nikarus/levitating_chess/levitating_chess_scientific_article_titles.md

# Scientific article title list for the levitating-chess / planar-motor research

## Core articles we directly used or discussed

1. **Modeling and comparison of the Halbach array with different segments per pole**  
   Yunfei Zhou, Guangdou Liu, Rougang Zhou, Ligang Huo, Wuyi Ming.  
   *International Journal of Applied Electromagnetics and Mechanics*, 2015.

2. **Modeling of magnetically levitated planar motors with moving magnets**  
   J.W. Jansen, C.M.M. van Lierop, E.A. Lomonova, A.J.A. Vandenput.  
   *IEEE Transactions on Magnetics*, 2007.

3. **Magnetically levitated planar motor with moving magnets**  
   J.W. Jansen, C.M.M. van Lierop, E.A. Lomonova, A.J.A. Vandenput.  
   *IEEE Transactions on Industry Applications*, 2008.

4. **On Improved Commutation for Moving-Magnet Planar Actuators**  
   Yorick Broens, Hans Butler, Roland Tóth.  
   2023.

## Closely related articles from the Halbach/planar-motor reference chain

5. **Analytical force calculations for high-precision planar motor with Halbach array**  
   H. Jiang, X. Huang, G. Zhou, Y. Wang, Z. Wang.  
   *IEEE Transactions on Magnetics*, 2009.

6. **Electro-dynamic planar motor**  
   J.C. Compter.  
   *Precision Engineering*, 2004.

7. **Analytical model of a magnetically levitated linear motor**  
   J.W. Jansen, E.A. Lomonova, A.J.A. Vandenput, C.M.M. van Lierop.  
   Industry Applications Conference, 2005.

8. **Design of a Halbach array based on optimization techniques**  
   J.S. Choi, J. Yoo.  
   *IEEE Transactions on Magnetics*, 2008.

9. **Analysis and optimization of a new 2-D magnet array for planar motor**  
   W. Min, M. Zhang, Y. Zhu, B. Chen, G. Duan, J. Hu, W. Yin.  
   *IEEE Transactions on Magnetics*, 2010.

10. **Modeling, analyzing, and parameter design of the magnetic field of a segmented Halbach cylinder**  
    T. Shi, Z. Qiao, C. Xia, H. Li, Z. Song.  
    *IEEE Transactions on Magnetics*, 2012.

## Older foundational Halbach / magnetic-array papers

11. **Design of permanent multipole magnets with oriented rare earth cobalt material**  
    K. Halbach.  
    *Nuclear Instruments and Methods*, 1980.

12. **Magnet arrays for synchronous machines**  
    D.L. Trumper, M.E. Williams, T.H. Nguyen.  
    IEEE Industry Applications Society Annual Meeting, 1993.

13. **Modeling maglev passenger compartment static magnetic fields from linear Halbach permanent magnet arrays**  
    J.F. Hoburg.  
    *IEEE Transactions on Magnetics*, 2004.

14. **Characteristic analysis of eddy-current brake system using the linear Halbach array**  
    S.M. Jang, S.H. Lee, S.S. Jeong.  
    *IEEE Transactions on Magnetics*, 2002.

15. **Comparison of coaxial magnetic gears with different topologies**  
    L. Jian, K.T. Chau, Y. Gong, et al.  
    *IEEE Transactions on Magnetics*, 2009.

16. **A novel linear and rotary Halbach permanent magnet motor with two degrees-of-freedom**  
    P. Jin, S. Fang, H. Lin, X. Wang, S. Zhou.  
    *Journal of Applied Physics*, 2012.

## Notes

- The most important articles for the actual chessboard actuator are probably titles 1–4.
- Titles 5–10 are useful for deeper Halbach/planar-motor modeling.
- Titles 11–16 are background/foundational references that may be useful when building the literature map.
- Separately from scientific articles, the important industrial systems to study are **Beckhoff XPlanar**, **B&R ACOPOS 6D**, and **Planar Motor / PlanarMotor** documentation.
