nikarus/levitating_chess/methodology/docs/MODELING_APPROACH.md

# Modeling scope and current evidence

The [simulator reference](SIMULATOR.md) owns architecture and verification rules; the [single-piece checklist](SINGLE_PIECE_TESTS.md) owns behavioral coverage; [NEXT_STEPS.md](../NEXT_STEPS.md) owns execution order. This document records current engineering evidence, its limits and the tool choices still in effect. Quantitative settings remain in the model parameter classes. Complete the virtual design before manufacturing or physical tests.

## Physical-model verification gate

**The bounded implementation-verification gate is complete; whole-product and hardware validation are not.** The [original verification record](../results/physics_verification/implementation_verification/summary.json) and [joint-integrator qualification](../results/physics_verification/joint_passive_filter/qualification.json) support single-piece airborne investigation with CAD geometry, averaged drivers and causal Hall/current sensing. Atlas acceleration has separate evidence below.

The supported local model uses the square-coil patch and CAD-derived king. Runtime guards enforce the configured gap/current/domain bounds, tilted-bottom clearance, finite states and supported current extinction. Contact, reconduction and changing the controlled coil window remain outside this airborne path. Numerical verification does not establish unknown materials, component specifications, controller robustness or every possible trajectory.

| Verified mechanism | Authoritative evidence |
|---|---|
| CAD mechanics, coordinate frames, clocks, causality and replay | Component checks and recorded selections in the [simulator reference](SIMULATOR.md#general-properties-and-existing-checks) and frozen verification records |
| Curved-conductor force/torque and spatial refinement | [Curved force and independent flux derivative](../results/physics_verification/implementation_verification/curved_force/summary.json) |
| Force/back-EMF reciprocity, winding work and coupled dynamics | [Independent coupling references](../results/physics_verification/implementation_verification/independent_coupling/summary.json) |
| Joint temporal integration, switching, passive Hall filter and restart | [Joint qualification](../results/physics_verification/joint_passive_filter/qualification.json) and [combined sensor budget](../results/physics_verification/joint_passive_filter/verified_sensor_budget/summary.json) |
| Atlas field/force accuracy and closed sensor feedback | [Field screen](../results/hover/joint_control/atlas_backend/fields/summary.json), [coupled comparison](../results/hover/joint_control/atlas_backend/coupled/summary.json) and [combined sensing check](../results/hover/joint_control/atlas_backend/sensing/summary.json) |

These are sampled and bounded comparisons, not a rigorous global error certificate. The joint sensing benchmark's largest combined discrepancies are 0.206/0.214 µT against its unchanged 0.566 µT allowance. The atlas startup sensing check reaches 0.18105 µT under that same allowance. Conductor, trajectory, temporal/filter and independent-reference contributions are included without relying on cancellation. Energy consistency supplements state and field checks; it cannot alone establish trajectory accuracy.

Source, dependency and parameter identities in each record belong to that execution. Source archives preserve reproducibility across later edits, including output-path cleanup. Never replace recorded fingerprints or resume an old checkpoint with changed sources. A newly configured run needs its own provenance and compatible cache.

## Current motion interface

The [MuJoCo scene](../results/motion_scene.xml), [preview](../results/motion_scene.png) and [contact demonstration](../results/motion_scene.mp4) reuse the square assembly's mass, centre of mass and full inertia tensor. The [motion interface record](../results/motion.json) checks analytical force/rotation, free fall, contact impulse and a short prescribed-current magnetic case. The video is an unpowered drop/slide diagnostic, not controlled flight.

Contact uses a bottom-film cylinder and an interior-board plane with provisional friction/compliance. Piece-to-piece contact, board edges, deformation and detailed material damping remain unqualified. The [moving Hall screen](../results/sensing.json) retains a failed finer-resolution landing comparison; airborne success does not close this contact limitation. Geometry and construction uncertainties are maintained in [COILS.md](COILS.md).

## Current Hall interface

Sequential Hall sampling, analogue filtering, ADC rounding, calibration errors, noise and delayed delivery are represented. The estimator uses measured currents for coil-field subtraction and nominal geometry for pose estimation. It receives no true pose or hidden plant properties. The architecture and timing contract live in [SIMULATOR.md](SIMULATOR.md#scope-and-information-flow).

The retained [single-count response](../results/hover/count_response_extended/summary.json) shows why digital trace identity is not equivalent to physical tracking: one changed Hall ADC count produced persistent current differences while both trajectories stayed within operating limits over the recorded interval. This is bounded disturbance evidence, not general recovery qualification. Preserve physical noise and hardware quantization during numerical comparisons; do not use numerical error as a substitute for real interference.

## Joint integration review

The [reduced solver comparison](../results/physics_verification/solver_review/summary.json) supports RK45 as the joint integration starting point against independent DOP853/Radau references. It uses manufactured coupling equations and cannot predict full CAD-field performance. The [interior-release diagnosis](../results/hover/interior_release/diagnosis.json) records the duration-dependent cost of the earlier partitioned work-budget method. Those legacy paths remain for their reference checks; they are not the current flight runner.

## Joint integration candidate

The verified [joint method](SIMULATOR.md#joint-integration-candidate) integrates mechanics, winding currents, command filtering and work together, then resolves the passive Hall filter along the dense trajectory. The [qualification record](../results/physics_verification/joint_passive_filter/qualification.json) includes independent temporal/energy references, current extinction, sensor timing and exact restart with pending samples. It replaces the affected partitioned-method checks without relaxing acceptance limits. The controlled hover and local movement below use this method.

## Current airborne interface

| Retained trial | Measured outcome | Scope |
|---|---|---|
| [Direct-field hover](../results/hover/joint_control/summary.json) | 50 ms; all operating/energy limits pass; 49 moving scans; 21.92 h runtime | Direct comparison reference |
| [Accelerated hover comparison](../results/hover/joint_control/atlas_backend/hover/comparison.json) | Same 50 ms; all operating and comparison checks pass; 4.69 h runtime, 4.68× complete-run acceleration | Verified acceleration of this nominal hover |
| [Native hover comparison](../results/hover/native_spline/qualified/trial/comparison.json) | Same 50 ms; all operating, energy, trajectory and analogue checks pass; 61.3 min runtime, 4.59× faster than the SciPy atlas run | Verified native runtime for this nominal hover |
| [Local movement](../results/local_motion/trial/summary.json) | 60 ms including a 0.3 mm sideways move and 0.01 rad yaw; all operating/energy limits pass; 59 moving scans; 6.18 h runtime | First short combined commanded movement |

The local movement reaches peak physical tracking errors of 67.72 µm and 3.067 mrad, peak current 2.431 A, voltage 1.352 V and instantaneous copper loss 8.347 W. Its accumulated absolute total-energy discrepancy is 0.600 nJ against 22.29 nJ. The [tracking plot](../results/local_motion/trial/tracking.png) shows overshoot within limits; endpoint error and velocity remain nonzero, so the short hold does not establish settling. The [multiview replay](../results/local_motion/trial/motion.mp4) uses saved poses with labeled slowdown and no motion exaggeration.

The movement's [field cache verification](../results/local_motion/fields/summary.json), stationary-prefix comparison and [saved-evidence verification](../results/local_motion/trial/verification.json) retain field/force/gradient checks, report/checkpoint agreement, source/archive identity and exact dense current/filter reconstruction. Exact executed sources and raw scans remain with the trial. No noise, control gain, hardware rate or acceptance limit was changed for this movement.

The local controller currently holds a fixed coil/sensor window. Stationary Hall acquisition precedes release, winding currents start at zero, and all subsequent support comes from modeled electromagnetic forces. Sustained control, endpoint settling, large rotations/tilts, handoffs, takeoff/landing, neighbours and full-board movement remain unqualified. The [legacy stacked reference](QUALIFICATION.md) describes a different geometry and must not supply current square-coil hardware ratings.

The [longer move-and-hold trial](../results/local_motion/settling/trial/verification.json) **fails angular settling**. It retains the same 0.3 mm translation and 0.01 rad yaw command, completed at 50 ms, followed by a planned 200 ms hold. The final 100 ms observation window uses the existing 160 µm position and 0.005 rad orientation limits, plus provisional residual-speed limits of 1.6 mm/s and 0.05 rad/s derived from one pose-error budget over that window. These are initial settling criteria, not validated product vibration requirements. Accepted integration endpoints and midpoints first exceed the angular-speed limit at approximately 190.606 ms; the checkpoint guard stops the run at 191 ms, before the requested 250 ms. Peak angular speed in the observed settling window is 0.052986 rad/s (3.036°/s) against 0.05 rad/s (2.865°/s). Position error, orientation error and linear speed in that window peak at 50.95 µm, 0.001517 rad and 1.028 mm/s. Overall peak current is 2.440 A and peak voltage is 1.358 V. All 190 independent sensing checks pass, with maximum combined error 0.05824 µT against 0.100 µT; accumulated total-energy defect is 2.86e-9 J against 2.23e-8 J.

The [saved-motion analysis](../results/local_motion/settling/trial/settling_analysis.json) and [settling plot](../results/local_motion/settling/trial/settling.png) show continuing small angular motion with reversals, without monotonically increasing window peaks. The record does not establish eventual recovery. The [multi-view replay](../results/local_motion/settling/trial/video.mp4) includes perpendicular gap views, labels the failed outcome and uses the last recorded command-rate pose at 190.75 ms; the dense trajectory and checkpoint extend to 191 ms. Cache preparation takes 2,503 s, simulation/recording 5,653 s plus 130 s setup, and independent sensing verification 1,057 s. The failed evidence and acceptance limits remain unchanged.

The [feedback replay](../results/local_motion/settling/feedback/summary.json) exactly reproduces the recorded observer state, noise sequence and poses, and reconstructs current commands within floating-point roundoff. At 190.5 ms, actual pitch velocity is −2.45°/s while the estimate is +0.90°/s, so the velocity damping contribution acts in the wrong direction. Current-command quantization contributes substantially less angular-acceleration variation than velocity-estimation error. The [sensor isolation](../results/local_motion/settling/sensors/summary.json) reduces settling-window angular-velocity estimation RMS error from 0.0371 to 0.00586 rad/s when post-release Hall noise and quantization are removed diagnostically; exact coil-field subtraction alone only reduces it to 0.0367 rad/s. The [readout decomposition](../results/local_motion/settling/sensors/readout_components.json) separates channel-mean additive noise (11.31 µT RMS) from ADC quantization (0.442 µT RMS). This identifies modeled Hall noise as the dominant source of the observed velocity-estimation error; removing it is not a proposed physical correction.

The [observer screen](../results/local_motion/settling/observer/summary.json) retains all noisy readings and tests the existing bandwidth candidates. Reducing observer bandwidth from 20 to 10 Hz reduces angular-velocity estimation RMS error by 69% during settling (0.0371 to 0.0116 rad/s) and 33% over the full hold; increasing it to 40 Hz worsens the error. Full-record RMS velocity error is essentially unchanged, and all candidates keep sampled position/orientation estimation errors within the existing pose limits. These are observer bandwidths, not sensor sampling or controller update rates. The lower bandwidth is now applied for the approved coupled validation; it is not yet a validated flight setting: the replay holds physical motion, acquired initial observer state and nominal acceleration inputs fixed. Only the observer frequency ratio changes for this experiment; modeled noise, update rates, controller gains and all acceptance limits remain unchanged. Coupled validation must check both movement response and settling with fresh initialization.

## Retained diagnostics

Keep numerical failures that explain current safeguards or unresolved limitations. The [force-budget diagnosis](../results/physics_verification/force_budget/summary.json) motivated curved CAD quadrature; the [variable-coupling failure](../results/physics_verification/variable_coupling/summary.json) exposed accumulated work error; the [simultaneous-extinction diagnosis](../results/physics_verification/joint_passive_filter/simultaneous_extinction_diagnosis.json) exposed a missed switching event. The [error-growth analysis](../results/physics_verification/error_growth/summary.json) distinguishes physical open-loop instability from numerical error. Their original sources and outcomes remain unchanged.

Older prescribed-input handoff and fixed/adaptive comparisons remain mechanism evidence under their recorded configurations. They are not all prerequisites for reading the current plan, and they must not be relabeled as current flight qualification. Reproducible obsolete review exports and historical prose are removed; Git retains their history.

## Next performance work

The [native hover comparison](../results/hover/native_spline/qualified/trial/comparison.json) passes the complete retained 50 ms horizon in **3,675 s (61.3 min)**, versus 16,877 s (4.69 h) for the SciPy-atlas reference: **4.59× measured runtime improvement**. The candidate uses four persistent native query workers and one BLAS thread. Both runs use 2,701 accepted steps, 24,094 physical RHS evaluations and 35,428 passive-filter evaluations, delivering 49 moving Hall scans. The gain is implementation performance, not fewer samples or looser solver settings. Timings are observed on this machine, not guaranteed across machines or workloads; the candidate trial timer excludes setup/cache preparation.

All operating, energy, trajectory, peak and raw analogue-scan comparisons pass. Maximum physical position/current differences are 3.31e-17 m and 9.10e-15 A; estimated position/orientation differences are 3.13e-11 m and 1.61e-9 rad. The largest raw analogue difference is 1.16e-14 T against the unchanged 1e-7 T limit. Accumulated absolute electrical–mechanical energy defect is 1.74e-9 J against 2.23e-8 J. Recorded data and dense trajectories support replay without rerunning magnetics. This qualifies the implementation change for this nominal hover, not all movement, disturbances or hardware.

The explicit [native runtime](../magnetic_spline.py) evaluates the same tensor-product spline representation, preserving grid, knots, order, conductor samples and summation. It retains the SciPy evaluator as a reference and records native source/binary identity, worker count, BLAS libraries/thread policy and dependency identity in checkpoints. Native evaluation must be explicitly active when creating or restoring its simulation. Leaving the runtime context restores SciPy and closes workers; the configured simulation rejects a later mismatched evaluator. Numerical settings remain in `Fixed`. No fast-math flags or new environment packages are required. Thirty-five focused atlas, native, joint and adaptive tests pass, including parallel equivalence/failure propagation, exact restart and changed runtime identity rejection.

The [preflight](../results/hover/native_spline/qualified/preflight.json) creates a new cache under current sources rather than bypassing stale-cache guards. Its grid matches the retained cache exactly, but coefficient roundoff differs by up to 7.23e-13 because of the historical magnet-placement sequence. The initial exact-rebuild rejection is preserved in [cache evidence](../results/hover/native_spline/cache_roundoff/preflight.json). The fresh coefficients pass the existing numerical-equivalence tolerances; sampled field and actuator-matrix differences are 4.82e-15 T and 3.12e-16. The actual initial physical, sensor and random-generator state matches the saved hover exactly. Old provenance is unchanged; both the rejected preparation and accepted run retain their executed sources. Existing diagnostic snapshots remain non-resumable as production checkpoints.

Supporting [field/force/gradient screening](../results/local_motion/spline_evaluation/summary.json), [short coupled comparison](../results/local_motion/spline_evaluation/coupled/summary.json), [startup profile](../results/local_motion/spline_evaluation/profile/summary.json) and [worker-policy screen](../results/local_motion/spline_evaluation/worker_policy/summary.json) isolate the implementation changes. The field screen covers recorded and domain poses; the coupled screen also checks tighter integration. The startup profile distinguishes already-cached CAD quadrature work from repeated work. Worker screening shows that limiting competing BLAS pools helps native queries, and that removing inexpensive validation guards is not justified. These narrower timings do not replace the complete-run result above.

The retained native profile points to force evaluation/assembly, rigid magnet placement and direct Hall evaluation. It is not a full-run attribution, and nested/threaded profile times must not be added as independent percentages. Full movement timings for the further coil-cache optimization appear below; hover extrapolations no longer define the current performance estimate.

The [direct Hall screen](../results/local_motion/hall_evaluation/screen/summary.json) compares the current object-reset path, a canonical object collection and Magpylib's [functional interface](https://magpylib.readthedocs.io/en/stable/_pages/user_guide/docs/docs_fieldcomp.html#functional-interface). It retains finite cuboids and analytical fields; only geometry preparation and dispatch change. Eighteen recorded/domain poses, six-axis derivatives, per-observation moving poses and exposure-sized estimator batches pass unchanged tolerances. Maximum functional field/derivative differences are 1.50e-15 T and 1.09e-10 in the derivative's SI units. Across 964 queries per repeat, median times are 11.70 s current, 2.78 s canonical objects and 2.27 s functional: **5.16× for this mixed sensing workload**. These timings are query-workload dependent.

The [short coupled comparison](../results/local_motion/hall_evaluation/coupled/summary.json) uses the qualified native force evaluator, a common acquired starting state and unchanged noise, controller, hardware clocks and tolerances. Current sensing takes 177.52 s; functional sensing takes 154.66 s: **1.15× complete-loop speedup, or 12.9% less elapsed time**, over 2 ms. Both take 137 accepted steps, 1,144 physical and 1,618 filter evaluations and deliver one moving scan. Saved dense trajectories, raw analogue samples, recorded motion/current/estimate values and energy totals match exactly. This is a promising short implementation check, not a measured gain over the full 50 ms or a qualification of movement. The candidate remains in the benchmark; production sensing is unchanged. Diagnostic snapshots forbid production resume, and both screens retain their executed sources.

The production coil cache now provides the substantial runtime reduction sought here. Further optimization, including the separate Hall candidate, is optional and should not delay flight experiments. Short benchmarks serve as feasibility gates, not permanent simulation modes; reject marginal candidates before adding runtime complexity. Retain geometry/domain validation, physical sensor noise and numerical limits.

The production approach is a reusable unit-current coil-field cache, evaluated over finite magnet surfaces instead of sampling the magnet field along every wire. The [direct surface screen](../results/local_motion/coil_surface/summary.json) passes six recorded/extreme-tilt poses with all 25 active coils. Surface quadrature uses 51,200 field queries versus 228,000 wire queries, a 4.45-fold reduction. Both wire resolution and selected worst-error/high-authority magnet surfaces are independently refined. The largest force/COM-torque relative discrepancy is 4.29e-10 against the unchanged 1e-4 limit. This uses the curved CAD winding and its return conductor, preserving finite magnet dimensions. The [surface-force/torque formulation](https://arts.units.it/bitstream/11368/2903285/1/03.16101103.pdf) and existing flux/work references provide independent verification routes.

The selected production setting is the cubic **0.25 mm coil cache**. Its [spatial screen](../results/local_motion/coil_surface/cache_dense/summary.json) passes seeded off-grid field/gradient checks and the six retained force/torque poses. Maximum field error is 1.59e-9 T against 1e-7 T; relative gradient error is 1.96e-5 against 1e-3. Maximum force/torque column errors are 4.61e-7 and 4.66e-7 against 1e-4. Grid storage is **116.14 MB**, with **2,413 s** spent evaluating the grid. Median matrix time is **22.66 ms versus 87.56 ms**, a **3.86× matrix-evaluation speedup**. These are component timings, not complete-loop performance. The [derivative/work/independent-flux verification](../results/local_motion/coil_surface/coupling_dense/summary.json) also passes, including refinement against the former 0.5 mm cache. Every requested sample must stay inside the saved exterior domain; extrapolation is forbidden.

**The [complete matched-drive movement](../results/local_motion/coil_surface/dense_matched_drive_movement/summary.json) passes its bounded numerical checks and nominal feedback-controlled movement over 60 ms.** One optimized sensor-feedback loop supplies its recorded setpoints and applied voltages to native-reference and tighter cached physical replays. Each replay independently integrates currents, back-EMF, mechanics and passive Hall sensing. Same-estimate controller allocations are compared separately, without substituting reference results into the running controller. Quantization, calibration, noise, hardware clocks, controller gains and acceptance limits are unchanged.

Across all three physical comparisons, the largest position/orientation/current differences are **1.25 nm**, **3.10e-8 rad** and **0.167 µA**, against 8 µm, 0.00025 rad and 27.5 mA. The largest raw Hall difference is **0.05714 µT against 0.100 µT**. Independent calibrated-field convolution checks all 59 delivered scans in each case; maximum sensing errors are 0.05800 µT normal and 0.02701 µT tighter. All 241 same-estimate allocation checks pass, with maximum requested-current difference **0.880 µA**. The optimized feedback movement peaks at 2.440 A and 1.358 V, position tracking error 67.12 µm, angle tracking error 0.003062 rad and observer position error 53.71 µm, within the existing operating/tracking budgets. Its accumulated absolute energy defect is 3.68e-10 J against 2.23e-8 J.

The complete qualification batch takes **10,489 s (2 h 55 min)**. The optimized movement itself takes **1,972 s (32.9 min)** for simulation, or **2,332 s (38.9 min)** including independent sensing verification and recording; shared setup is excluded. Its timed loop includes the extra same-input controller-allocation check. Native and tighter replays take 4,801 s and 1,997 s for simulation, but omit feedback computation, so their ratio is **not an end-to-end speedup measurement**. Earlier [independent-loop prefix timings](../results/local_motion/coil_surface/winding_response_movement/summary.json) measured 2.55× over 19 ms with the former cache; do not extrapolate that as a measured complete-movement gain for the new cache.

Numerical qualification remains bounded to this nominal CAD king, local coil/sensor window and small combined translation/yaw reference. Deliberate disturbance recovery, endpoint settling, longer horizons, contact, handoffs, construction variation and other pieces remain unqualified. Physical replays deliberately report no controlled-flight pass; the batch distinguishes their numerical result from the one actual feedback movement. Cache/source/runtime/input identities, exact executed sources, raw scans, dense trajectories, drive histories and diagnostic-only snapshots are retained. The normal simulator exposes this evaluator through its magnetic backend for controller allocation, physical forces and reciprocal back-EMF. Cache persistence, bound winding geometry, domain checks, native runtime identity, recording continuation and deadline/failure paths have focused integration tests.

**The [production readiness gate](../results/local_motion/optimized/production_readiness/summary.json) passes.** The [fresh production cache](../results/local_motion/optimized/canonical_fields/summary.json) has maximum off-grid field error 1.59e-9 T against 1e-7 T. Integrated force/torque comparisons at startup, early movement and the planned endpoint remain below 3.79e-7 relative error against 1e-4. The normal runner completes a 12 ms sensor-feedback experiment spanning startup and the first 2 ms of commanded movement. A fresh-process restart at 10.1 ms, during pending Hall acquisition, reproduces the uninterrupted final checkpoint, raw scans and dense trajectory exactly. All 11 independent sensing checks pass; maximum combined error is 0.05042 µT against 0.100 µT. Operating and numerical limits remain unchanged. Source, cache, native-runtime and input identities are retained with the executed sources. This establishes integrated-runner readiness within the stated scope, not the remaining flight envelope.

The normal 12 ms run takes **362.3 s (6.04 min)** including recording, plus **144.1 s (2.40 min)** setup. Integration accounts for 346.1 s of that run; recording takes 1.21 s. These are overlapping components, not additive timings. Independent sensing verification takes another 61.7 s. The entire readiness batch, including both execution branches and matrix/sensing checks, takes **1,328 s (22.1 min)**. Fresh cache preparation takes **2,470 s (41.2 min)** and is reusable while its guarded sources and geometry match. A 50 ms run is therefore estimated at roughly **30 minutes with an existing cache**, consistent with the earlier complete diagnostic movement; it is not yet a measured 50 ms production run.

Restart verification requires identical initial CAD properties, history-independent magnet placement and preserved controller-matrix storage order. Retained attribution records isolate [independently rebuilt CAD](../results/local_motion/optimized/readiness/restart_attribution.json), [incremental placement roundoff](../results/local_motion/optimized/shared_initial_readiness/restart_attribution.json) and [matrix accumulation order](../results/local_motion/optimized/canonical_readiness/restart_attribution.json). These regressions are covered by shared initial checkpoints, canonical pose reconstruction and matrix-layout tests; the failed records remain unchanged. Diagnostic caches and checkpoints cannot be relabeled as production artifacts.

The retained failures explain the acceptance basis and cache resolution. The [original raw-signal failure](../results/local_motion/coil_surface/movement/summary.json) was dominated by genuinely different coil currents in independently evolving controllers. [Recorded attribution](../results/local_motion/coil_surface/movement/sensor_attribution/summary.json) and [controller/packet replay](../results/local_motion/coil_surface/matched_input_movement/controller_replay/summary.json) identify the feedback path through finite sensor counts, coil subtraction, velocity estimation and command rounding. The [18 ms comparison](../results/local_motion/coil_surface/matched_input_movement/summary.json) and [19 ms comparison](../results/local_motion/coil_surface/winding_response_movement/summary.json) remain failed independent-loop evidence, not operating overcurrent or proof of instability. The [identical-drive prefix replay](../results/local_motion/coil_surface/winding_response_movement/shared_drive/summary.json) separates physical integration accuracy from those changed feedback inputs. Numerical accuracy is now compared under matched drive; feedback robustness requires its own disturbance/recovery evidence rather than identical rounded current histories.

The same [saved-signal decomposition](../results/local_motion/coil_surface/matched_input_movement/sensor_attribution/summary.json) found an avoidable coil-subtraction bias: straight-line reconstruction of perfect current samples produced up to 24.53 µT error, while nominal exponential winding reconstruction reduced that component to 0.00166 µT. Measured subtraction now reuses the shared nominal L/R and exponential filter implementation, with no access to true currents or calibration. An independent analytic winding-response test checks it. This improvement concerns one reconstruction component, not total sensor error; varying back-EMF, inductance uncertainty and within-sample switching/extinction remain limitations.

The [0.5 mm matched-drive attempt](../results/local_motion/coil_surface/matched_drive_movement/summary.json) stops at 36 ms despite passing motion/current and independent per-trajectory sensing checks. At its failing Hall sample, [independent attribution](../results/local_motion/coil_surface/matched_drive_movement/sensor_attribution/summary.json) separates **0.074866 µT** from differing physical histories and **0.031393 µT** from filter integration, exceeding the unchanged 0.100 µT combined limit. The denser cache reduces force error by approximately sixteenfold and passes the complete movement above without relaxing this gate. The [coarse-cache failure](../results/local_motion/coil_surface/cache_coarse/summary.json), [former spatial screen](../results/local_motion/coil_surface/cache_refined/summary.json) and [former work check](../results/local_motion/coil_surface/coupling/summary.json) remain refinement evidence; a spatial screen alone does not establish the combined application budget.

## Remaining physical uncertainties

| Area | Modeled now | Still needs evidence |
|---|---|---|
| Sensors | Sequential sampling, filter response, noise, quantization, calibration and measured-current correction | Actual parts, settling/jitter, effective ADC accuracy, reference/supply rejection, transport and computation delay |
| Drivers | Sampled regulator, averaged RL response, current/command quantization and voltage limits | Self/mutual inductance, PWM interference/aliasing, switching and return-path effects, rail dynamics |
| Construction and environment | Nominal CAD king, winding and local patch | Magnet and mass variation, sensor alignment, temperature drift, neighbouring magnets, external fields and vibration |
| Numerical approximation | Independent references, bounded refinement, runtime guards and energy accounting | Application-horizon uncertainty and any new mechanisms or domains |

The coil electrical screen still exceeds the ripple allowance under its low-inductance assumption; averaged-flight results do not remove this failure. Resolve or bound switching/current-readout effects before adopting hardware targets. Use component and circuit evidence to define disturbances; arbitrary white noise is not a model of every interference source. Existing noise assumptions are provisional, including the typical-noise specification in the [DRV5055 datasheet](https://www.ti.com/lit/ds/symlink/drv5055.pdf).

## Full engineering scope

| Area | Questions to resolve | Initial approach and escalation |
|---|---|---|
| Coil construction and packaging | Insulated winding fit, bend radii, transitions, terminals, neighbouring coils and layer placement | build123d continuous conductor and assembly geometry; published wire/process constraints |
| Piece geometry and mass | Magnet positions, mass, centre of mass, inertia and clearances | Current CAD-derived mass, centre of mass and inertia with explicit material/construction uncertainty |
| Magnetic fields, forces and torques | Lift and six-axis authority across positions, orientations and board edges | Existing Magpylib-based calculations; electromagnetic FEM checks at selected difficult configurations |
| Coil electrical behaviour | Resistance, self/mutual inductance, current distribution and frequency-dependent losses | Existing estimates with uncertainty bounds; targeted Elmer electromagnetic analysis where uncertainty affects driver or thermal design |
| Motion and control | Hover recovery, complete lift/fly/land, tilt/yaw, delays, disturbances and coil handoffs | MuJoCo rigid-body dynamics coupled to the existing controller, virtual sensor readings and electrical/magnetic models |
| Neighbours and contact reset | Magnetic interference, shared-coil constraints, friction, tipping and collision-free routing | Existing magnetic calculations and trajectory planning with MuJoCo contact/friction; small groups before full-set reset |
| Temperature distribution | Winding, magnet, electronics and touch-surface hot spots over time | Elmer thermal FEM of a representative assembly; improve the existing workload/thermal model from the results |
| Cooling | Heat rejection under the actual enclosure and quiet operation | Existing heat balance and bounded cooling/contact assumptions; detailed airflow simulation only for a specific unresolved cooling decision |
| Pose sensing | Accuracy, delay, coil-field contamination, neighbour interference and calibration | Existing field/sensing model, real sensor specifications and simulated interference/delay |
| Current drivers | Tracking, ripple, losses, voltage overshoot, component stress and current measurement | KiCad/ngspice circuit simulation of a representative channel |
| Power distribution | Supply size, voltage drop, regenerative absorption, midpoint balance and startup | Existing load/energy accounting plus selected circuit simulations |
| PCB implementation | Current paths, grounding, clearances, sensor interference and mechanical fit | KiCad electrical/layout checks, electrical calculations and signal-integrity checks; STEP assembly exchange |
| Processing and communication | Acquisition, computation and command deadlines | Existing timing budgets, algorithm costs and candidate controller specifications |
| Deformation, vibration and sound | Gap changes from bending/expansion, mechanical resonance and audible operation | CAD and simple calculations; structural/acoustic analysis where necessary |
| Faults and variation | Sensor/channel failure, power interruption, lifted pieces and manufacturing spread | Existing-model scenario/parameter sweeps, with modeled protection and recovery behavior |
| Manufacturing and cost | Purchasable parts, custom parts, quantities, tolerances and assembly costs | KiCad electronics BOM plus mechanical/custom-part records and supplier quotations |

Build123d/FreeCAD, MuJoCo and the existing Python/Magpylib calculations are integrated. KiCad and ngspice are now used for the electronics study; Elmer/Gmsh remain planned for the representative thermal tile. Reuse the existing model before adding another solver; verify material assumptions, boundary conditions and numerical convergence for each new analysis. CAD defines geometry, not magnetic or thermal correctness.

## Thermal scope

The current thermal model uses simplified heat paths and thermal masses. It estimates temperatures and endurance but does not resolve the detailed spatial distribution through the coil assembly. For the baseline cost estimate, update this Python model first, then analyze a representative tile with Elmer/Gmsh and simplified FreeCAD geometry. Escalate to full-board spatial detail and airflow only where the cooling or enclosure decision requires them. Include component and surface temperatures in the estimate before fixing the cooling BOM.

Begin with windings, insulation/potting, playing surface, PCB, thermal interface and baseplate. Include relevant magnet/piece contact or air-gap conditions for the chosen operating cases. Use a winding-pack approximation with effective material properties initially; resolve individual layers only when the question requires it. Bound uncertain contact resistance and cooling conditions instead of treating them as known facts. Check numerical convergence and sensitivity to uncertain material, contact and cooling properties. Physical comparison belongs to the later validation stage.

Reuse recorded electrical workloads as time/location-dependent heat sources when their operating conditions remain applicable. Preserve mean-square current and add ripple, switch, shunt, logic and supply losses; the averaged-flight model alone does not contain all of these. Return hot resistance and component-temperature effects to electrical calculations. Keep local flight, repeated dwell and simultaneous sliding reset distinct. This work must explain or resolve the existing thermal failures. It must not replace them with a passing result through unsupported cooling assumptions, relaxed limits or omitted demanding workloads.

## Real components and BOM

Associate each selected electronic part with its manufacturer and exact part number, supplier reference, datasheet, footprint and, where available, a compatible simulation model. KiCad can export the selected component fields and quantities. Combine that electronics BOM with custom coils, magnets, mechanical parts, wiring, assembly and current supplier quotations. [KiCad BOM export](https://docs.kicad.org/9.0/en/eeschema/eeschema.html#generating-a-bill-of-materials).

A purchasable part, schematic symbol, footprint and validated simulation model are different assets. Check pin mapping, package dimensions, model compatibility and modeled operating conditions. Prices and stock require separate sourcing checks. Preserve the current model BOM as a labeled allowance until actual selections replace it; do not count the allowance and selected parts twice.

### Baseline electronics interface

The [requirements audit](../results/electronics/baseline_requirements/requirements.json) separates current model assumptions from the recorded, verified bounded move-and-hold flight. Its source archive retains the exporter and reference summaries/checkpoint. Regenerate into a fresh results directory with `methodology.electrical --flight-evidence <completed-trial> --output <fresh-directory>`. Quantitative requirements remain in `Inputs`/`Fixed`/`Constants`; the export is derived evidence, not a second editable settings file.

The reference uses 25 driven channels and 16 Hall observation channels. Its configured current acquisition implies 500,000 samples/s and 8 Mbit/s of raw sample payload over that local window. The Hall averaging schedule implies 256,000 conversions/s and 4.096 Mbit/s of raw payload. These are aggregate conversion/data requirements before protocol overhead, not necessarily external-link traffic or the physical tile size. Local processing can retain data at its point of use. The installed whole-board count must be derived from the square coil geometry rather than the older stacked `CoilBed` quantities.

The hardware gap is functional: the current simulator's regulator, Hall coil-field subtraction and observer all consume sampled current readings. The legacy comparator/delta-sigma BOM is a historical reference only, not a required architecture or a source of trusted prices. Build a new realizable local acquisition/regulation circuit before establishing its per-channel cost. The simulated current channels are sampled together and available immediately; conversion delay, multiplexing skew, PWM sample placement and communication delay need an explicit hardware timing budget and corresponding model evidence. Nominal converter bits are not effective resolution or total accuracy: the export keeps quantum, random noise, offset and gain error separate. Pose-loop dynamics, command/feedback rates, current-loop dynamics and PWM carrier are also distinct.

The successful reference's reported peak winding loss is 4.962 W over its short local motion. This is neither whole-board heat nor an electronics/cooling rating. The source explicitly omits PWM ripple, mutual inductance, bus dynamics and thermal feedback. Retain those limitations when using the trace and bound the unqualified product workloads. The old thermal assumptions and historical BOM prices remain allowances, not selected cooling hardware or current quotations.

KiCad will own connectivity, component identity and footprints, with hierarchical channel/tile reuse and exported quantities. Use ngspice for targeted circuit-function checks in addition to ERC and visual inspection. Model-owned quantitative settings should feed circuit calculations and exports rather than becoming independent tuning variables in scripts. Complete the repeated channel and shared functions, then establish realistic tile placement, layer/copper and critical routing before scaling costs. Full-board routing follows once the baseline cost and thermal trade-offs justify it.

### Electronics verification coverage

The editable repeated channel uses the candidate DRV8962DDV bridge, two separate return shunts per coil, one INA181A1 and a physical output RC filter. The [schematic review](../results/cad/electronics/low_side_channel/summary.json) owns connectivity, component quantities, footprints and remaining ERC errors. This is not yet a complete electronics simulation or production selection. Quantitative settings remain in the model classes.

| Function | Current implementation | Remaining verification |
| --- | --- | --- |
| Bridge, coil and returns | Physical switched RL circuit, capacitor returns, body diodes, exact Jacobian; native dual-coil sheet | Driver uncertainty, input loading, motion voltage, mutual coupling and hot-component corners; no adequate manufacturer driver transient model found |
| Current acquisition | Separate PGND shunts, INA181, output RC; unchanged TI model replay; paired SAR timing model | Full noise/error allocation, calibration, temperature, switching recovery and latest-waveform replay |
| ADC and reference | ADS8698/REF5025 sheet composed with channels, controller and protection; modeled filter/conversion schedule | Reference loading/noise, effective capacitance, calibration, sleep/wake and cost |
| Hall acquisition | Existing magnetic/sensor model | Hardware sheet, acquisition timing, PWM interference and current-readout alignment |
| Digital regulation and transport | Compiled eight-channel feedback loop, measured-zero calibration, phased PWM and independent serial validation | MCU DMA/register deployment, phase synchronization, communications and execution-time verification |
| Power and regeneration | Coupled shared-bus current regulation, source limits, returned energy and capacitor ripple sizing; behavioral sleep/wake interlocks | Shared distribution, auxiliary rails, selected source/clamp, parasitics, ripple/lifetime, rail startup and simultaneous workload qualification |
| Protection and lifecycle | Native shared watchdog, asynchronous fault latch and independent enables; fault tests and resolved disabled-bridge diode paths | Independent rail supervision, arbitrary overcurrent limiting, complete shutdown timing, cold startup and sleep/wake |
| PCB, heat and cost | Composed group includes controller and watchdog; earlier placement is superseded as a density claim | Shared-power and Hall area, revised placement, critical routing, heat paths, workload thermal model and production cost |

**Circuit evidence.** The [physical bridge/readout comparison](../results/electronics/low_side_readout/physical_return_paths/settled_bridge_readout/summary.json) resolves actual PGND and bypass-current paths. Radau integration with an exact Jacobian and periodic shooting provides the physical trace; independently tested derivatives and power balance check the equations. The calculated terminal voltages drive the unchanged TI INA181 model in ngspice. Four steady-current cases pass carrier-mean numerical refinement. This separate-solver method does not claim to have repaired full coupled SPICE convergence; [the retained failures](../results/electronics/low_side_readout/physical_return_paths/failed_checks.zip) explain that limitation.

The [loaded-filter replay](../results/electronics/low_side_readout/acquisition/loaded_filter_replay/summary.json) includes the actual output RC and nominal ADC loading. The [sampling comparison](../results/electronics/low_side_readout/acquisition/loaded_filter_sampling/summary.json) checks paired samples, quantization, one shared two-point calibration and resampling refinement. Calibration assumes ideal known-current references; a production calibration circuit/procedure is still needed. Typical ADC internal filtering is an approximation, not a manufacturer transient model.

**Control evidence.** The [integrated current-delivery screen](../results/electronics/system/current_delivery/summary.json) passes fourteen cases with eight independently controlled physical winding/filter states, generated ADC frames, compiled C regulation, scheduled PWM commits and power sequencing. It includes idle zero calibration, distinct and simultaneous commands, supply/inductance/filter/gain corners, noise, malformed frames, missing commits and injected power-health loss. Each case repeats with tighter integration. Worst screened peak including the conservative ripple reserve is **6.202 A against 6.5 A**; worst settled current error is **0.1046 A against 0.1775 A**. Shared-bus voltage spans **23.145–24.560 V**. These are bounded averaged-plant results; they do not qualify switching parasitics, real rail supervision, all workloads or the whole electronics assembly.

The physical plant supplies every measurement; the controller receives no actual winding current or hidden plant parameters. The common ADC encoder uses the [ADS8698 straight-binary transfer](https://www.ti.com/lit/ds/symlink/ads8698.pdf), with midpoint reconstruction and measured idle offset removal. Generated C settings predict each channel's own actuation time. Source/settings/binary guards reject stale compiled code. An independent counter-sequence test checks phase-correct latching. The source archive preserves the exact executed implementation.

Resolved switched-circuit reversals pass at the [earliest latch](../results/electronics/current_loop/phase_validation/channel_4/summary.json) and [latest latch](../results/electronics/current_loop/phase_validation/channel_5/summary.json), with the current compiled reference/PI code and phased physical waveforms. Both remain below **5.683 A**, meet final tracking limits and agree under refinement within **0.290 µA** in physical current, with identical sampled feedback. These checks use the reduced amplifier response; manufacturer replay, temperature and timing uncertainty remain distinct gates. The [74-case averaged screen](../results/electronics/current_loop/noise_headroom_average/summary.json) and [powered lifecycle cases](../results/electronics/current_loop/lifecycle/summary.json) retain broader parameter and disable evidence for their archived earlier implementations; they do not silently qualify subsequent source changes.

The [compiled acquisition program](../results/electronics/current_loop/pio_acquisition/summary.json) checks configuration readback, the manual-channel pipeline, channel tags and assembled PIO instructions. Independent tests execute the instruction words and verify edges, bit order and FIFO packing. ARM compilation and host execution do not establish worst-case MCU execution time. DMA/register service, pad/synchronizer delays, coordinated PWM startup, communication and a trustworthy hardware commit heartbeat remain unfinished.

The [watchdog screen](../results/electronics/current_loop/watchdog/summary.json) uses an LTC6993 retriggerable timer, asynchronous-clear latch and individually gated enables. Missing pulses or reported faults latch the group off; resumed pulses alone cannot re-arm it. The [frozen-command analysis](../results/electronics/current_loop/frozen_command/summary.json) reconstructs saved RL trajectories and derives the time available before a stale valid command reaches the unchanged current limit. A group update heartbeat has timing room in those recorded cases; a per-coil-period heartbeat does not. The current timing screen includes timer/resistor temperature bounds and maximum logic/driver-enable delays. Earlier evidence incorrectly labelled the unchanged driver delay as typical; the current model follows the maximum column of TI table 6.5. Timer trigger/output loading, jitter, PCB parasitics and trustworthy commit timing remain open. This is not protection against arbitrary corrupted PWM or a stuck-on bridge.

The [acquisition-stream fault screen](../results/electronics/current_loop/acquisition_stream/summary.json) pairs FIFO words and conversions, checks sequence, channel tags and service deadlines, and latches inhibition after missing data, transfer errors or a PIO stall. Silent loss is detected by an explicit deadline check. Later valid data cannot clear a fault. This is the software contract: hardware must supply trustworthy counters/error flags and independently disable existing PWM when service stops. The C implementation now checks the same contract, and the native protection sheet provides the independent gate; MCU peripherals, heartbeat generation and timer callbacks still require deployment and timing verification.

The lifecycle runner extends this owner to zero/low holds, enable, opposite reversal and diode decay after disable, stopping before dependent cases on failure. Its first batch is explicitly **not accepted as lifecycle qualification**: a reused loop index returned the positive-current mean for other initial states. The original traces, source snapshots, reports and diagnosis are preserved in [diagnostics.zip](../results/electronics/current_loop/diagnostics.zip). A regression now checks each controller initial reference against its physical recording. The corrected batch now passes; the invalid first batch is retained only to explain the regression. The EN delay is also distinct from the IN/PWM delay in the model, as specified by the [DRV8962 datasheet](https://www.ti.com/lit/ds/symlink/drv8962.pdf); EN-to-output delay uses the specified maximum, while IN/PWM propagation remains typical. These enable cases start with powered, settled rails and do not qualify cold power-on.

The [preceding manufacturer-model comparison](../results/electronics/current_loop/transition_manufacturer/summary.json) passes the unchanged numerical and gain/offset envelopes over the command-transition portion of the revised reversal. It is a replay of recorded voltages through the unchanged amplifier model, not a new closed loop or the entire lifecycle hold. Longer replays exceeded their runtime limits without a completed output comparison; their netlists and logs remain preserved in the current-loop diagnostic archive. The bounded comparison does not establish a complete error allocation. Model input currents near zero common mode differ from the datasheet's typical bias specification; use device-data sensitivity to bound loading. The [current-changing sensitivity study](../results/electronics/low_side_readout/acquisition_stress/summary.json) and [leg-skew comparison](../results/electronics/low_side_readout/ripple_vendor/summary.json) remain relevant: ripple, shunt mismatch and timing can create deterministic bias. That bias is not random sensor noise. [Dead-time effects near zero](https://microchiptech.github.io/mcaf-doc/9.0.2/algorithms/dead-time-comp.html) also require resolved checks rather than a constant voltage-drop assumption.

**Noise, timing and price.** The revised [noise allocation](../results/electronics/low_side_readout/acquisition/noise_headroom/summary.json) retains covariance between paired samples and gives no unverified converter-averaging credit. Increasing the existing filter resistor leaves more independent-noise allowance with minimum converter SNR and typical amplifier noise; this is not a maximum device-noise guarantee. External reference, thermal noise, jitter, interference, amplifier flicker/maximum noise and temperature remain unresolved. Converter quantization/internal-reference noise already included in SNR must not be counted again. The current CAD uses WSLP12065L000FEA with the manufacturer land pattern, retaining the same resistance, power rating, tolerance and component temperature coefficient as the earlier larger shunt. The [current channel review](../results/cad/electronics/low_side_channel/summary.json) includes its smaller courtyard; this does not establish thermal feasibility or Kelvin routing. Use the [Vishay component TCR](https://www.vishay.com/docs/30122/wslp.pdf), including its terminations, rather than the smaller resistance-alloy TCR when allocating temperature error. Calibration at one temperature does not remove that drift.

The [local controller review](../results/cad/electronics/local_controller/summary.json) checks the RP2354B pin map, core regulator, crystal, programming signals and supply bypass. The [composed group](../results/cad/electronics/control_group/summary.json) includes four dual-coil sheets, acquisition, controller and [protection](../results/cad/electronics/protection/summary.json), preserving independent PWM, current-feedback and gated-enable paths. It is a logical group, not a selected production module. Its component courtyards occupy nearly all available surface area in the exploratory two-PCB arrangement, before Hall interfaces, shared power, interconnect, routing and heat paths. That earlier placement cannot establish feasibility of this larger netlist. Shared power/regeneration and interfaces remain unfinished; ERC errors are retained.

The [native-inventory and disabled-return screen](../results/electronics/supply/disabled_return/summary.json) establishes why local bypass alone is insufficient. The integrated delivery model now includes a non-sinking source with regulation headroom, feed resistance/current limiting, bulk capacitance, ESR and simultaneous diode return. Independent exact-RLC and energy-balance checks verify those equations. Its source and capacitor properties remain candidate design envelopes, not a qualified supply circuit. Auxiliary rails, selected source behavior, protection, wiring and component temperature/lifetime still require circuit implementation.

Synchronous carrier switching fails the [bulk ripple-current sizing screen](../results/electronics/supply/carrier_ripple/summary.json), despite passing the average bus-voltage test. The selected firmware candidate spreads the eight PWM phases while retaining independent commands and unchanged update rates; each controller predicts its own latch delay. This reduces coincident supply-current pulses. Actual capacitor impedance over frequency, unequal sharing, interconnect inductance, arbitrary duty combinations and thermal life remain unqualified; a carrier-current calculation cannot replace these checks.

`logic.ControlGroupPower` sequences cold recovery, ADC configuration/readback, measured idle calibration, explicit arming, delayed disable, sleep and reset interlocks in the integrated delivery screen. Standby and deep power-down use distinct recovery waits. The model still injects a healthy hardware-arm signal rather than deriving it from a complete physical supervisor. Rail ramps, ADC sleep-command deployment and GPIO/DMA execution remain open. Motion planning must wake a group before its coils are needed.

The [full-voltage command-fault screen](../results/electronics/current_loop/full_voltage_fault/summary.json) cannot guarantee the operating peak under arbitrary corrupted drive: the driver's maximum disable delay alone can exceed that limit. Keep normal limits unchanged and qualify fault shutdown against actual component current, duration and energy limits. A datasheet current rating alone does not establish transient safety. The missing-pulse watchdog covers stale valid commands, not arbitrary overcurrent or a stuck-on bridge; an independent cutoff circuit remains required.

The controller support follows the [Raspberry Pi hardware guide](https://pip-assets.raspberrypi.com/categories/1214-rp2350/documents/RP-008280-DS-1-hardware-design-with-rp2350.pdf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) and [RP2350B Minimal R4 CAD](https://pip-assets.raspberrypi.com/categories/1214-rp2350/documents/RP-010329-CA-1-RP2350B%20Minimal%20KiCAD.zip). The local Abracon inductor footprint is extracted from that reference under its accompanying MIT license. Its marked pin connects to the core output; the compact reference land pattern differs from Abracon's general-purpose recommendation. Preserve the reference regulator layout before accepting it. Capacitor part numbers and the crystal also follow that reference, but effective capacitance, oscillator startup and board-level timing are not yet qualified. The published [RP2354B volume tier](https://www.raspberrypi.com/news/rp2350-a4-rp2354-and-a-new-hacking-challenge/) is a sourcing reference, not a quote or a complete controller cost.

The [shared acquisition schematic review](../results/cad/electronics/shared_acquisition/summary.json) checks the ADC pin map, decoupling and a separate current-bias reference. It leaves external drivers/rails visible as ERC errors. The [component accuracy allocation](../results/electronics/low_side_readout/acquisition/component_accuracy/summary.json) shows why two-point calibration and a bounded temperature change are necessary; allocated calibration accuracy has not been achieved by a designed calibration procedure. ADC gain drift also moves the biased zero-current code. The selected-range input impedance terminates at an internal bias, not ground. The reduced model and SPICE fixture now implement that datasheet connection. An independent nodal check and filter-state translation regression verify the nominal correction; the calibrated analog dynamics are unchanged, but quantization phase can differ. The [corrected reversal](../results/electronics/current_loop/biased_adc_reversal/summary.json) and [unchanged manufacturer replay](../results/electronics/current_loop/biased_adc_replay/summary.json) both pass the existing tracking, peak-current, gain/offset and numerical envelopes. The manufacturer comparison covers this bounded transition; it does not establish temperature or supply corners.

The [SAR reference](../results/electronics/low_side_readout/acquisition/sar_reference/summary.json) requires staggered regulation; simultaneous updates would add channel-dependent age. The present flight model assumes immediate simultaneous readings and has not been migrated. [ADS8698](https://www.ti.com/lit/ds/symlink/ads8698.pdf) remains an expensive technical comparison. The cheaper [ADS131M08 comparison](../results/electronics/low_side_readout/acquisition/summary.json) has substantially greater filter/readout delay and is not a drop-in replacement. Compare complete acquisition chains, including computation, calibration, power and support components.

The user-selected INA181 evaluation price and alternatives are retained in the [sourcing report](../results/electronics/readout_sourcing/summary.json). The configured production quantity applies to complete boards; component demand must aggregate installed channels across that order. Existing area-equivalent counts exclude final edge/module rounding. Public catalogue tiers are dated reference scenarios, not quotations or supply commitments. No negotiated discount is assumed, and no purchasing/RFQ action has been taken. The earlier inline INA241 circuit is superseded; its [review archive](../results/electronics/integrated_channel/sources.zip) retains exact history. Complete electronics cost and cooling remain acceptance gates.

### Electronics power-stage and packaging gate

The [power-stage screen](../results/electronics/power_stage/summary.json) uses the actual square prototype's winding resistance and the existing lower inductance factor. It reuses the analytical RL implementation and global ripple bound; independent ngspice circuits verify periodic current and repeat with a finer maximum integration step. The full-bridge reference drives both legs with center-aligned waveforms, rather than assuming that any full-bridge PWM produces the same result. Settings and acceptance limits are in `model.py`; the report retains exact sources and circuit traces.

At the configured supply excursion, the global peak-ripple bounds are 1.272 A for the original split-rail bridge, 0.636 A for a full bridge on the original bus, and 0.382 A for the lower-voltage full-bridge candidate. Only the last passes the unchanged ripple and peak-current screens while preserving the configured terminal-voltage command range and voltage reserve. This establishes an **ideal switching candidate**, not a hardware implementation. The current limit is checked separately from the mathematical periodic reference; its large DC means at high commanded voltage are not workload currents or thermal inputs. Unmeasured/mutual inductance, real switching, dead time, parasitics, bus regeneration and current reconstruction remain open. Disabled-winding diode decay also differs from the existing split-rail simulator and must be reconciled. No flight settings have been migrated.

The [editable KiCad channel](../electronics/channel.kicad_sch), [drawing](../results/cad/electronics/low_side_channel/channel.pdf) and [component list](../results/cad/electronics/low_side_channel/bom.csv) describe the current separate-return candidate. The [review](../results/cad/electronics/low_side_channel/summary.json) checks 108 pin connections across 29 components. Driver VREF uses the buffered current reference rather than DVDD, and the fault pullup uses the logic supply. Split filter capacitors and separate shunts retain explicit model-derived values. The source audit rejects missing parameters and stale values.

Shared interfaces remain unfinished and ERC errors are retained without exclusions. Courtyard area is approximately 200 mm² per coil before shared functions and routing; this exceeds one double-sided PCB's area under the present coil pitch. The earlier two-PCB placement is not a placement of this more complete circuit. Smaller adequately rated shunts/support parts, shared-circuit area and accessible cooling must be evaluated before accepting the stack. Footprint area alone is not routing or thermal feasibility.

The [footprint audit](../results/electronics/channel_review/summary.json) sums actual KiCad courtyard polygons: the drafted discrete channel occupies 279.44 mm², versus 121.68 mm² available per coil even when both faces are entirely usable. This is already 2.30 times the available area before routing, thermal spreading or shared circuits. It disproves fit for this candidate, not for every possible circuit. The compact comparison uses [DRV8962](https://www.ti.com/lit/ds/symlink/drv8962.pdf), which supports independent half-bridge control at the required carrier rate. Its built-in current mirror is not equivalent to the simulated precision feedback, so the external precision shunt and amplifier remain in the comparison.

The [integrated placement report](../results/electronics/driver_placement/summary.json), [two-face view](../results/electronics/driver_placement/board_faces.png) and [native KiCad board](../electronics/driver_tile.kicad_pcb) explore two double-sided PCBs beneath one unchanged layer of sixteen coils. Each board occupies 31.2 × 31.2 mm and contains four dual-channel drivers, eight shunts/amplifiers, local support capacitors and a shared fault pullup: 57 parts serving eight independent coils. The included parts require 145.75 mm² per channel; a single double-sided PCB under all sixteen coils would be about 20% short of area even before missing functions. With two boards, courtyard occupancy is 62.7% on top and 57.1% below, with no same-face courtyard overlap or outline excursion. Native save/reload preserves footprints, sides and identities. This is an **unrouted placement screen**, with no electrical nets, electrical DRC pass or thermal qualification. The provisional DDV footprint still needs manufacturer land-pattern verification. No channel sharing or new coil geometry is introduced.

The [FreeCAD assembly](../results/cad/electronics/driver_assembly.FCStd), [STEP assembly](../results/cad/electronics/driver_assembly.step) and [CAD verification](../results/cad/electronics/freecad_validation.json) provide inspectable solids derived from that placement. `methodology.cad.electronics` reuses the coil CAD and imports pinned KiCad package models; the report retains their hashes and sources. Generic package models are not exact-MPN mechanical qualification. Purple driver solids are explicit clearance envelopes based on the provisional footprint's TI package drawing, not detailed vendor models. The exploded separation is for inspection, not a selected stack height.

The patch spans four coil pitches, not one chess square. The current model's chess squares are 60 mm, with a 480 mm playing area and a 720 × 480 mm motor area including capture buffers. Production PCB boundaries and quantities are undecided. Repeated circuit blocks can populate larger modules; compare module sizes using complete shared circuitry, connector and wiring counts, panel utilization, assembly, yield/rework and cooling costs before choosing boundaries. Neither one PCB per chess square nor replication of these small patch outlines is the production baseline.

Double-sided component assembly is the starting packaging candidate. The area allowance already includes both faces; extra copper layers provide routing and heat spreading, not extra component faces. Additional physical PCBs add thickness, interconnect and assembly cost. The demonstrated placement omits coil terminations, Hall sensing, ADC/control, reference generation, hardware current-limit latch, supplies, bulk/regeneration, mounting and cooling. Fast bypass loops and Kelvin sensing routes still need design. The DDV drivers occupy the top face of each PCB and need accessible heatsinks there; cooling between stacked boards is unresolved. Preview separation is illustrative. The placement supports investigating this stack, not adopting it or claiming a complete board fits.

KiCad 9.0.8 and ngspice 45.2 were installed in the user's local tools directory without modifying the simulation environment. `methodology.electronics.power_stage` generates the switching evidence; `methodology.electronics.review` checks the current integrated circuit pin map, model-bound passive values and per-channel footprint area using KiCad exports and `pcbnew`. `methodology.electronics.placement` reuses those footprints and selected parts, adds the integrated driver and its [local VM bypass](https://search.kemet.com/component-documentation/download/specsheet/C0603C103K5RACTU), and exports the editable placement, clearance audit and illustrations. Each requires an explicit fresh output directory and tool/library paths. Native sources belong under `methodology/electronics/`, numerical evidence under `methodology/results/electronics/`, and CAD exports under `methodology/results/cad/electronics/`. `logic.py` owns the digital protocol and instruction schedule; `acquisition.py` owns analog acquisition; `firmware.py` builds and checks the compiled implementation; `protection.py` owns fault timing and gate behavior; `supply.py` owns shared-bus and capacitor calculations; `system.py` owns their integration with physical current/filter plants, compiled acquisition/regulation and power sequencing. The PIO assembler was built from the official Pico SDK revision `079c6f39023649b154152db30f1d781e884879bc` (2.3.1) in the local tools directory, using the existing Android SDK CMake. Generated reports record the assembler binary hash. Symbols and footprints originate from the [KiCad libraries](https://www.kicad.org/libraries/license/). The first finite-edge reference failure is retained separately: the ideal-source edge duration was reduced to remove its numerical discrepancy, while the acceptance tolerance was unchanged.
