nikarus/levitating_chess/methodology/cad/output/airborne.png

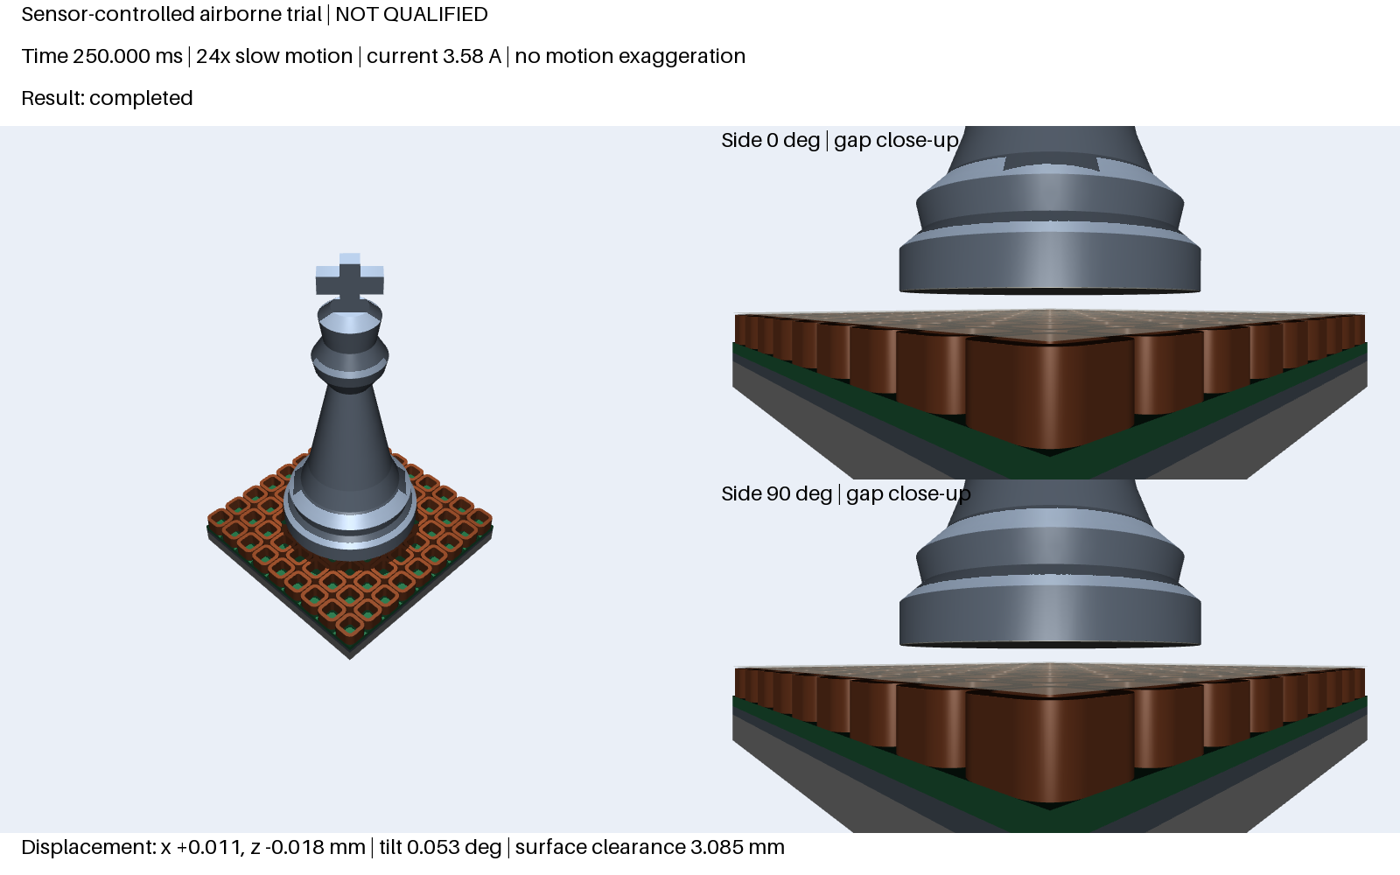
methodology/cad/output/airborne.png
