nikarus/levitating_chess/methodology/cad/output/single_coil.png

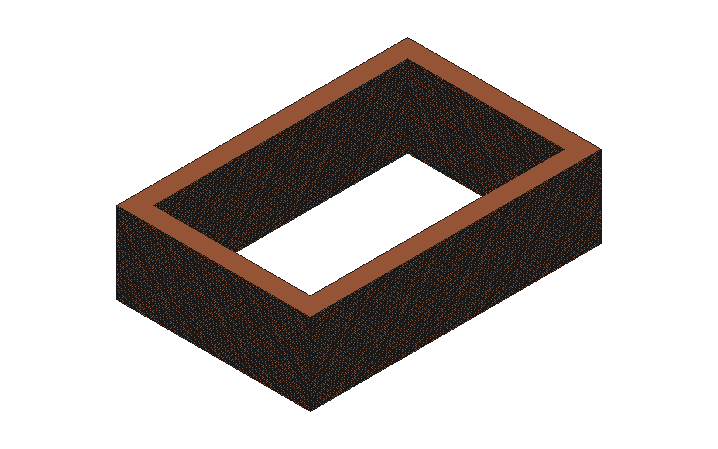
methodology/cad/output/single_coil.png
