nikarus/levitating_chess/methodology/results/electronics/current_loop/compensated_reversal/current_reversal.png

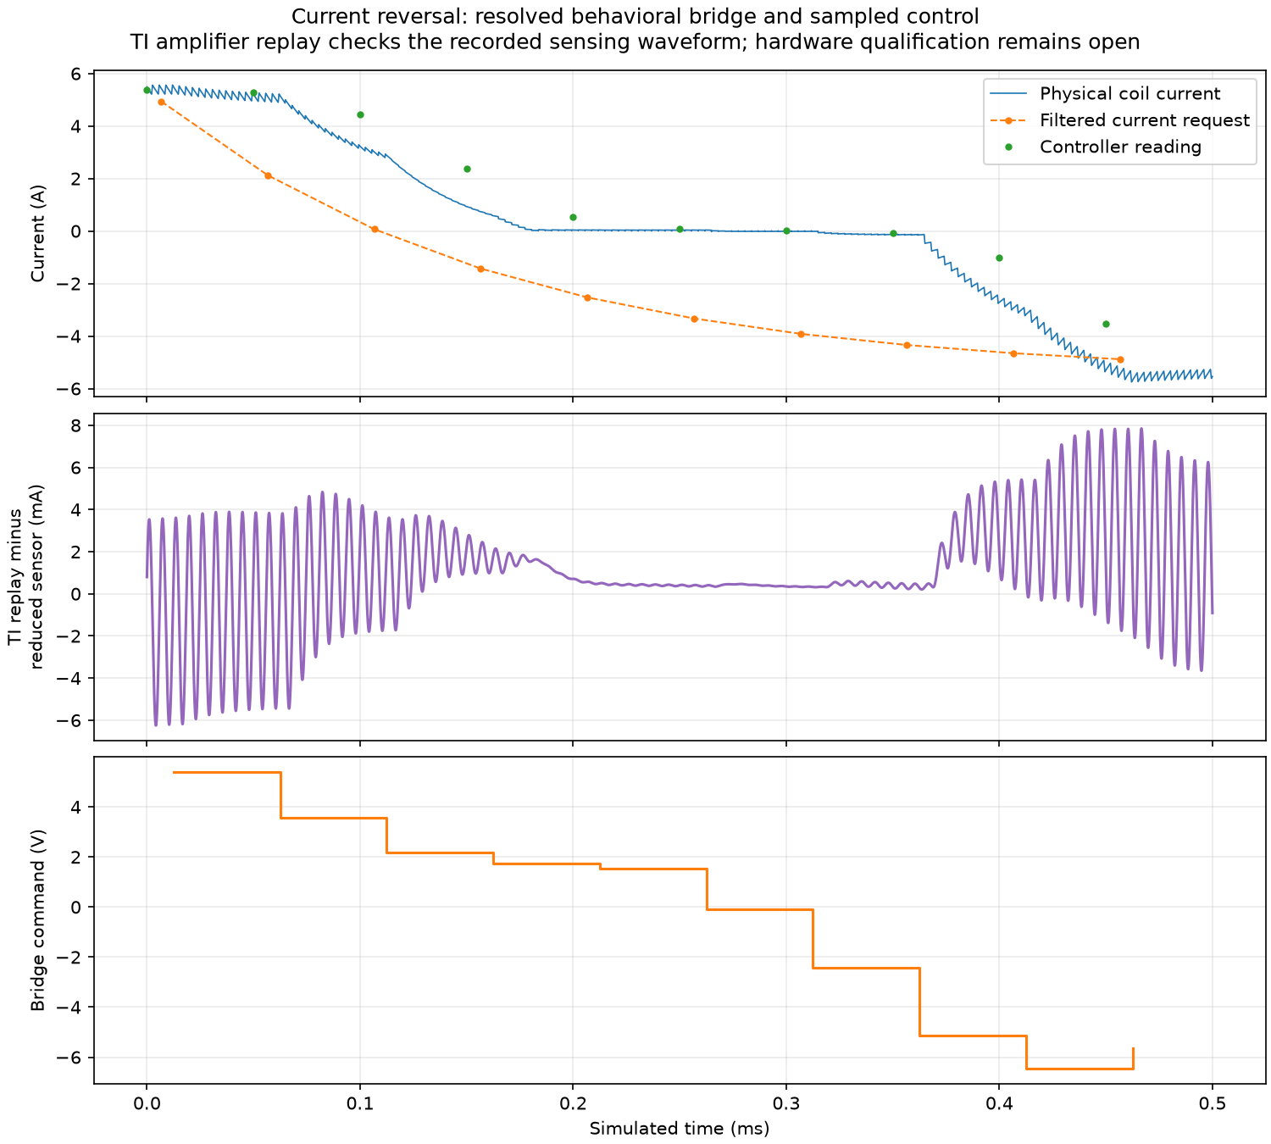
methodology/results/electronics/current_loop/compensated_reversal/current_reversal.png
