nikarus/levitating_chess/methodology/results/electronics/current_loop/predicted_switching/current_control.png

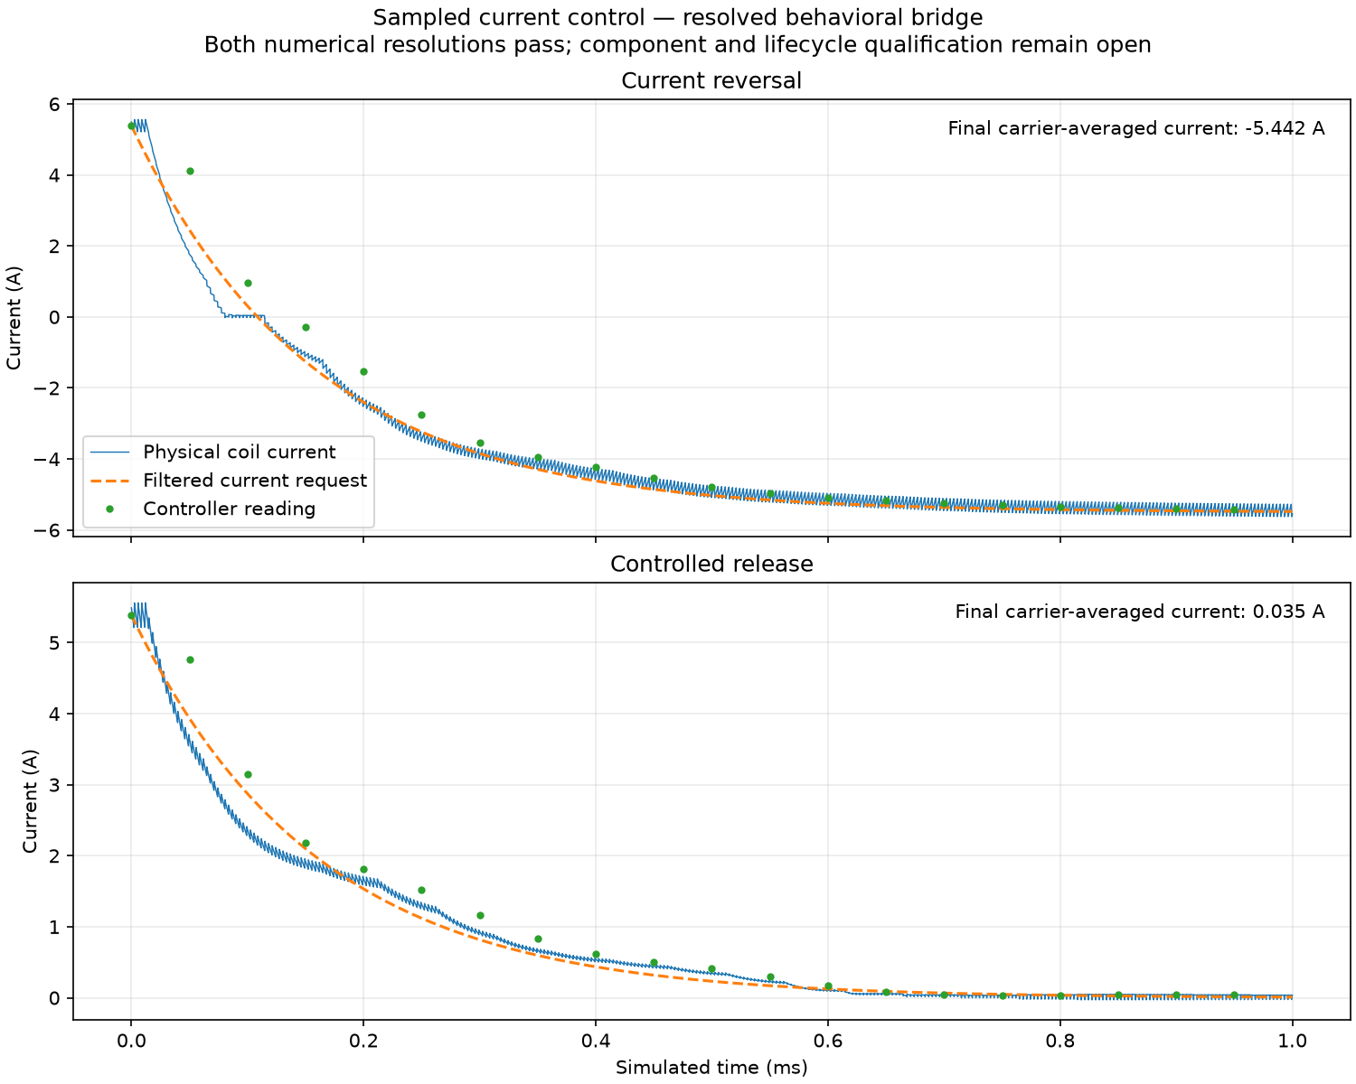
methodology/results/electronics/current_loop/predicted_switching/current_control.png
