nikarus/levitating_chess/methodology/results/electronics/driver_placement/board_faces.png

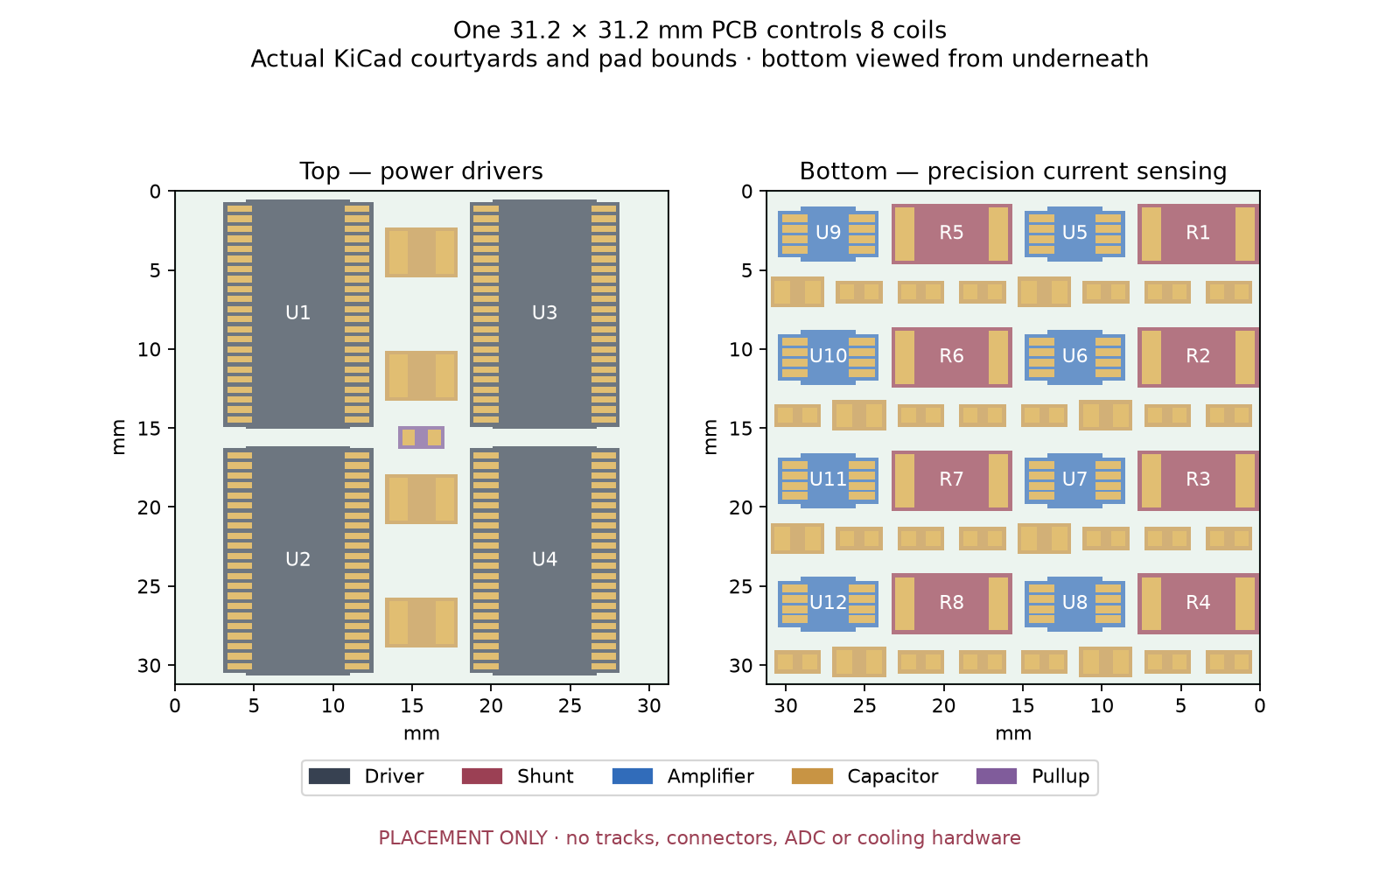
methodology/results/electronics/driver_placement/board_faces.png
