nikarus/levitating_chess/methodology/results/electronics/channel_review/bom.csv

References | Value | MPN | Footprint | Quantity | ModelParameter
C1,C4 | 1e-07 | C0603C104K5RACTU | Capacitor_SMD:C_0603_1608Metric | 2 | electronics_bootstrap_capacitance
C2,C5 | 1e-06 | C0805C105K5RACTU | Capacitor_SMD:C_0805_2012Metric | 2 | electronics_gate_bypass_capacitance
C3,C6 | 4.7e-06 | GRM32ER71H475KA88L | Capacitor_SMD:C_1210_3225Metric | 2 | electronics_channel_bus_capacitance
C7 | 1e-07 | C0603C104K5RACTU | Capacitor_SMD:C_0603_1608Metric | 1 | electronics_analog_bypass_capacitance
D1,D2 | BAS21H | BAS21H,115 | Diode_SMD:D_SOD-123F | 2
Q1-Q4 | CSD18543Q3A | CSD18543Q3A | Package_SON:VSON-8_3.3x3.3mm_P0.65mm_NexFET | 4
R1-R4 | 4.7 | RC0603FR-074R7L | Resistor_SMD:R_0603_1608Metric | 4 | electronics_gate_resistance
R5-R8,R12 | 10000 | RC0603FR-0710KL | Resistor_SMD:R_0603_1608Metric | 5 | electronics_gate_pulldown
R9,R10 | 10000 | RC0603FR-0710KL | Resistor_SMD:R_0603_1608Metric | 2 | electronics_deadtime_resistance
R11 | 0.02 | WSL2512R0200FEA18 | Resistor_SMD:R_2512_6332Metric | 1 | current_sense_resistance
U1,U2 | LM5106SD | LM5106SD/NOPB | Package_SON:WSON-10-1EP_4x4mm_P0.8mm_EP2.6x3mm_ThermalVias | 2
U3 | INA241A1 | INA241A1DGKR | Package_SO:VSSOP-8_3x3mm_P0.65mm | 1
