nikarus/levitating_chess/methodology/results/electronics/integrated_channel/bom.csv

References | Value | MPN | Footprint | Quantity | ModelParameter
C1-C4 | 1e-08 | C0603C103K5RACTU | Capacitor_SMD:C_0603_1608Metric | 4 | electronics_integrated_bus_bypass
C5 | 4.7e-06 | GRM32ER71H475KA88L | Capacitor_SMD:C_1210_3225Metric | 1 | electronics_channel_bus_capacitance
C6 | 1e-06 | C0805C105K5RACTU | Capacitor_SMD:C_0805_2012Metric | 1 | electronics_charge_pump_reservoir
C7 | 1e-07 | C0603C104K5RACTU | Capacitor_SMD:C_0603_1608Metric | 1 | electronics_charge_pump_flying
C8 | 1e-06 | C0805C105K5RACTU | Capacitor_SMD:C_0805_2012Metric | 1 | electronics_driver_ldo_bypass
C9-C11 | 1e-07 | C0603C104K5RACTU | Capacitor_SMD:C_0603_1608Metric | 3 | electronics_analog_bypass_capacitance
R1-R4 | 10000 | RC0603FR-0710KL | Resistor_SMD:R_0603_1608Metric | 4 | electronics_gate_pulldown
R5,R6 | 0.02 | WSL2512R0200FEA18 | Resistor_SMD:R_2512_6332Metric | 2 | current_sense_resistance
U1 | DRV8962DDV | DRV8962DDVR | Package_SO:HTSSOP-44_6.1x14mm_P0.635mm_TopEP4.14x7.01mm | 1
U2,U3 | INA241A1 | INA241A1IDGKR | Package_SO:VSSOP-8_3x3mm_P0.65mm | 2
