nikarus/levitating_chess/methodology/results/cad/electronics/control_group/bom.csv

References | Value | MPN | Footprint | Quantity | ModelParameter
C101-C104,C201-C204,C301-C304,C401-C404 | 1e-08 | C0603C103K5RACTU | Capacitor_SMD:C_0603_1608Metric | 16 | electronics_integrated_bus_bypass
C105,C116,C205,C216,C305,C316,C405,C416 | 4.7e-06 | GRM32ER71H475KA88L | Capacitor_SMD:C_1210_3225Metric | 8 | electronics_channel_bus_capacitance
C106,C206,C306,C406 | 1e-06 | C0805C105K5RACTU | Capacitor_SMD:C_0805_2012Metric | 4 | electronics_charge_pump_reservoir
C107,C207,C307,C407 | 1e-07 | C0603C104K5RACTU | Capacitor_SMD:C_0603_1608Metric | 4 | electronics_charge_pump_flying
C108,C208,C308,C408 | 1e-06 | C0805C105K5RACTU | Capacitor_SMD:C_0805_2012Metric | 4 | electronics_driver_ldo_bypass
C109-C111,C209-C211,C309-C311,C409-C411,C525 | 1e-07 | C0603C104K5RACTU | Capacitor_SMD:C_0603_1608Metric | 13 | electronics_analog_bypass_capacitance
C112-C115,C212-C215,C312-C315,C412-C415 | 1e-07 | C0603C104K5RACTU | Capacitor_SMD:C_0603_1608Metric | 16 | electronics_acquisition_filter_capacitance
C520,C522,C524,C526,C527 | 2.2e-05 | GRM32ER61C226KE20L | Capacitor_SMD:C_1210_3225Metric | 5 | electronics_acquisition_bulk_capacitance
C521,C523,C528-C531 | 1e-06 | GRM21BR71H105KA12L | Capacitor_SMD:C_0805_2012Metric | 6 | electronics_acquisition_local_capacitance
C640-C642 | 4.7e-06 | GRM155R60J475ME47D | Capacitor_SMD:C_0402_1005Metric | 3 | electronics_logic_regulator_capacitance
C643,C644 | 1.5e-11 | GRM1555C1H150JA01D | Capacitor_SMD:C_0402_1005Metric | 2 | electronics_logic_crystal_capacitance
C645-C658,C770-C776 | 1e-07 | GRM155R71E104KE14D | Capacitor_SMD:C_0402_1005Metric | 21 | electronics_logic_bypass_capacitance
L620 | 3.3e-06 | AOTA-B201610S3R3-101-T | FlyingChess:AOTA_B201610S3R3_101_T_RPi | 1 | electronics_logic_inductance
R101-R104,R201-R204,R301-R304,R401-R404 | 10000 | RC0603FR-0710KL | Resistor_SMD:R_0603_1608Metric | 16 | electronics_logic_pull_resistance
R105-R108,R205-R208,R305-R308,R405-R408 | 0.005 | WSLP12065L000FEA | FlyingChess:WSLP1206_2m_5m9 | 16 | electronics_readout_trial_shunt
R109,R110,R209,R210,R309,R310,R409,R410 | 200.0 | RC0603FR-07200RL | Resistor_SMD:R_0603_1608Metric | 8 | electronics_acquisition_filter_resistance
R520 | 1.0 | RC0603FR-071RL | Resistor_SMD:R_0603_1608Metric | 1 | electronics_bias_reference_capacitor_esr
R521,R522 | 10000.0 | RC0603FR-0710KL | Resistor_SMD:R_0603_1608Metric | 2 | electronics_logic_pull_resistance
R630 | 33.0 | RC0402FR-0733RL | Resistor_SMD:R_0402_1005Metric | 1 | electronics_logic_regulator_filter
R631 | 1000.0 | RC0402FR-071KL | Resistor_SMD:R_0402_1005Metric | 1 | electronics_logic_crystal_resistance
R632,R633,R743-R754 | 10000.0 | RC0402FR-0710KL | Resistor_SMD:R_0402_1005Metric | 14 | electronics_logic_pull_resistance
R740 | 51100.0 | RC0402FR-0751K1L | Resistor_SMD:R_0402_1005Metric | 1 | electronics_watchdog_set_resistance
R741 | 976000.0 | RC0402FR-07976KL | Resistor_SMD:R_0402_1005Metric | 1 | electronics_watchdog_divider_top
R742 | 102000.0 | RC0402FR-07102KL | Resistor_SMD:R_0402_1005Metric | 1 | electronics_watchdog_divider_bottom
U101,U201,U301,U401 | DRV8962DDV | DRV8962DDVR | Package_SO:HTSSOP-44_6.1x14mm_P0.635mm_TopEP4.14x7.01mm | 4
U102,U103,U202,U203,U302,U303,U402,U403 | INA181A1 | INA181A1IDBVR | Package_TO_SOT_SMD:SOT-23-6 | 8
U510 | ADS8698 | ADS8698IDBTR | Package_SO:TSSOP-38_4.4x9.7mm_P0.5mm | 1
U511 | REF5025ID | REF5025IDR | Package_SO:SOIC-8_3.9x4.9mm_P1.27mm | 1
U620 | RP2354B | RP2354B | Package_DFN_QFN:QFN-80-1EP_10x10mm_P0.4mm_EP3.4x3.4mm | 1
U730 | LTC6993xS6-2 | LTC6993IS6-2#TRMPBF | Package_TO_SOT_SMD:TSOT-23-6 | 1
U731 | 74LVC1G11 | SN74LVC1G11DBVR | Package_TO_SOT_SMD:SOT-23-6 | 1
U732 | SN74LVC1G74 | SN74LVC1G74DCUR | Package_SO:VSSOP-8_2.3x2mm_P0.5mm | 1
U733-U736 | 74LVC2G08 | SN74LVC2G08DCUR | Package_SO:VSSOP-8_2.3x2mm_P0.5mm | 4
Y620 | 12000000.0 | ABM8-272-T3 | Crystal:Crystal_SMD_3225-4Pin_3.2x2.5mm | 1 | electronics_logic_crystal_frequency
