nikarus/levitating_chess/methodology/results/cad/electronics/driver_assembly.step

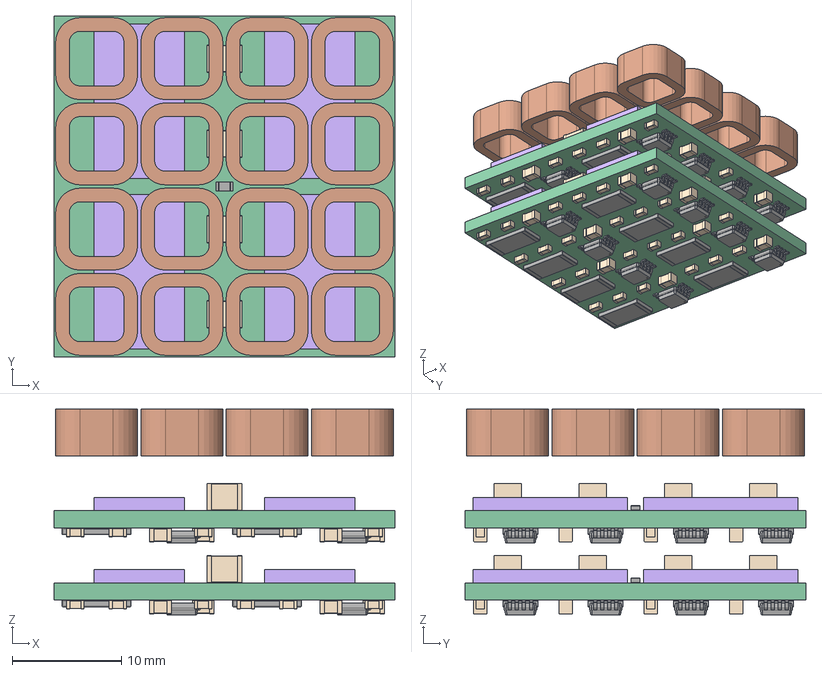
[picture p7: CAD file, 2026-10-22]
methodology/results/cad/electronics/driver_assembly.step
31.2 x 31.2 x 18.8 mm
PCB1_substrate_UNROUTED
PCB1_U1_DDV_CLEARANCE_ENVELOPE
PCB1_U2_DDV_CLEARANCE_ENVELOPE
PCB1_U3_DDV_CLEARANCE_ENVELOPE
PCB1_U4_DDV_CLEARANCE_ENVELOPE
PCB1_C1_GRM32ER71H475KA88L_LIBRARY_PACKAGE
PCB1_R1_WSL2512R0200FEA18_LIBRARY_PACKAGE
PCB1_U5_INA241A1DGKR_LIBRARY_PACKAGE
PCB1_C2_C0603C104K5RACTU_LIBRARY_PACKAGE
PCB1_C3_C0603C103K5RACTU_LIBRARY_PACKAGE
PCB1_C4_C0603C103K5RACTU_LIBRARY_PACKAGE
PCB1_C5_C0805C105K5RACTU_LIBRARY_PACKAGE
PCB1_R2_WSL2512R0200FEA18_LIBRARY_PACKAGE
PCB1_U6_INA241A1DGKR_LIBRARY_PACKAGE
PCB1_C6_C0603C104K5RACTU_LIBRARY_PACKAGE
PCB1_C7_C0603C104K5RACTU_LIBRARY_PACKAGE
PCB1_C8_C0805C105K5RACTU_LIBRARY_PACKAGE
PCB1_C9_C0603C104K5RACTU_LIBRARY_PACKAGE
PCB1_C10_GRM32ER71H475KA88L_LIBRARY_PACKAGE
PCB1_R3_WSL2512R0200FEA18_LIBRARY_PACKAGE
PCB1_U7_INA241A1DGKR_LIBRARY_PACKAGE
PCB1_C11_C0603C104K5RACTU_LIBRARY_PACKAGE
PCB1_C12_C0603C103K5RACTU_LIBRARY_PACKAGE
PCB1_C13_C0603C103K5RACTU_LIBRARY_PACKAGE
PCB1_C14_C0805C105K5RACTU_LIBRARY_PACKAGE
PCB1_R4_WSL2512R0200FEA18_LIBRARY_PACKAGE
PCB1_U8_INA241A1DGKR_LIBRARY_PACKAGE
PCB1_C15_C0603C104K5RACTU_LIBRARY_PACKAGE
PCB1_C16_C0603C104K5RACTU_LIBRARY_PACKAGE
PCB1_C17_C0805C105K5RACTU_LIBRARY_PACKAGE
PCB1_C18_C0603C104K5RACTU_LIBRARY_PACKAGE
PCB1_C19_GRM32ER71H475KA88L_LIBRARY_PACKAGE
PCB1_R5_WSL2512R0200FEA18_LIBRARY_PACKAGE
PCB1_U9_INA241A1DGKR_LIBRARY_PACKAGE
PCB1_C20_C0603C104K5RACTU_LIBRARY_PACKAGE
PCB1_C21_C0603C103K5RACTU_LIBRARY_PACKAGE
PCB1_C22_C0603C103K5RACTU_LIBRARY_PACKAGE
PCB1_C23_C0805C105K5RACTU_LIBRARY_PACKAGE
PCB1_R6_WSL2512R0200FEA18_LIBRARY_PACKAGE
PCB1_U10_INA241A1DGKR_LIBRARY_PACKAGE
PCB1_C24_C0603C104K5RACTU_LIBRARY_PACKAGE
PCB1_C25_C0603C104K5RACTU_LIBRARY_PACKAGE
PCB1_C26_C0805C105K5RACTU_LIBRARY_PACKAGE
PCB1_C27_C0603C104K5RACTU_LIBRARY_PACKAGE
PCB1_C28_GRM32ER71H475KA88L_LIBRARY_PACKAGE
PCB1_R7_WSL2512R0200FEA18_LIBRARY_PACKAGE
PCB1_U11_INA241A1DGKR_LIBRARY_PACKAGE
PCB1_C29_C0603C104K5RACTU_LIBRARY_PACKAGE
PCB1_C30_C0603C103K5RACTU_LIBRARY_PACKAGE
PCB1_C31_C0603C103K5RACTU_LIBRARY_PACKAGE
PCB1_C32_C0805C105K5RACTU_LIBRARY_PACKAGE
PCB1_R8_WSL2512R0200FEA18_LIBRARY_PACKAGE
PCB1_U12_INA241A1DGKR_LIBRARY_PACKAGE
PCB1_C33_C0603C104K5RACTU_LIBRARY_PACKAGE
PCB1_C34_C0603C104K5RACTU_LIBRARY_PACKAGE
PCB1_C35_C0805C105K5RACTU_LIBRARY_PACKAGE
PCB1_C36_C0603C104K5RACTU_LIBRARY_PACKAGE
PCB1_R9_RC0603FR-0710KL_LIBRARY_PACKAGE
PCB2_substrate_UNROUTED
PCB2_U1_DDV_CLEARANCE_ENVELOPE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
