nikarus/levitating_chess/methodology/results/cad/square_assembly.step

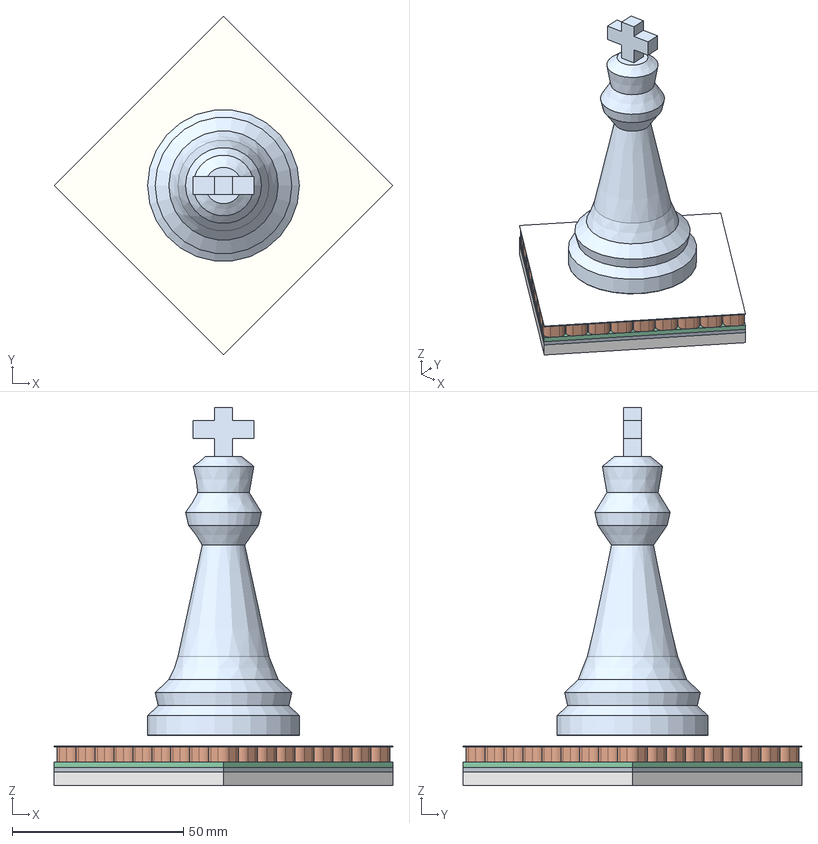
[picture p8: CAD file, 2026-10-18]
methodology/results/cad/square_assembly.step
98.9 x 98.9 x 110.3 mm
Coil_x_-4_-4_winding_envelope
Coil_x_-4_-3_winding_envelope
Coil_x_-4_-2_winding_envelope
Coil_x_-4_-1_winding_envelope
Coil_x_-4_0_winding_envelope
Coil_x_-4_1_winding_envelope
Coil_x_-4_2_winding_envelope
Coil_x_-4_3_winding_envelope
Coil_x_-4_4_winding_envelope
Coil_x_-3_-4_winding_envelope
Coil_x_-3_-2_winding_envelope
Coil_x_-3_-1_winding_envelope
Coil_x_-3_0_winding_envelope
Coil_x_-3_1_winding_envelope
Coil_x_-3_2_winding_envelope
Coil_x_-3_3_winding_envelope
Coil_x_-3_4_winding_envelope
Coil_x_-2_-4_winding_envelope
Coil_x_-2_-3_winding_envelope
Coil_x_-2_-2_winding_envelope
Coil_x_-2_-1_winding_envelope
Coil_x_-2_0_winding_envelope
Coil_x_-2_1_winding_envelope
Coil_x_-2_2_winding_envelope
Coil_x_-2_3_winding_envelope
Coil_x_-2_4_winding_envelope
Coil_x_-1_-4_winding_envelope
Coil_x_-1_-3_winding_envelope
Coil_x_-1_-2_winding_envelope
Coil_x_-1_-1_winding_envelope
Coil_x_-1_0_winding_envelope
Coil_x_-1_1_winding_envelope
Coil_x_-1_2_winding_envelope
Coil_x_-1_3_winding_envelope
Coil_x_-1_4_winding_envelope
Coil_x_0_-4_winding_envelope
Coil_x_0_-3_winding_envelope
Coil_x_0_-2_winding_envelope
Coil_x_0_-1_winding_envelope
Coil_x_0_0_winding_envelope
Coil_x_0_1_winding_envelope
Coil_x_0_2_winding_envelope
Coil_x_0_3_winding_envelope
Coil_x_0_4_winding_envelope
Coil_x_1_-4_winding_envelope
Coil_x_1_-3_winding_envelope
Coil_x_1_-2_winding_envelope
Coil_x_1_-1_winding_envelope
Coil_x_1_0_winding_envelope
Coil_x_1_1_winding_envelope
Coil_x_1_2_winding_envelope
Coil_x_1_3_winding_envelope
Coil_x_1_4_winding_envelope
Coil_x_2_-4_winding_envelope
Coil_x_2_-3_winding_envelope
Coil_x_2_-2_winding_envelope
Coil_x_2_-1_winding_envelope
Coil_x_2_0_winding_envelope
Coil_x_2_1_winding_envelope
Coil_x_2_2_winding_envelope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
