nikarus/levitating_chess/methodology/cad/output/coil_assembly_exploded.step

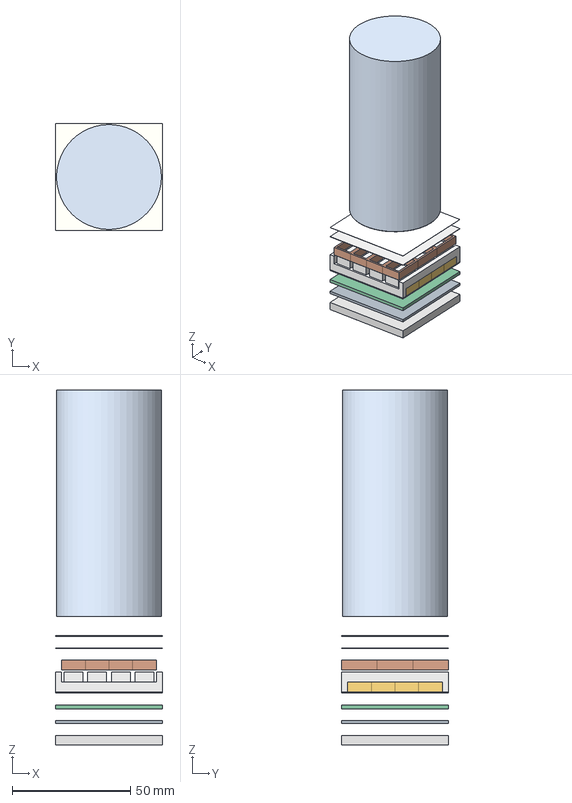
[picture p11: CAD file, 2026-10-09]
methodology/cad/output/coil_assembly_exploded.step
45.0 x 45.0 x 149.9 mm
Coil_x_-2_-1
Coil_x_-2_0
Coil_x_-2_1
Coil_x_-1_-1
Coil_x_-1_0
Coil_x_-1_1
Coil_x_0_-1
Coil_x_0_0
Coil_x_0_1
Coil_x_1_-1
Coil_x_1_0
Coil_x_1_1
Coil_y_-1_-2
Coil_y_-1_-1
Coil_y_-1_0
Coil_y_-1_1
Coil_y_0_-2
Coil_y_0_-1
Coil_y_0_0
Coil_y_0_1
Coil_y_1_-2
Coil_y_1_-1
Coil_y_1_0
Coil_y_1_1
Potting_between_winding_envelopes
Potting_bond
PCB_envelope
Thermal_interface
Baseplate_envelope
Potting_cover
Playing_surface
Magnet_0_minus_Z
Magnet_1_minus_Y
Magnet_2_minus_Z
Magnet_3_plus_Y
Magnet_4_minus_X
Magnet_5_minus_Y
Magnet_6_minus_X
Magnet_7_plus_Y
Magnet_8_plus_Z
Magnet_9_minus_Y
Magnet_10_plus_Z
Magnet_11_plus_Y
Magnet_12_plus_X
Magnet_13_minus_Y
Magnet_14_plus_X
Magnet_15_plus_Y
Piece_bottom_skin
King_clearance_envelope_NOT_material
