nikarus/levitating_chess/methodology/cad/output/parquet_5.step

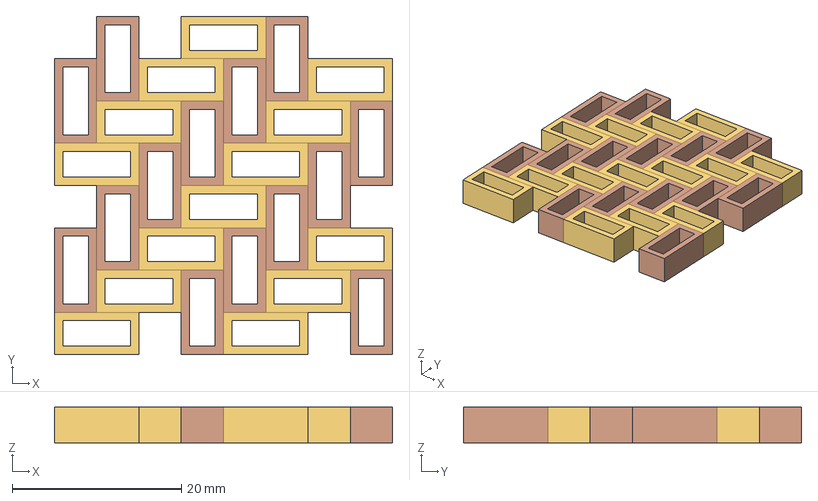
[picture p12: CAD file, 2026-10-15]
methodology/cad/output/parquet_5.step
40.0 x 40.0 x 4.22 mm
Coil_y_-4_-4
Coil_x_-4_-3
Coil_y_-4_0
Coil_x_-4_1
Coil_y_-3_-3
Coil_x_-3_-2
Coil_y_-3_1
Coil_x_-3_2
Coil_y_-2_-2
Coil_x_-2_-1
Coil_y_-2_2
Coil_x_-1_-4
Coil_y_-1_-1
Coil_x_-1_0
Coil_y_-1_3
Coil_y_0_-4
Coil_x_0_-3
Coil_y_0_0
Coil_x_0_1
Coil_y_1_-3
Coil_x_1_-2
Coil_y_1_1
Coil_x_1_2
Coil_y_2_-2
Coil_x_2_-1
Coil_y_2_2
Coil_x_3_-4
Coil_x_3_0
