nikarus/levitating_chess/methodology/cad/output/square_7_5.step

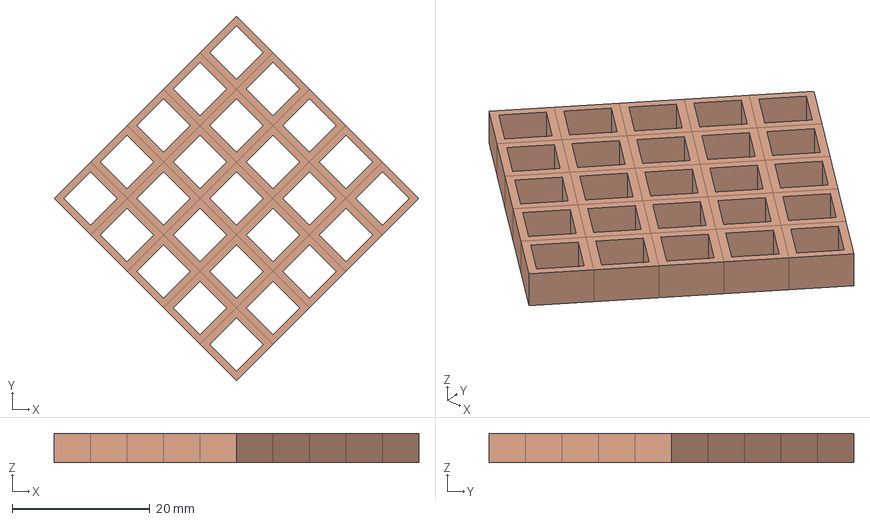
[picture p13: CAD file, 2026-10-15]
methodology/cad/output/square_7_5.step
53.0 x 53.0 x 4.22 mm
Coil_x_-2_-2
Coil_x_-2_-1
Coil_x_-2_0
Coil_x_-2_1
Coil_x_-2_2
Coil_x_-1_-2
Coil_x_-1_-1
Coil_x_-1_0
Coil_x_-1_1
Coil_x_-1_2
Coil_x_0_-2
Coil_x_0_-1
Coil_x_0_0
Coil_x_0_1
Coil_x_0_2
Coil_x_1_-2
Coil_x_1_-1
Coil_x_1_0
Coil_x_1_1
Coil_x_1_2
Coil_x_2_-2
Coil_x_2_-1
Coil_x_2_0
Coil_x_2_1
Coil_x_2_2
