nikarus/levitating_chess/methodology/cad/output/stacked_reference.step

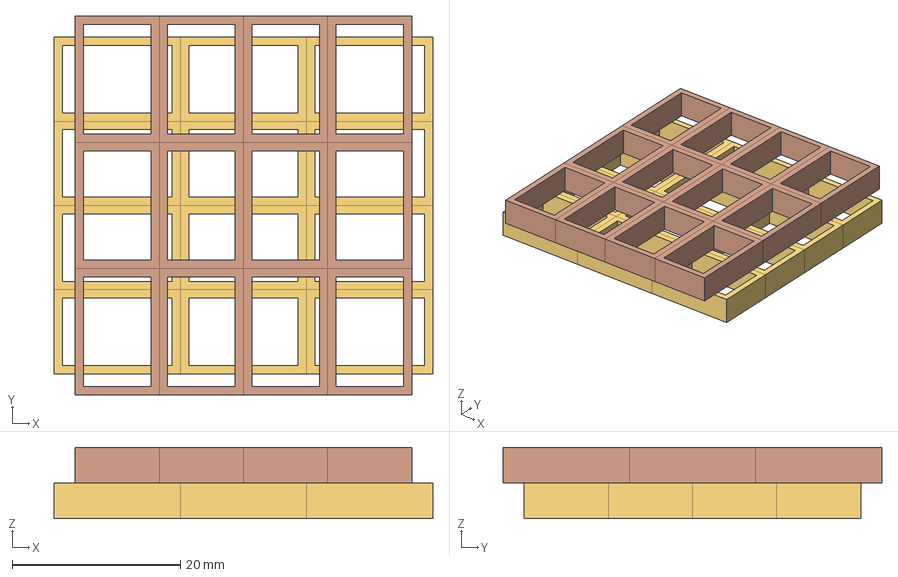
[picture p14: CAD file, 2026-10-15]
methodology/cad/output/stacked_reference.step
45.0 x 45.0 x 8.44 mm
Coil_x_-2_-1
Coil_x_-2_0
Coil_x_-2_1
Coil_y_-1_-2
Coil_x_-1_-1
Coil_y_-1_-1
Coil_x_-1_0
Coil_y_-1_0
Coil_x_-1_1
Coil_y_-1_1
Coil_y_0_-2
Coil_x_0_-1
Coil_y_0_-1
Coil_x_0_0
Coil_y_0_0
Coil_x_0_1
Coil_y_0_1
Coil_y_1_-2
Coil_x_1_-1
Coil_y_1_-1
Coil_x_1_0
Coil_y_1_0
Coil_x_1_1
Coil_y_1_1
