nikarus/levitating_chess/methodology/cad/output/single_coil.step

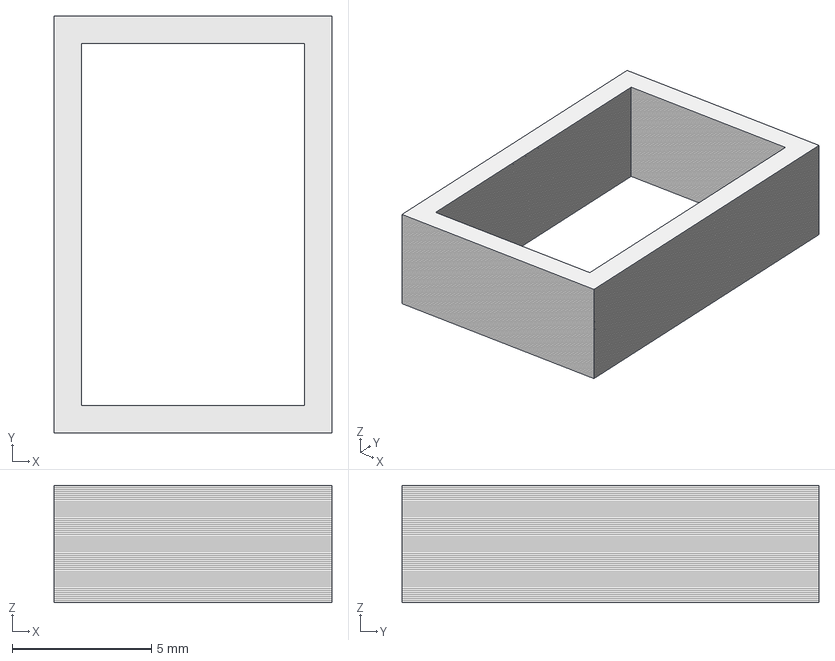
[picture p15: CAD file, 2026-10-09]
methodology/cad/output/single_coil.step
9.98 x 15.0 x 4.22 mm
Copper_turn_0_0
Copper_turn_1_0
Copper_turn_2_0
Copper_turn_3_0
Copper_turn_4_0
Copper_turn_5_0
Copper_turn_6_0
Copper_turn_7_0
Copper_turn_8_0
Copper_turn_9_0
Copper_turn_10_0
Copper_turn_11_0
Copper_turn_12_0
Copper_turn_13_0
Copper_turn_14_0
Copper_turn_15_0
Copper_turn_16_0
Copper_turn_17_0
Copper_turn_18_0
Copper_turn_19_0
Copper_turn_20_0
Copper_turn_21_0
Copper_turn_22_0
Copper_turn_23_0
Copper_turn_24_0
Copper_turn_25_0
Copper_turn_26_0
Copper_turn_27_0
Copper_turn_28_0
Copper_turn_29_0
Copper_turn_30_0
Copper_turn_31_0
Copper_turn_32_0
Copper_turn_33_0
Copper_turn_34_0
Copper_turn_35_0
Copper_turn_36_0
Copper_turn_37_0
Copper_turn_38_0
Copper_turn_39_0
Copper_turn_40_0
Copper_turn_41_0
Copper_turn_42_0
Copper_turn_43_0
Copper_turn_44_0
Copper_turn_45_0
Copper_turn_46_0
Copper_turn_47_0
Copper_turn_48_0
Copper_turn_49_0
Copper_turn_50_0
Copper_turn_51_0
Copper_turn_52_0
Copper_turn_53_0
Copper_turn_54_0
Copper_turn_55_0
Copper_turn_56_0
Insulation_turn_0_0
Insulation_turn_1_0
Insulation_turn_2_0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
