nikarus/levitating_chess/(list of files, cad)

Other CAD files:
methodology/cad/output/coil_assembly.FCStd
methodology/cad/output/coil_assembly_exploded.FCStd
methodology/cad/output/single_coil.FCStd
methodology/results/cad/electronics/driver_assembly.FCStd
