nikarus/levitating_chess/methodology/NEXT_STEPS.md

# Next steps

Complete the virtual design before manufacturing or physical tests. Use the existing CAD, MuJoCo, magnetic, electrical and sensing implementations. The [simulator reference](docs/SIMULATOR.md) defines numerical verification; the [single-piece checklist](docs/SINGLE_PIECE_TESTS.md) defines flight-test coverage; [MODELING_APPROACH.md](docs/MODELING_APPROACH.md#physical-model-verification-gate) retains measured evidence and limitations.

## Complete electronics simulation

This checkout owns the electronics implementation and the supporting geometry/cost study. The separate smoother-observer flight run completed its bounded move-and-hold case successfully in the original checkout; do not edit its sources, caches or results. The [coil reference](docs/COILS.md#driver-count-investigation) owns the preliminary comparison and limitations. No alternative geometry is selected.

Completion requires a working integrated electronics model, matching complete KiCad schematics, representative PCB and thermal feasibility, and a schematic-derived production cost estimate. Continue through routine diagnostic failures and component choices without stopping at each milestone. Stop for a genuine requirement/data blocker or when this complete virtual-design gate is reached. The full movement campaign and multi-piece mechanics remain separate; conservative electrical load envelopes must be labelled where motion evidence is unavailable.

Price the complete installed chain throughout the work at the configured production volume, using dated supplier tiers without invented volume discounts. Keep a working reference while evaluating cheaper alternatives. The expensive reference ADC is not a production selection.

**Keep normal-operation limits unchanged while completing independent protection.** The [full-voltage command-fault screen](results/electronics/current_loop/full_voltage_fault/summary.json) cannot keep an arbitrary erroneous drive below the operating peak with the selected driver's maximum disable delay. Qualify a separate fault response against actual component current, duration and energy limits, and redesign the cutoff if those cannot be met. The component rating alone is not a transient thermal or fault qualification. The missing-pulse watchdog covers stale valid commands only. Resolve routine circuit choices autonomously; do not make the normal limits less demanding to obtain a pass.

1. **Close the current-acquisition and regulation gate, then finish the schematic.** Use the [electronics verification coverage](docs/MODELING_APPROACH.md#electronics-verification-coverage) as the owner of evidence and limitations. The working candidate uses two separate bridge-return shunts, one INA181A1, a physical output filter and paired ADS8698 samples with staggered regulation. The ADC remains a technical reference pending complete accuracy, noise and cost evaluation. Preserve independent coil commands and existing current, timing and noise requirements.

   Close calibration, temperature drift, complete noise/error allocation and the remaining switching corners using the existing passing bounded evidence. The native repeated channel, acquisition/reference, controller and independent enable-protection sheets form an eight-coil group. The compiled runtime is now coupled to eight independently commanded physical current/filter plants through tagged ADC frames, idle zero calibration and scheduled PWM commits. The shared-supply corner batch and earliest/latest phased switching checks pass their bounded requirements. Finish manufacturer-model replay and the remaining error allocation, then implement shared rails and protection; keep switching/vendor evidence separate from the integrated averaged approximation. Complete actual DMA/register service, pad and synchronizer timing, synchronized PWM, commit-driven heartbeat, communication and execution-time verification. The compute deadline remains an allocation. Verify physical cold startup and sleep/wake transitions, independent rail supervision and arbitrary-overcurrent shutdown; the watchdog covers stale valid commands only. Keep limits unchanged and distinguish switching distortion, random noise and numerical error.

   Complete the shared power circuit using the [native-inventory and returned-energy screen](results/electronics/supply/disabled_return/summary.json). Select source regulation/headroom, bulk capacitance and absorbing clamp together; qualify capacitor impedance, pulse current, lifetime and wiring. Include low-power sequencing and wake-ahead scheduling in the system interface. Finish Hall interfaces, programming, calibration, interconnect and their support parts. Verify pins, footprints and ERC, then price the installed chain at aggregate production demand. The old estimated BOM and incomplete placement are not a complete baseline.

   Maintain the existing [coverage table](docs/MODELING_APPROACH.md#electronics-verification-coverage): each function, its schematic parts, verification method, model source/limitations, evidence and unresolved gaps. Every part must be accounted for, but not every part needs a detailed transistor model. Use compatible manufacturer models where available, explicit behavioural models or datasheet bounds where justified, and mark unsupported behaviour as unverified. Do not treat a symbol, footprint or 3D model as an electrical model; the candidate integrated driver's simulation-model availability remains to be established. Resolve or conservatively bound gaps that could change controllability, protection, heat or cost before accepting the baseline.

2. **Verify electrical delivery and measurement with targeted virtual tests.** Reuse saved flight current requests and operating conditions to define loads; they do not establish all required operating extremes. Add demanding current reversals, ramps, sustained loads, simultaneous channel loads and startup/disable/fault cases within the model-owned requirements. Use KiCad/ngspice for representative circuits and Python for digital regulation, sampling and timing. Keep test circuits tied to the schematic connectivity and selected parts. Check delivered current against requested current, tracking delay, overshoot, PWM ripple, dead time, voltage headroom, disabled-coil decay, bus droop/regeneration and losses. Include or bound coil resistance/inductance uncertainty, motion-induced voltage, mutual coupling and relevant wiring/PCB parasitics.

   Compare simulated physical current with the complete readout chain's reported current. Account for shunt/amplifier/reference/ADC errors, temperature, filtering, clipping, effective resolution, noise and switching recovery; include Hall acquisition and coil-field subtraction interfaces. Budget sampling phase, channel skew, conversion, processing, communication and actuation delay. Preserve distinct command, regulator, feedback and carrier clocks. Check component tolerances and supply/temperature ranges, numerical convergence and agreement with analytical or datasheet checks where applicable. Record which behaviours each model actually covers; ERC and an ideal-switch ripple pass are not functional verification of the selected driver.

3. **Return verified electronics behaviour to the system model.** Derive a compact electrical/sensing model from the circuit evidence and compare it with the detailed circuit tests before using it for flight. Carry current response, ripple effects, measurement errors, delays, saturation and fault/disable behaviour into the existing implementation without duplicating its owners. Verify that the sensor-based flight controller still works with these effects. Reuse recorded-data tests first; run new coupled flight tests when changed feedback or actuation makes replay insufficient. Coordinate changes with the flight checkout's owner; do not modify its running sources or assume the current flight evidence qualifies the new bridge/supply. Avoid simulating every transistor across the whole chessboard when a verified reduced model answers the system question.

4. **Establish PCB feasibility and thermal behaviour together.** The current native group already consumes nearly all component courtyard area in the exploratory two-board stack. Shared power, Hall acquisition and interconnect are still missing. Resolve that architecture before detailed routing: compare smaller appropriate packages and shared-function placement, and explicitly review any additional PCB or changed mechanical envelope. The old placement is not evidence that this netlist fits. Add actual shared-function area, coil terminations, inter-board connections and mounting; route critical switching, bypass, power and Kelvin sensing paths. Establish copper/layers and relevant DRC, and provide an accessible heat path for both driver faces before accepting the stack. Carry geometry into inspectable KiCad/FreeCAD files with unfinished models labelled. Do not silently enlarge the stack, reduce current/sensing capability or change coil geometry to make it fit. Review the architecture before full tile routing.

   Develop losses and thermal estimates alongside circuit selection. Reuse the Python heat-path/thermal-mass model, then Elmer/Gmsh with simplified FreeCAD geometry for a representative assembly before finalizing cooling. Include coils, switches, shunts, logic and supplies; preserve mean-square current, ripple and switching loss when reusing recorded workloads. Cover moving single-piece loads, repeated local dwell and simultaneous sliding reset, including the protected product testing requirements. Bound uncertain thermal interfaces and cooling, check component and touch temperatures, and feed hot resistance back into electrical estimates. Refine full-board spatial detail or airflow only where a decision needs it. Instantaneous patch loss is not steady whole-board heat.

5. **Cost the complete baseline and choose production modules.** Export quantities from the completed schematic and derive installed coil/channel counts from the current square layout. Include shared electronics, PCB fabrication and assembly, interconnect, cooling, wire/winding/termination, potting, enclosure, calibration and production testing. Price at the configured production volume; separate dated catalogue tiers, quotations and allowances, and recurring costs from development/tooling. Treat the small CAD patch as a density-study window, not a chess square or selected production module. Compare larger repeatable modules using shared-circuit costs, routing/cooling feasibility, interconnect, assembly yield and rework. Report incomplete functions and cost uncertainty. Accept the baseline only when circuit evidence, timing, representative routing, thermal estimates and the BOM describe the same configuration; this is a virtual-design milestone, not physical validation.
6. Compare coil alternatives against that baseline before authorizing more expensive geometry qualification. Determine whether each alternative reuses the driver and sensor electronics; account for actual installed counts, shared infrastructure, power/cooling changes and cost uncertainty. If candidate cost ranges overlap enough to reverse the ranking, refine the dominant uncertainty first. Then search economically promising candidates for physical weaknesses. Carry the recorded rotated failure into the shared challenge collection and preserve equivalent relative coil/magnet alignments across lattice orientations. Search phase, height and orientation, add weaknesses and rescreen with unchanged limits; reserve broader coverage, magnetic refinement, continuous-conductor and material-uncertainty checks for finalists. The [completed sweep](docs/COILS.md#parameter-sweep-results) remains preliminary evidence, not a replacement geometry selection.
7. Extend shared force allocation to nearby pieces, with mutual magnetic forces and resting-contact constraints. Test distinct commands, stationary neighbours and crowded/scattered simultaneous sliding reset; establish when distant effects may be neglected. Feed the resulting current, sensing and workload requirements back into the electronics and thermal estimate before claiming a final whole-board BOM or selecting a reduced-channel design.

## Flight and design qualification

1. **Establish basic single-piece flight.** Follow SP01–SP05 in the checklist: settling, translation/braking, vertical movement, tilt and continuous rotation. Extend the shared reference generator without animation-specific controllers. Introduce the asymmetric knight alongside the king once basic references work. Keep existing noise enabled and add bounded disturbance/variation checks as each family matures. Perform an early static neighbour force/sensing screen before committing to the full campaign; it does not require a multi-piece dynamic controller.
2. **Complete ordinary chess movement.** Follow SP06–SP09: controlled coil/sensor handoffs, verified contact, takeoff, landing and continuous complete moves. Preserve failed contact evidence and unchanged limits until replacement verification passes. Resolve or bound inductance/PWM interference, current-readout timing and construction variation before adopting final hardware targets.
3. **Qualify combined movement and robustness.** Follow SP10–SP12 and the checklist's cross-cutting coverage: curved paths, simultaneous movement/rotation/tilt, oscillation and coordinated dance. Expand disturbance recovery, piece coverage, construction variation and defined fault responses. Revisit numerical verification for new mechanisms or unsupported domains, without repeating unrelated verification for every animation.
4. **Extend to the whole board.** Add neighbours, edges, capture buffers, shared-coil allocation and simultaneous sliding reset. Integrate power distribution, processing, communication, enclosure, cooling and the real-component BOM. Evaluate product workloads, manufacturing variation and faults, keeping single-piece levitation distinct from simultaneous sliding reset.
5. **Review the integrated virtual design.** Require reproducible sensor-based control, numerical verification for the intended use, credible uncertainty ranges and consistent mechanical, electrical and thermal evidence. Only then plan manufacturing and physical validation.

Develop thermal analysis alongside electronics and mechanics, recording currents, voltages and losses and feeding relevant temperature effects back into the model. Resolve winding fit and assembly tolerances before fixing hardware targets.

Build a reproducible staged electronics verification command that fails before dependent stages, preserves its exact configuration and failed evidence, and checks completion against the coverage table. Extend the existing driver/current-reading interfaces with realistic availability times, physical current, rails, losses and fault state; keep physical truth out of controller measurements.

Before an expensive run, identify the unresolved property, acceptance rule and expected decision. Inspect existing processes/evidence, prefer recorded-data diagnosis, and preserve source/settings provenance, automatic stops and checkpoints. Wait for launched batches to finish rather than periodically inspecting unchanged progress. Never treat process completion as a passed simulation or relax limits merely to obtain a pass.

Keep only remaining work here. Quantitative settings belong in `Inputs`, `Fixed` and `Constants` in [model.py](../model.py), with descriptive comments. Follow the [organization rules](PROJECT_ORGANIZATION.md); reuse existing calculation owners and prune superseded guidance as work proceeds.
