nikarus/levitating_chess/methodology/cad/output/coil_assembly.png

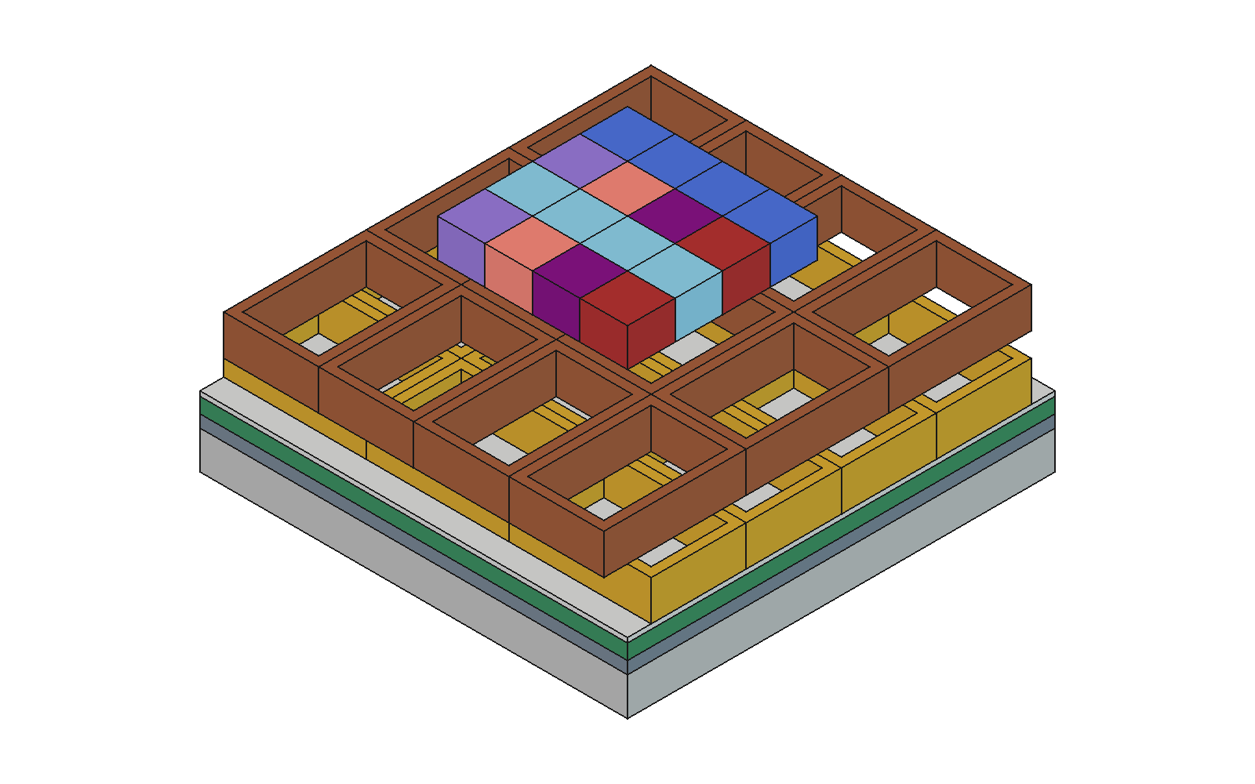
methodology/cad/output/coil_assembly.png
