nikarus/levitating_chess/methodology/cad/output/coil_assembly_exploded.png

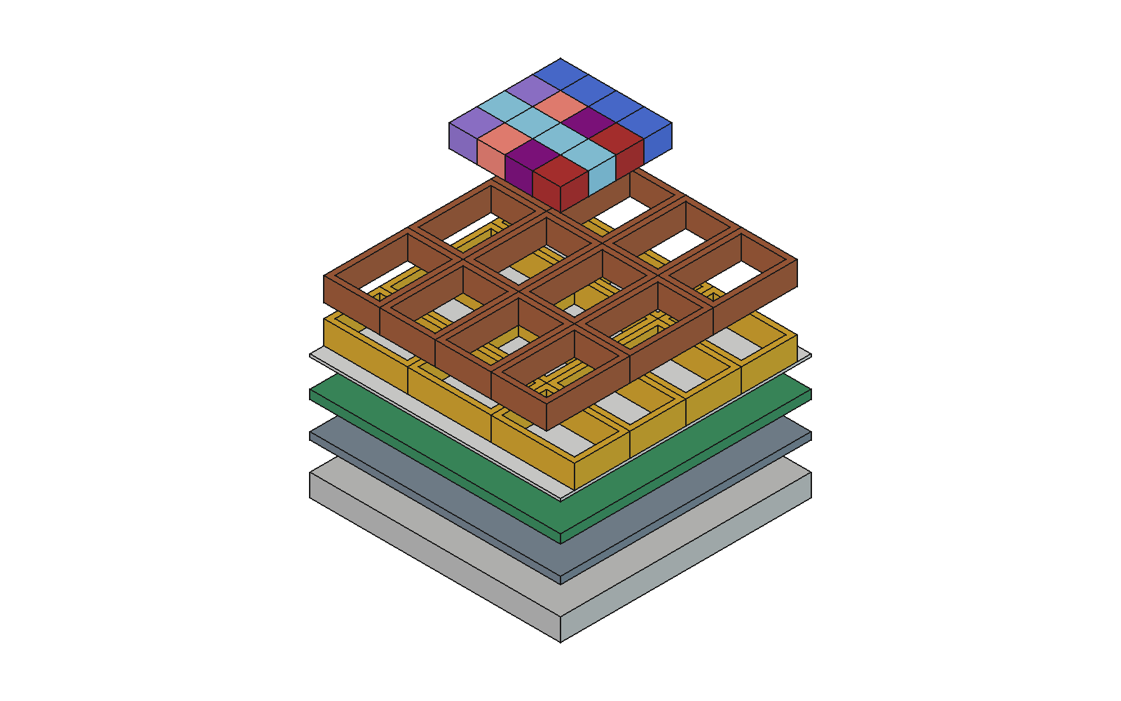
methodology/cad/output/coil_assembly_exploded.png
