nikarus/levitating_chess/methodology/cad/output/square_assembly.png

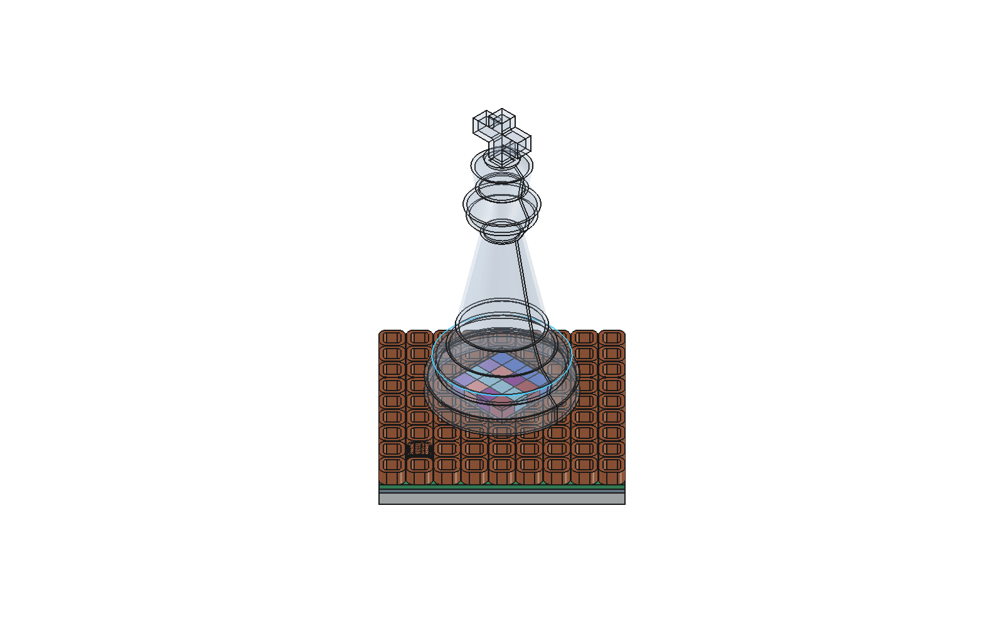
methodology/cad/output/square_assembly.png
