nikarus/levitating_chess/methodology/results/cad/electronics/driver_assembly.png

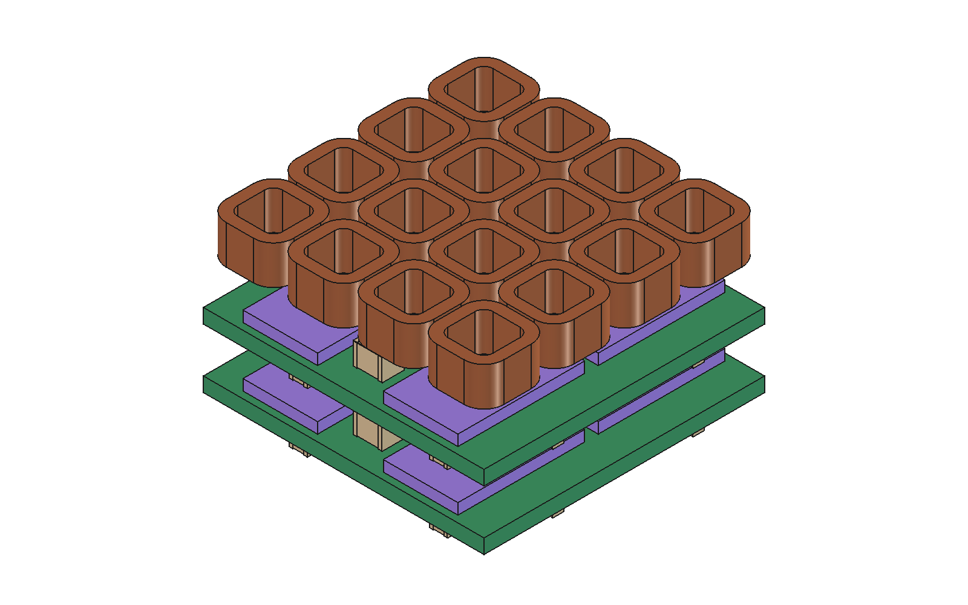
methodology/results/cad/electronics/driver_assembly.png
