nikarus/levitating_chess/methodology/results/cad/square_assembly_detail.png

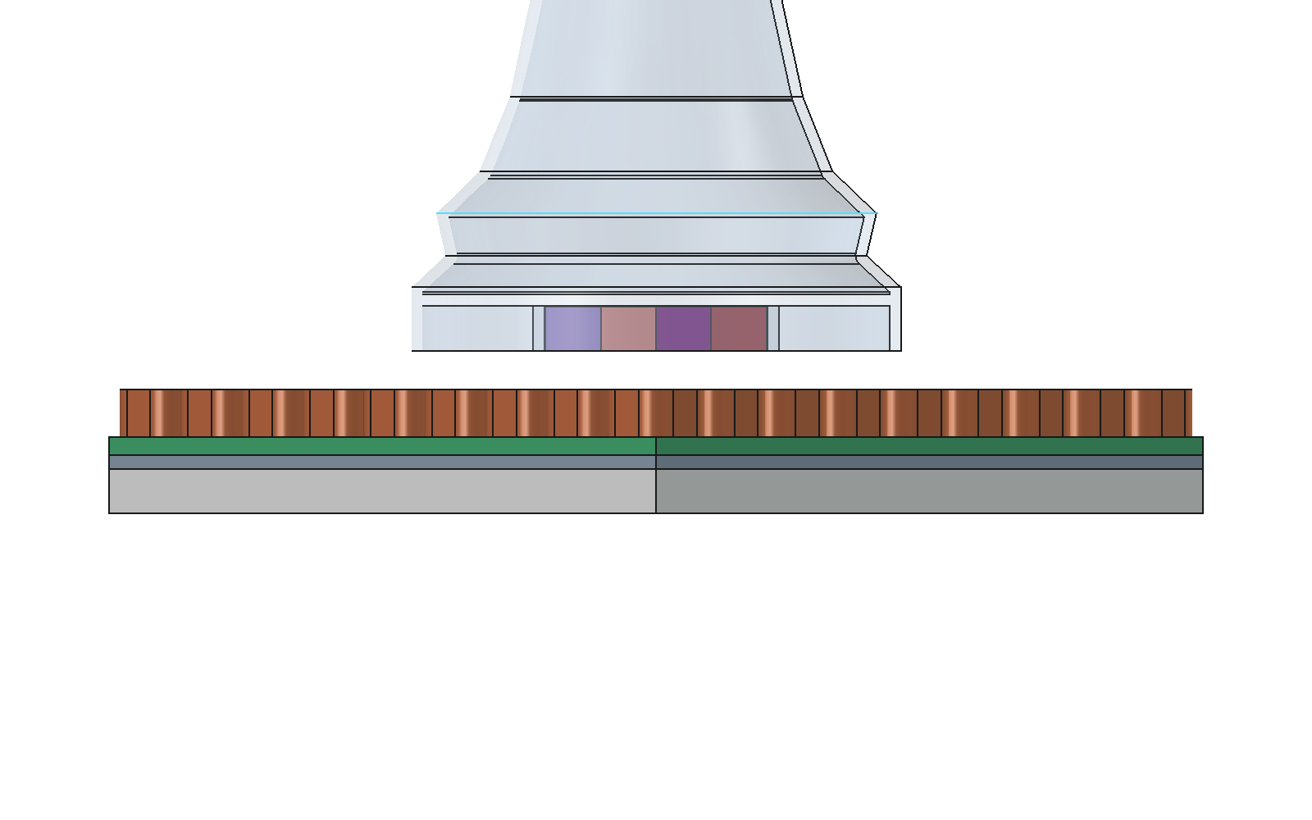
methodology/results/cad/square_assembly_detail.png
