nikarus/levitating_chess/PRODUCT_TESTING.md

# PRODUCT TESTING

H1: From the heat perspective, the following tests must pass:
- T1 Burst: all 32 pieces run A from adversarial positions, then an immediate rematch reset from the home formation (the only physically possible back-to-back second event), then once per 5 min forever.
- T2 Grind: A at the fan-assisted and passive sustained composite-move rates specified in `model.py`, forever.
- T3 Hammer: one cell — aligned 1 s dwell every 5 s forever, plus a 10-exchange capture cascade, plus one hand-placed A.
