nikarus/levitating_chess/methodology/results/cad/square_winding.png

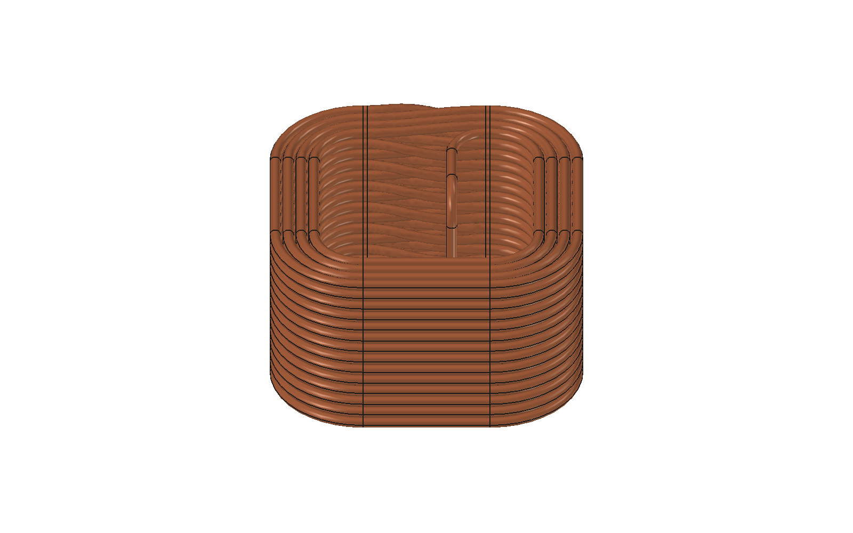
methodology/results/cad/square_winding.png
