nikarus/levitating_chess/methodology/results/channel_layouts/pose_comparison/yaw_comparison.png

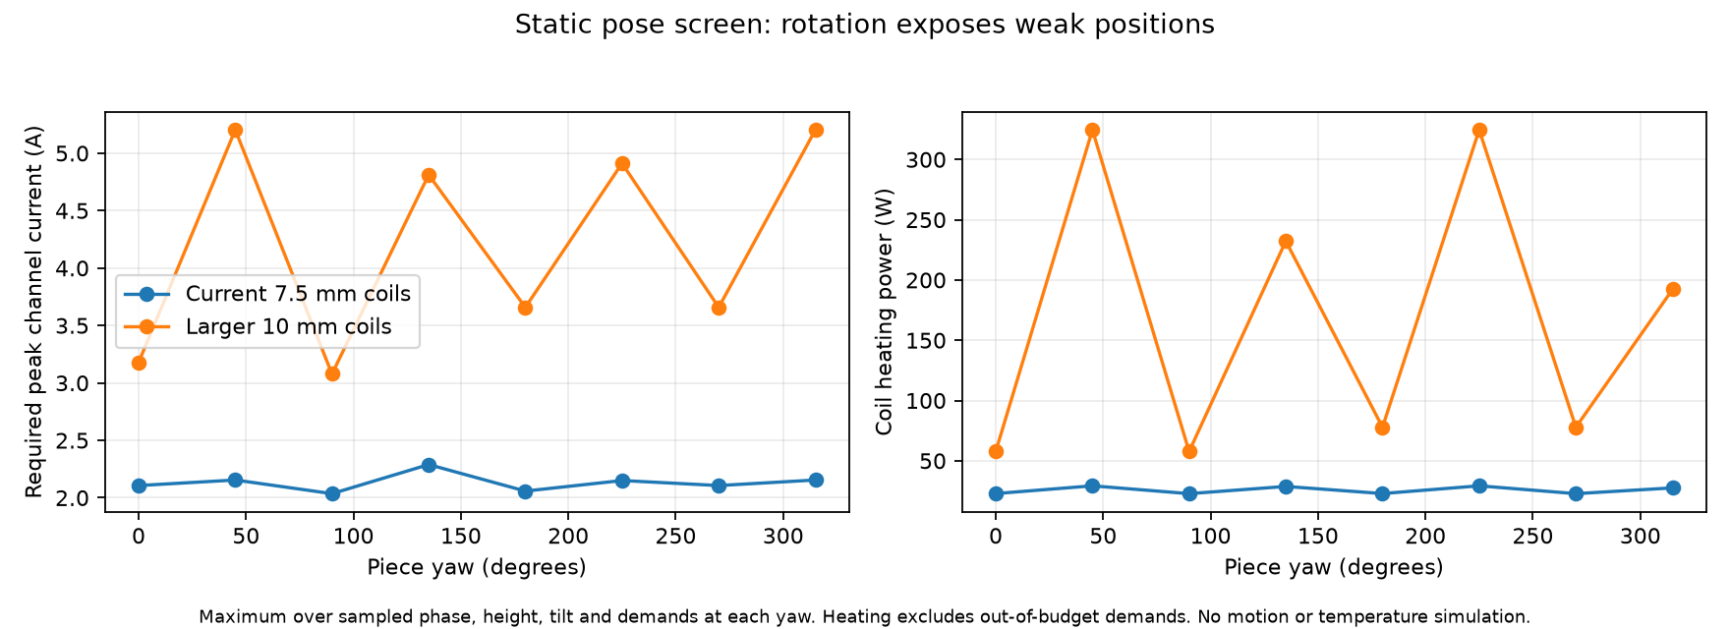
methodology/results/channel_layouts/pose_comparison/yaw_comparison.png
