nikarus/levitating_chess/methodology/results/coil_layouts.png

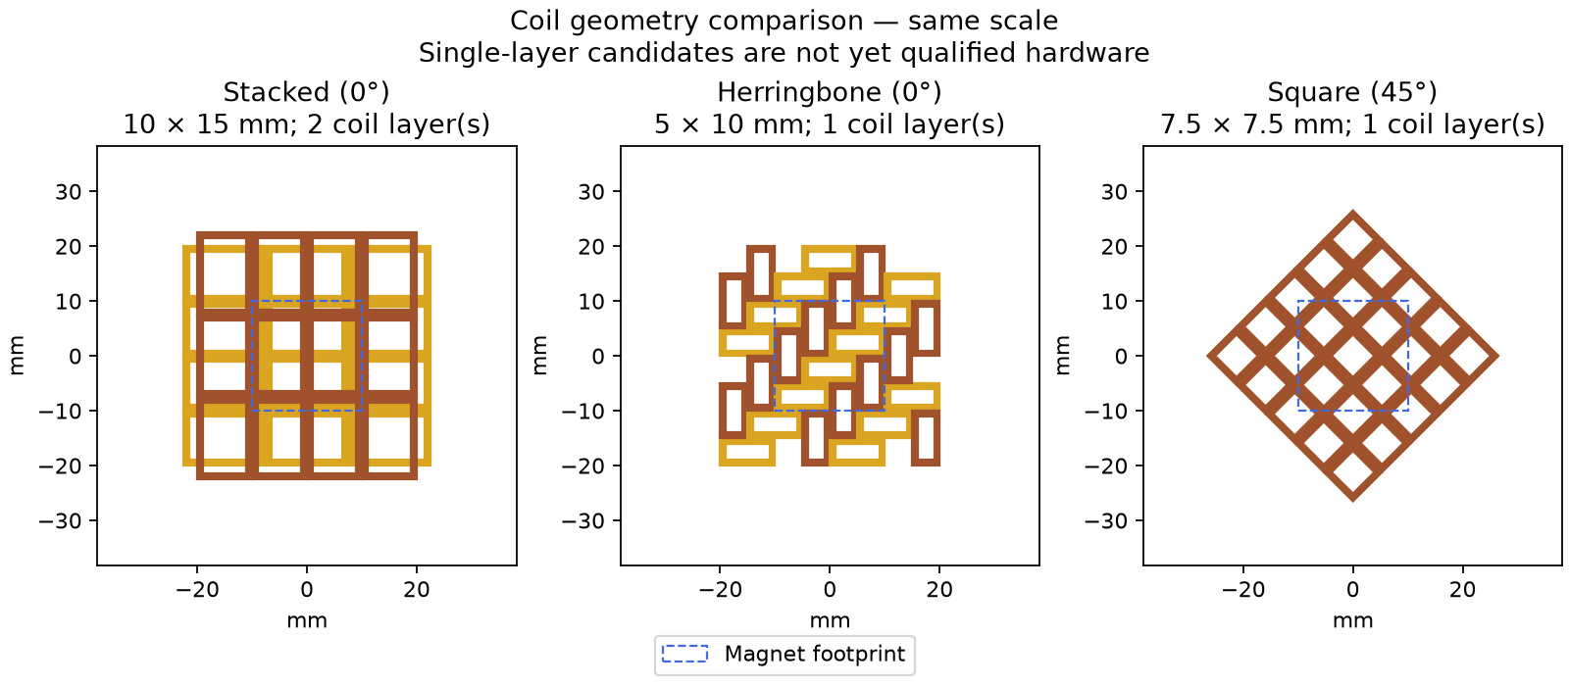
methodology/results/coil_layouts.png
