nikarus/levitating_chess/methodology/results/hover/count_response/response.png

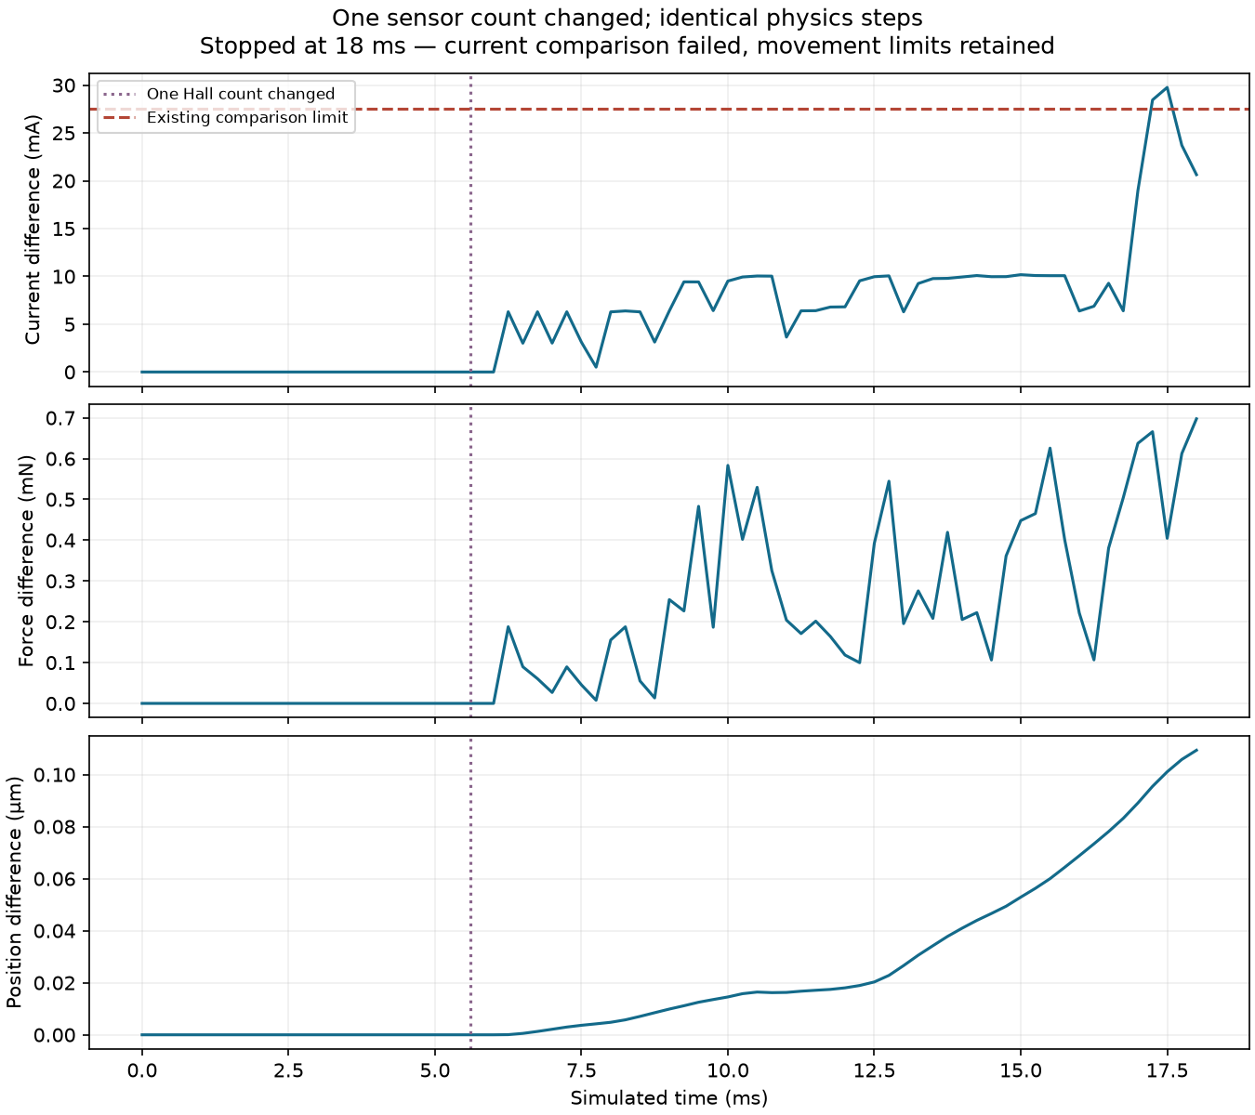
methodology/results/hover/count_response/response.png
