nikarus/levitating_chess/methodology/results/hover/count_response_extended/response.png

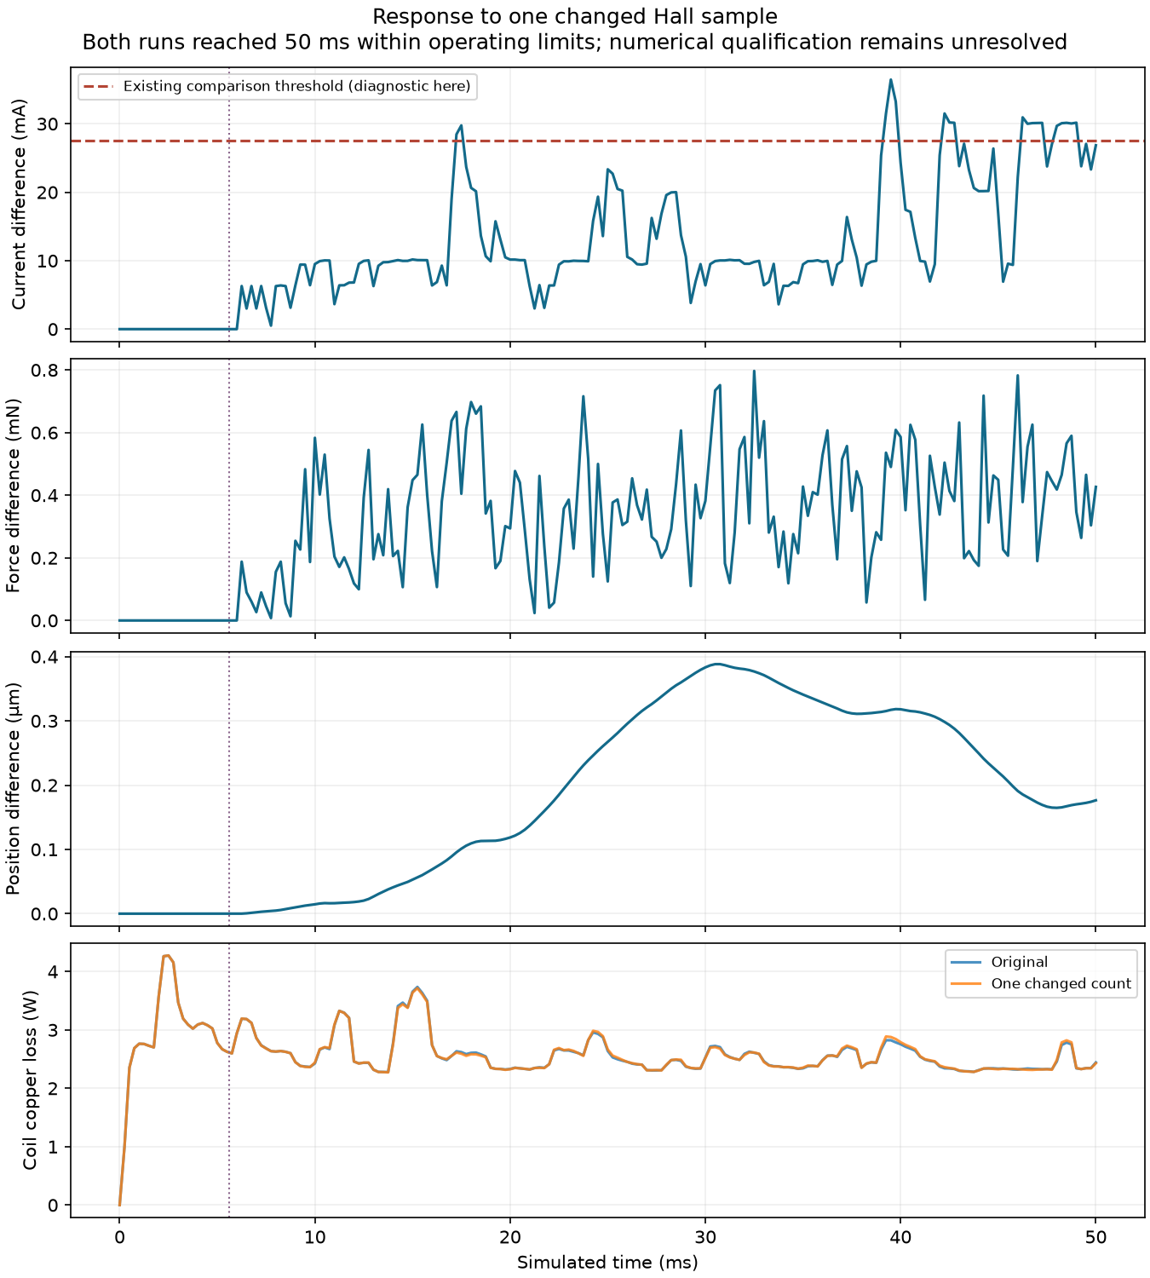
methodology/results/hover/count_response_extended/response.png
