nikarus/levitating_chess/methodology/results/hover/force_attribution.png

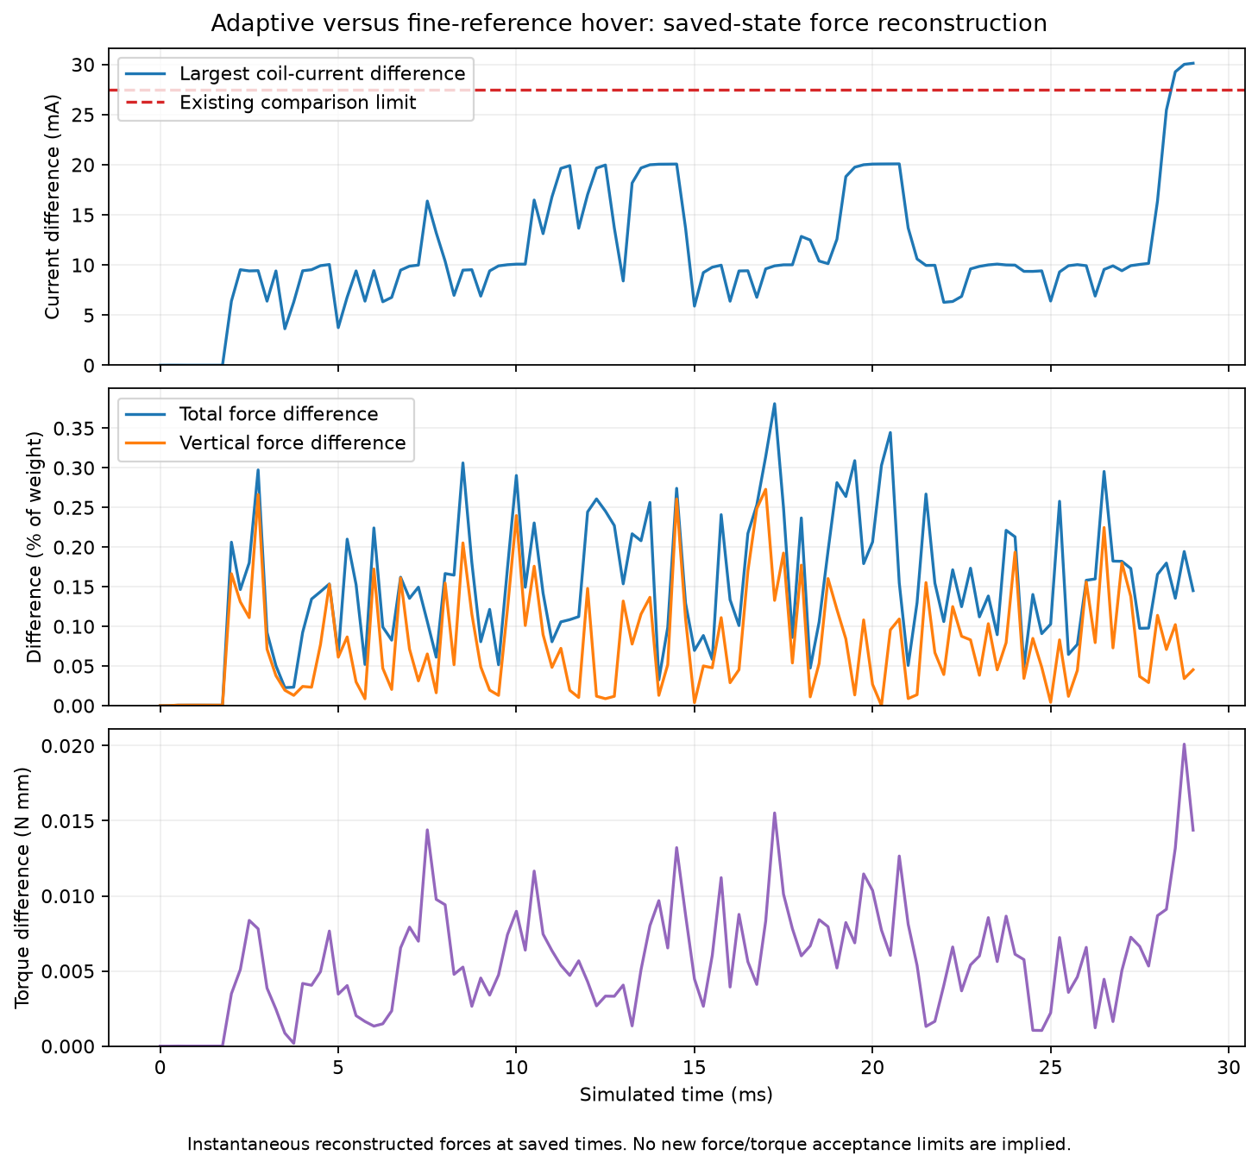
methodology/results/hover/force_attribution.png
