nikarus/levitating_chess/methodology/results/local_motion/trial/tracking.png

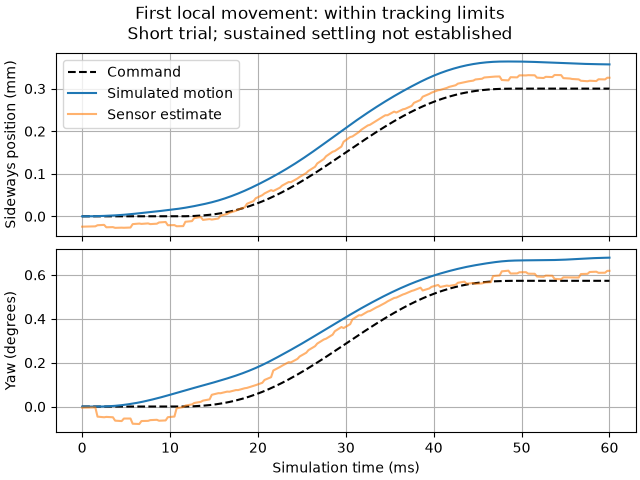
methodology/results/local_motion/trial/tracking.png
