nikarus/levitating_chess/methodology/results/prototype_coils.png

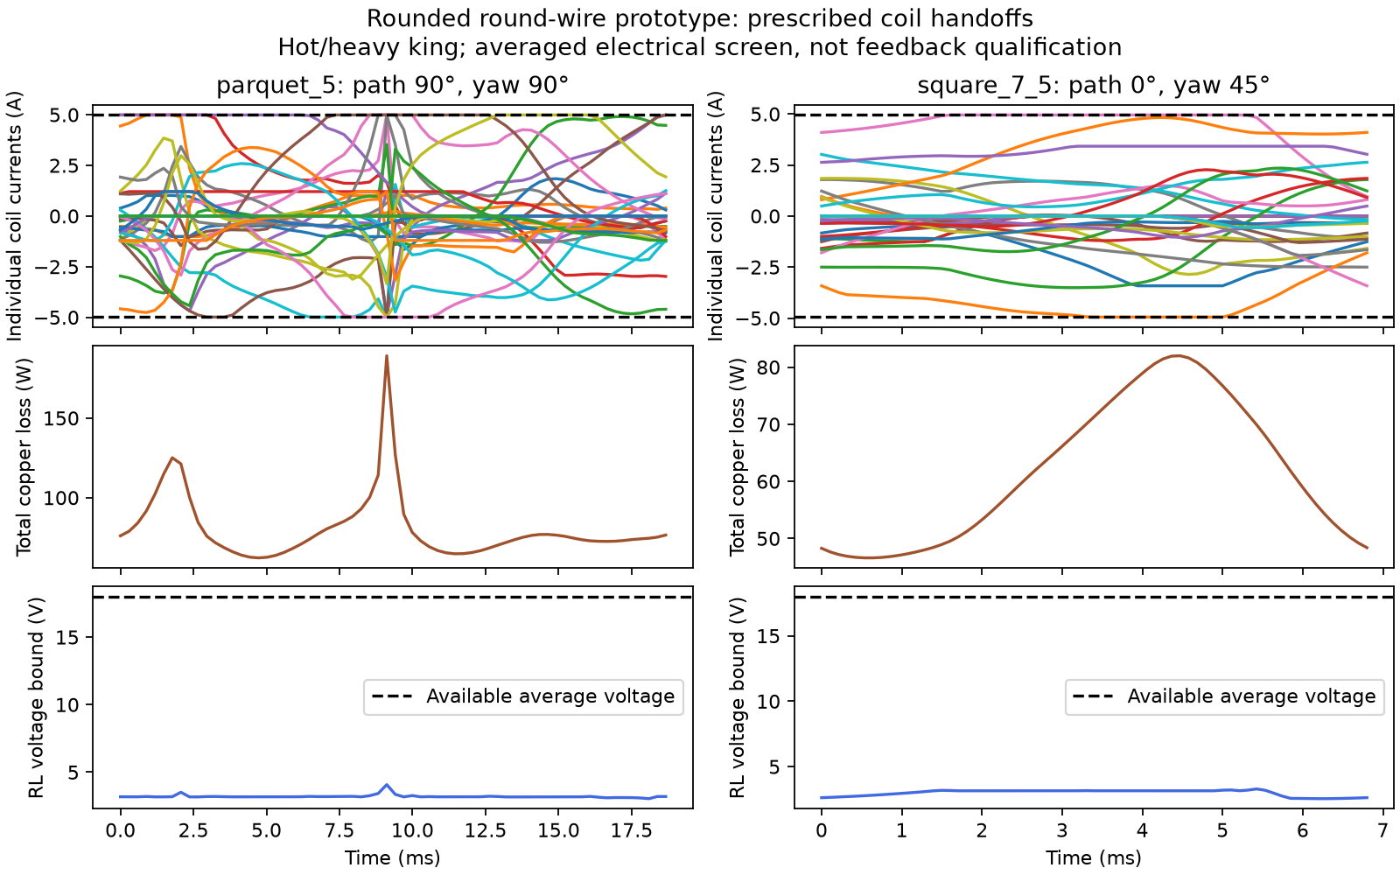
methodology/results/prototype_coils.png
