nikarus/levitating_chess/methodology/results/electronics/integrated_channel/channel.pdf

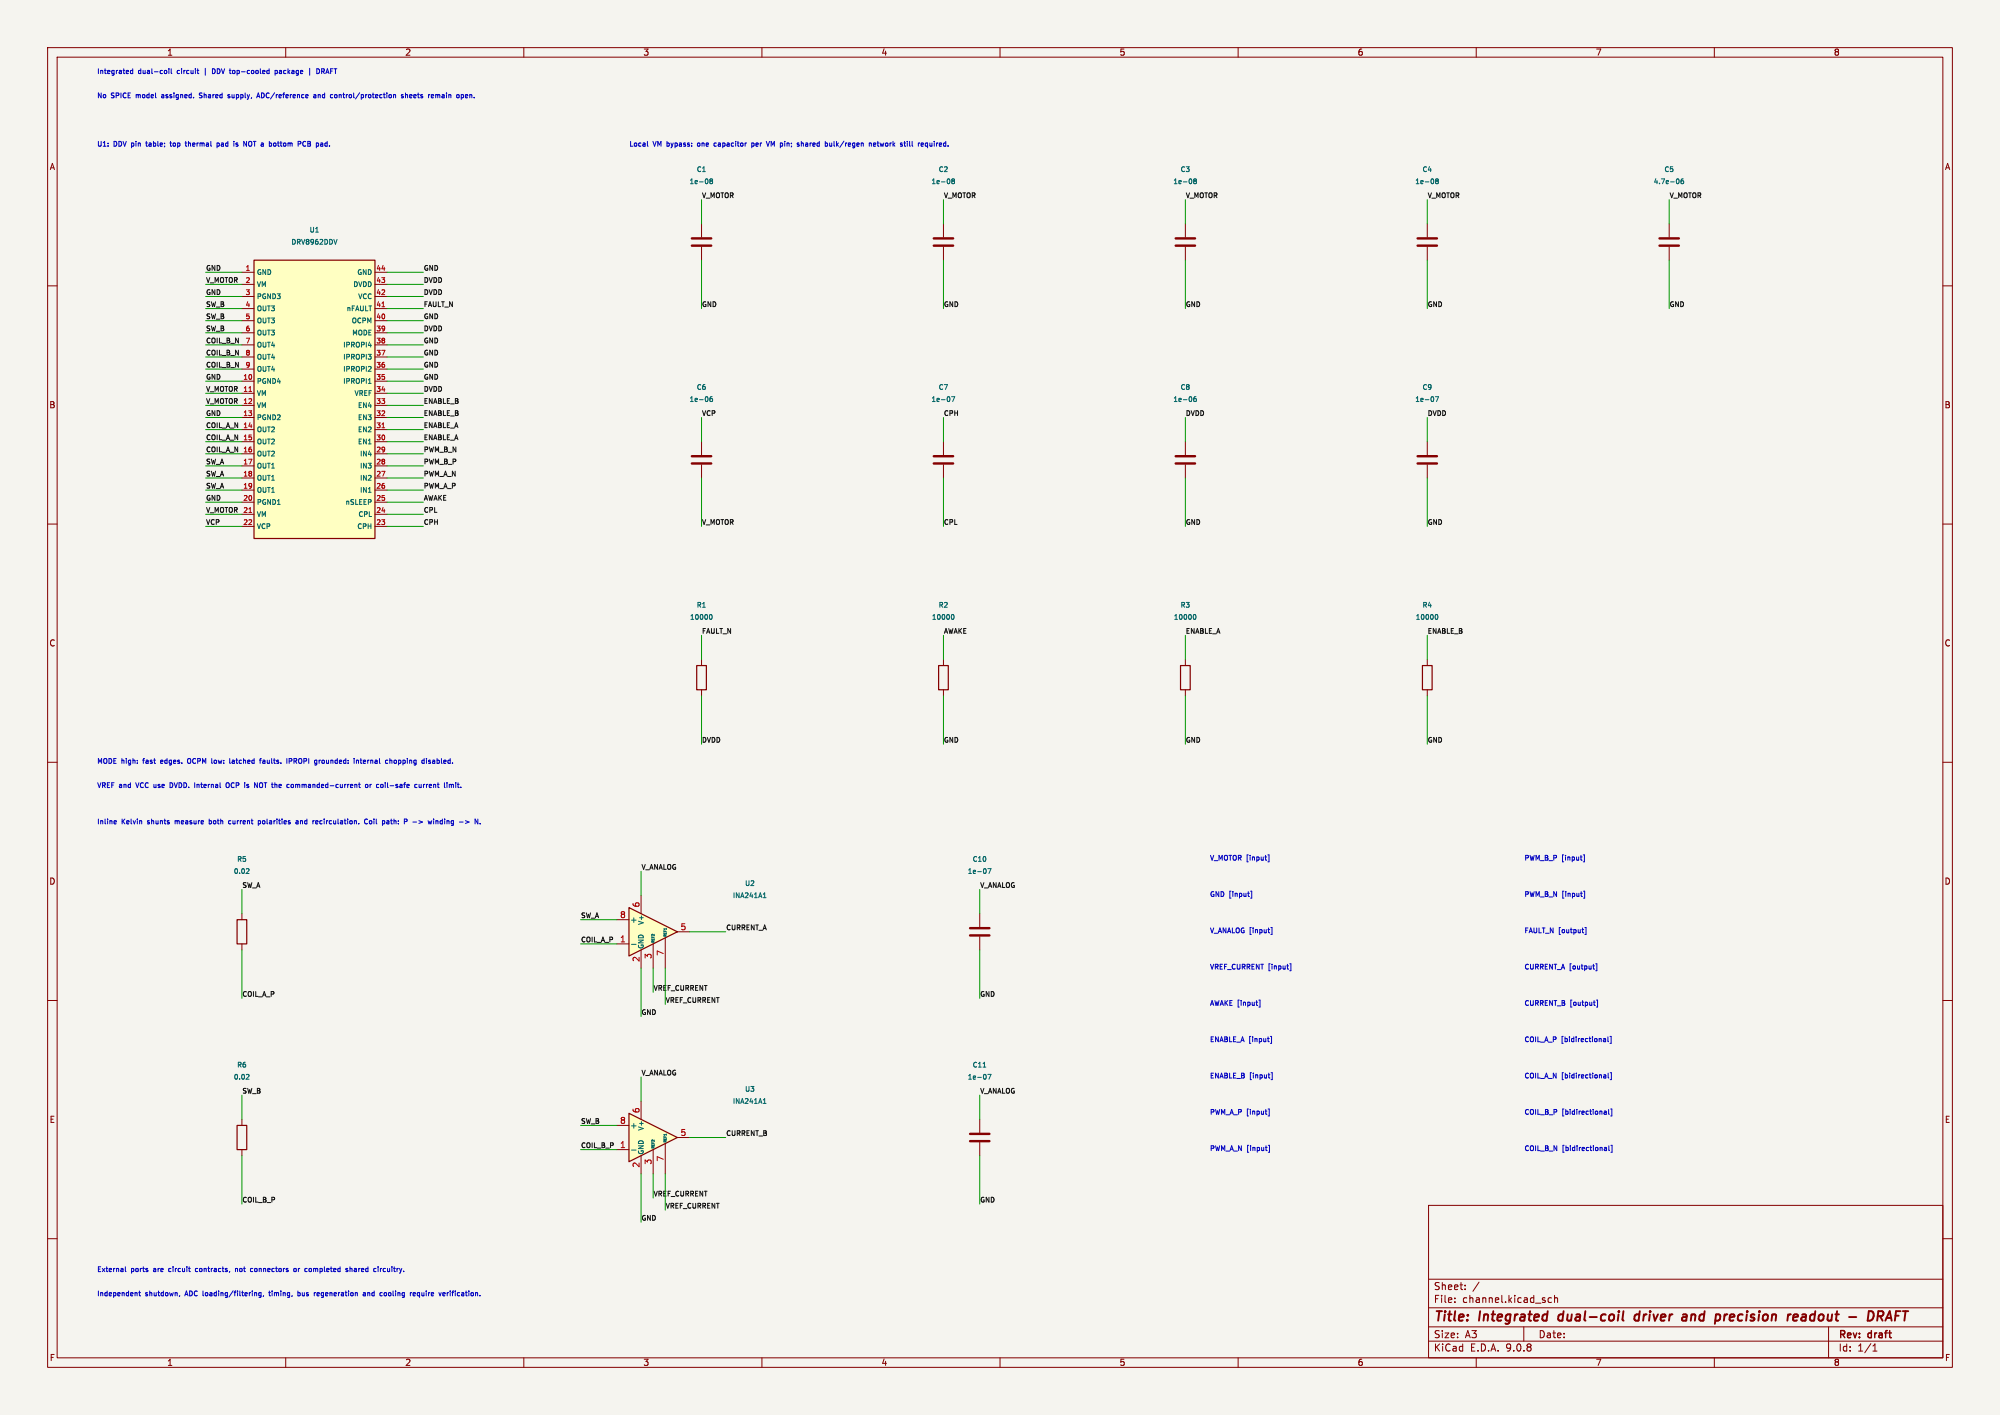
[picture p29: page 1]

COIL_B_P [bidirectional] COIL_A_N [bidirectional] COIL_A_P [bidirectional] CURRENT_B [output] CURRENT_A [output]
