nikarus/levitating_chess/methodology/results/cad/electronics/control_group/control_group.pdf

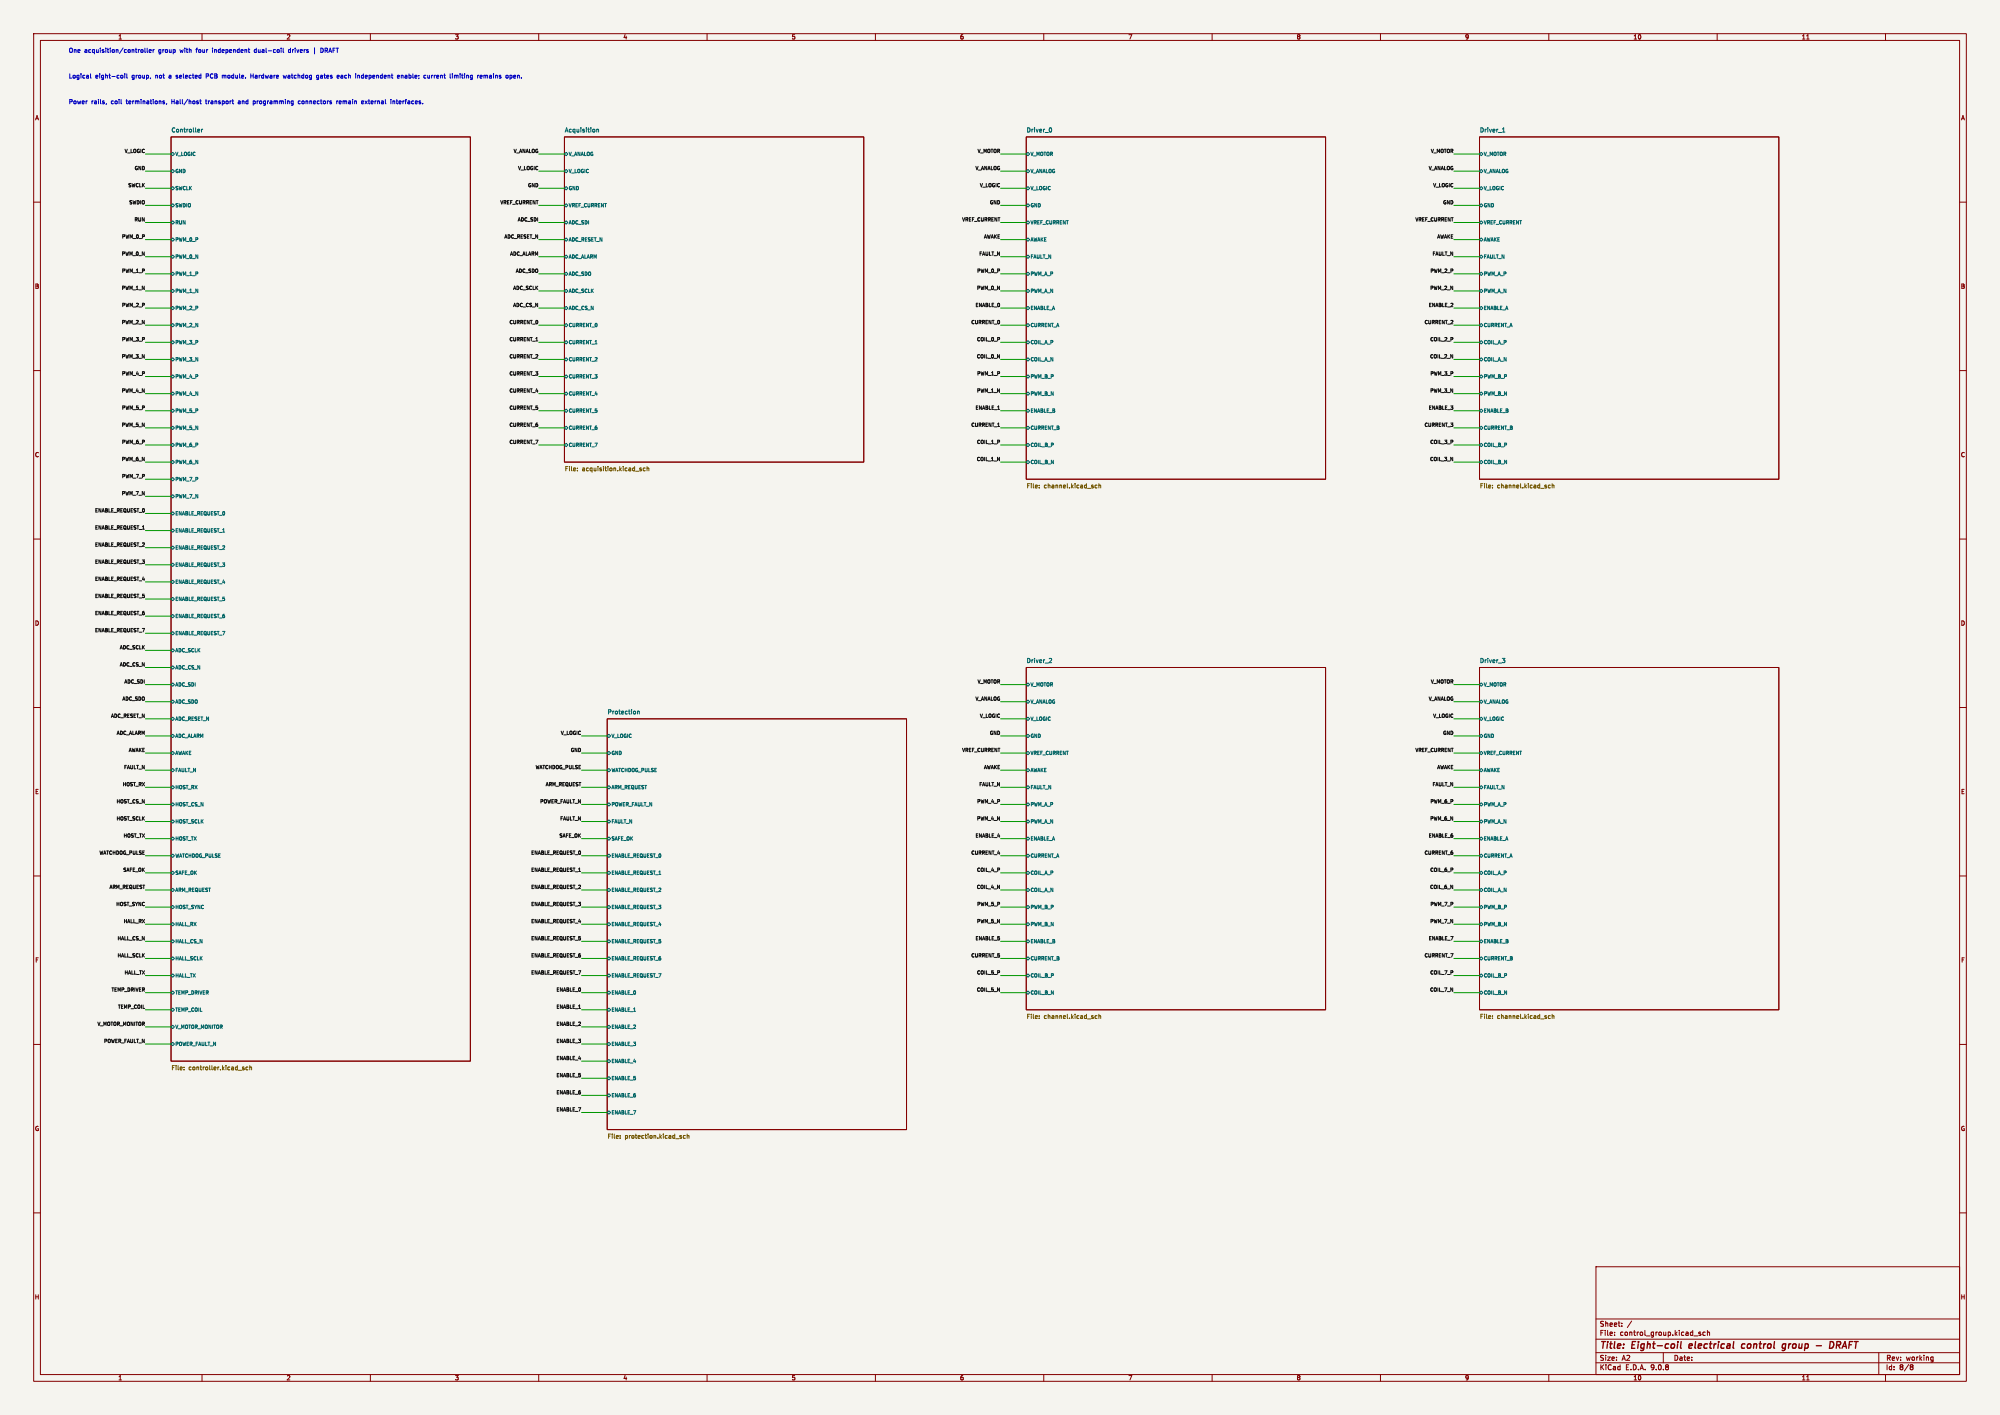
[picture p30: page 1]

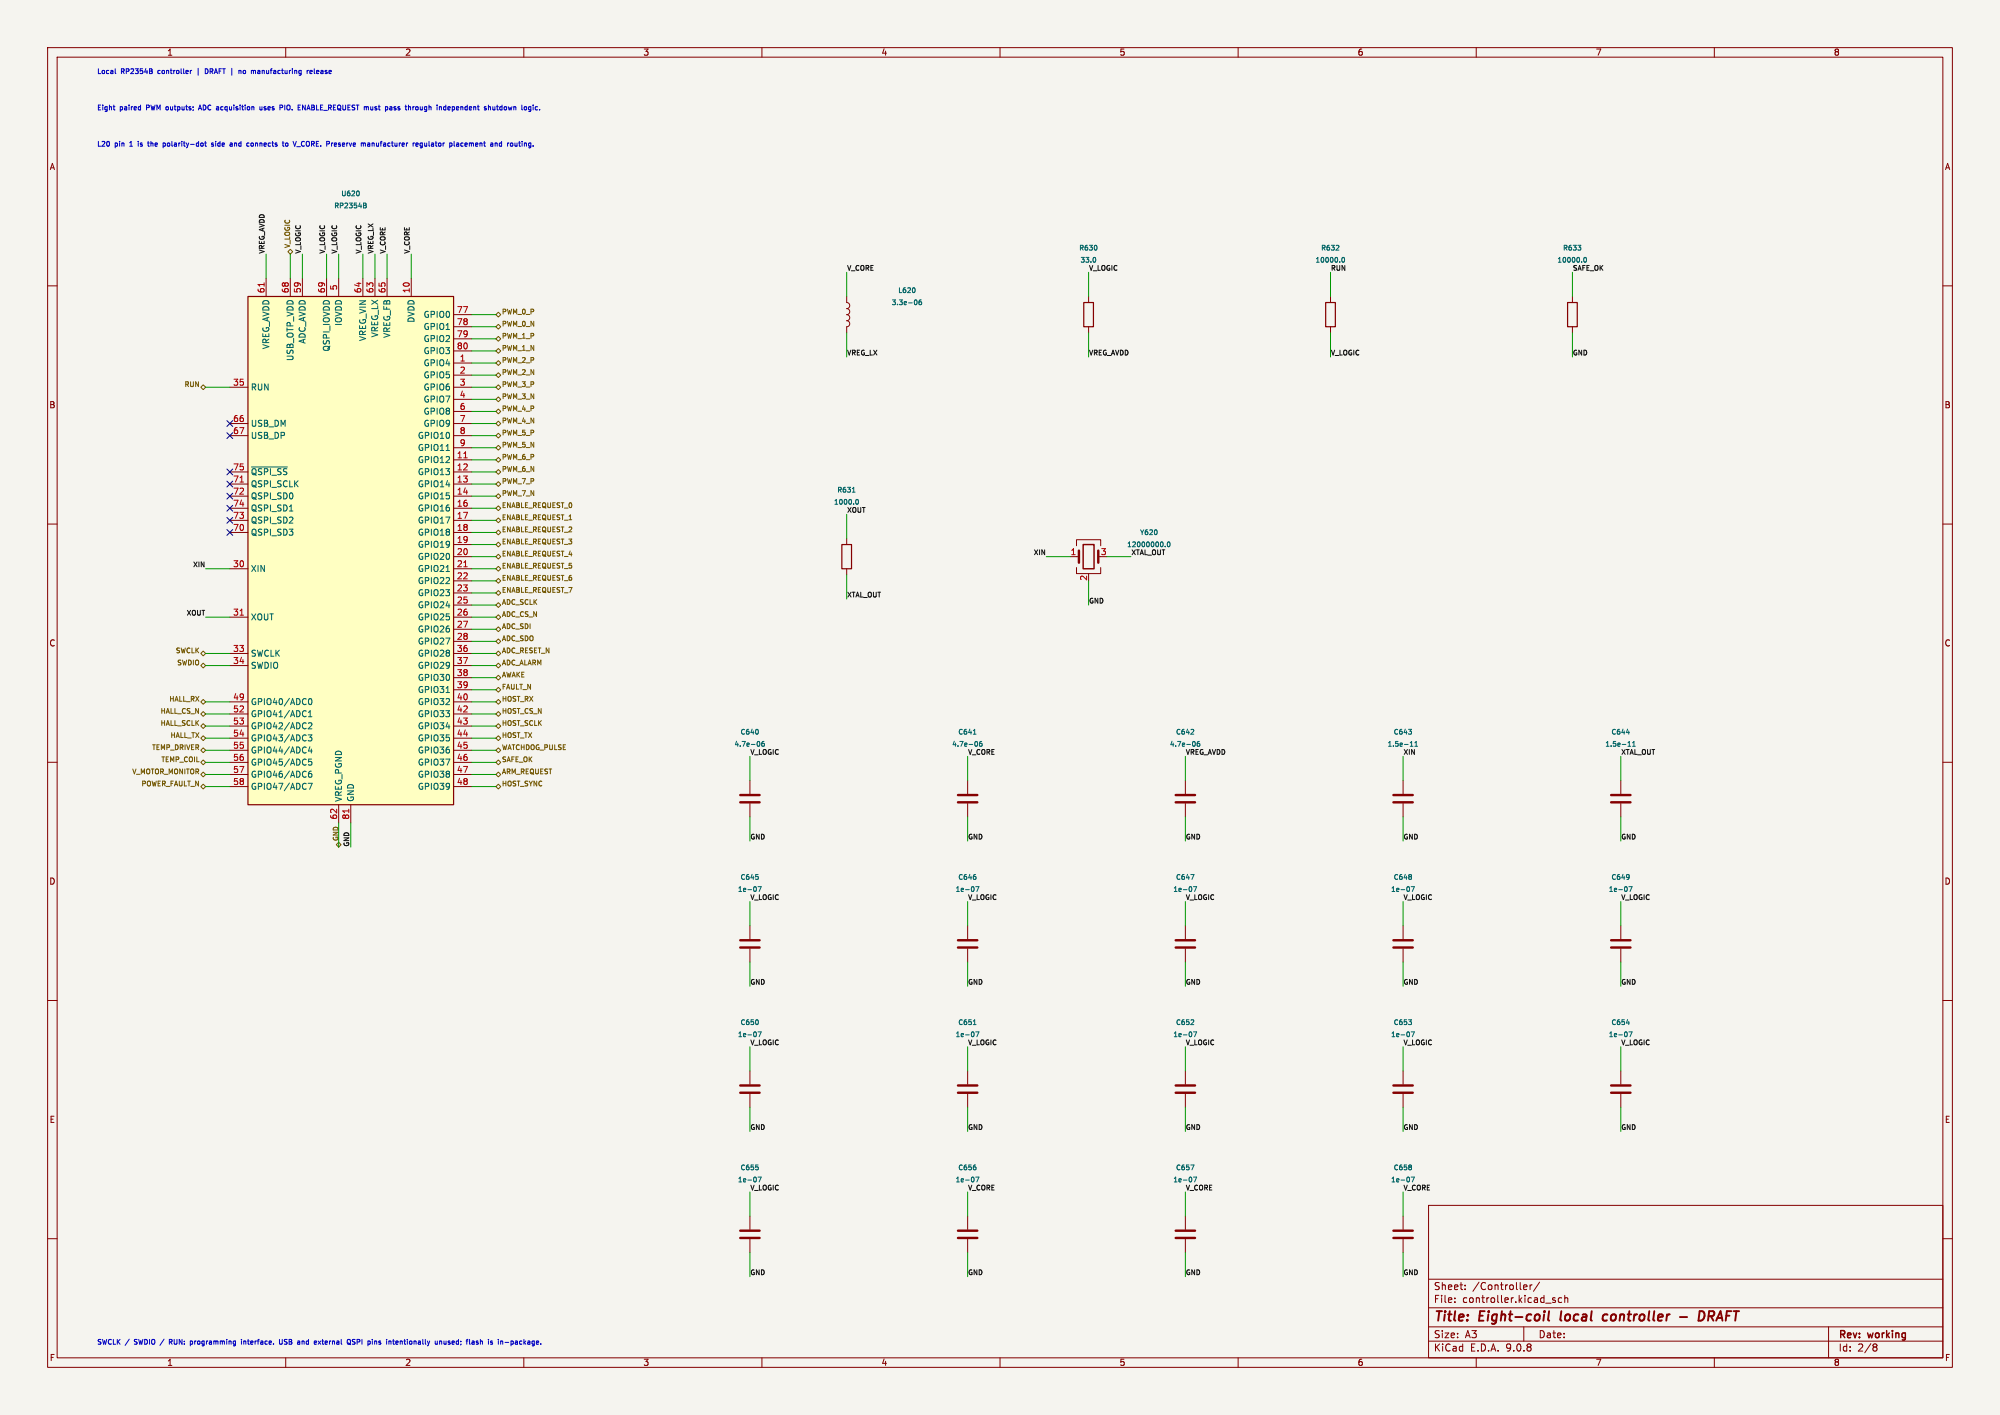
[picture p31: page 2]

File: controller.kicad_sch Sheet: /Controller/ C658

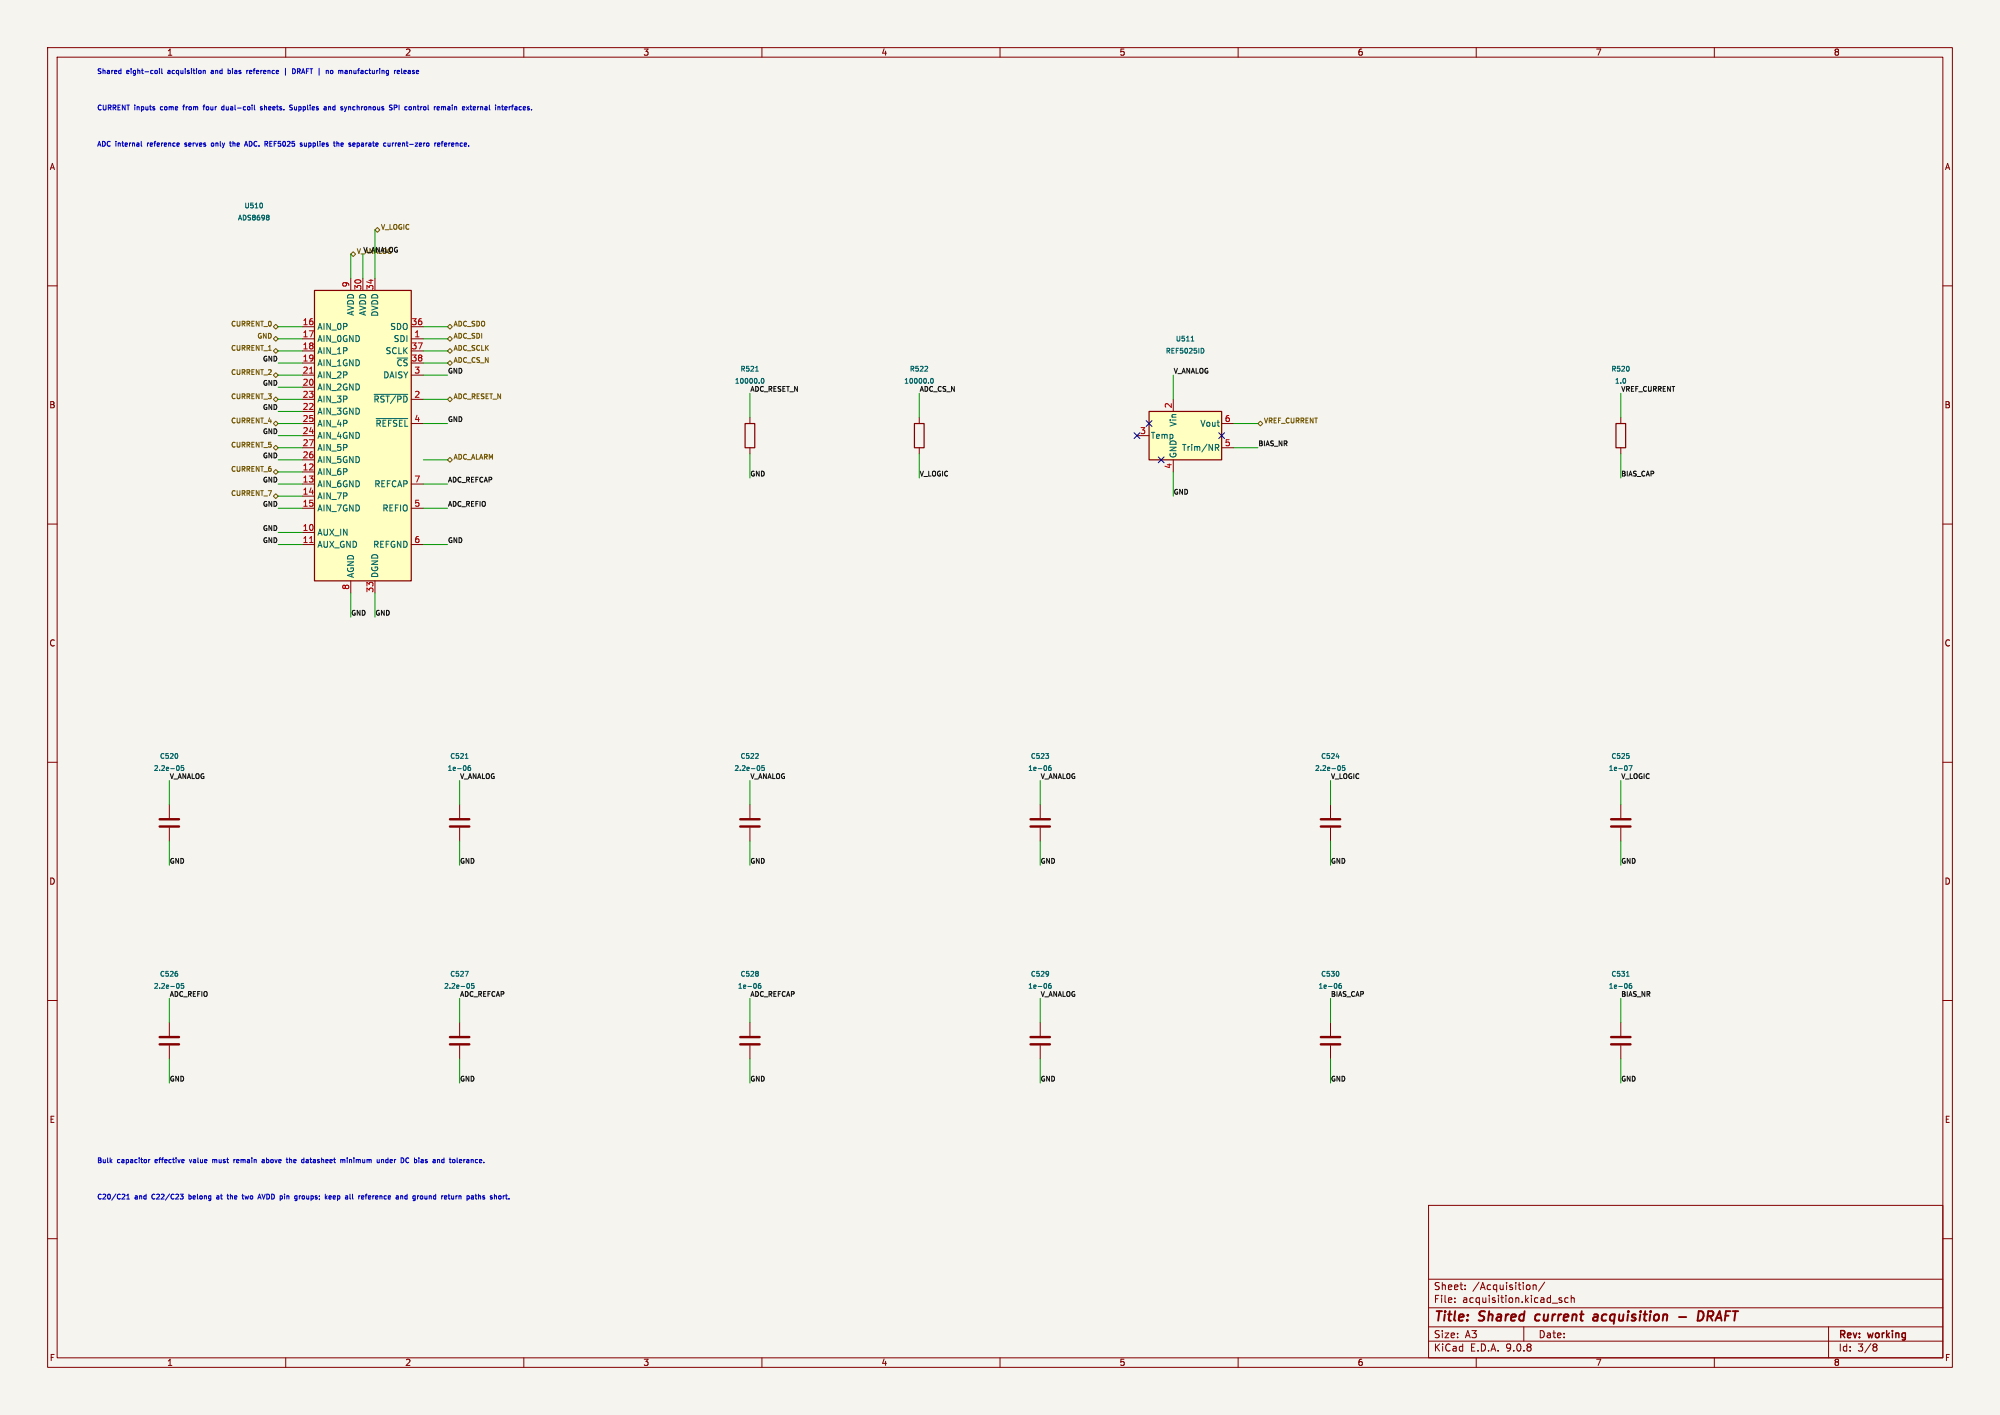
[picture p32: page 3]

8 AVDD 30 DVDD 34 DGND 33 SDO 36 SDI 1 SCLK 37 ~{CS} 38 DAISY 3 ~{RST/PD}2 ~{REFSEL}4 REFCAP 7 REFIO 5 REFGND 6 U510 ADS8698
ADC_RESET_N

Id: 3/8 Title: Shared current acquisition - DRAFT

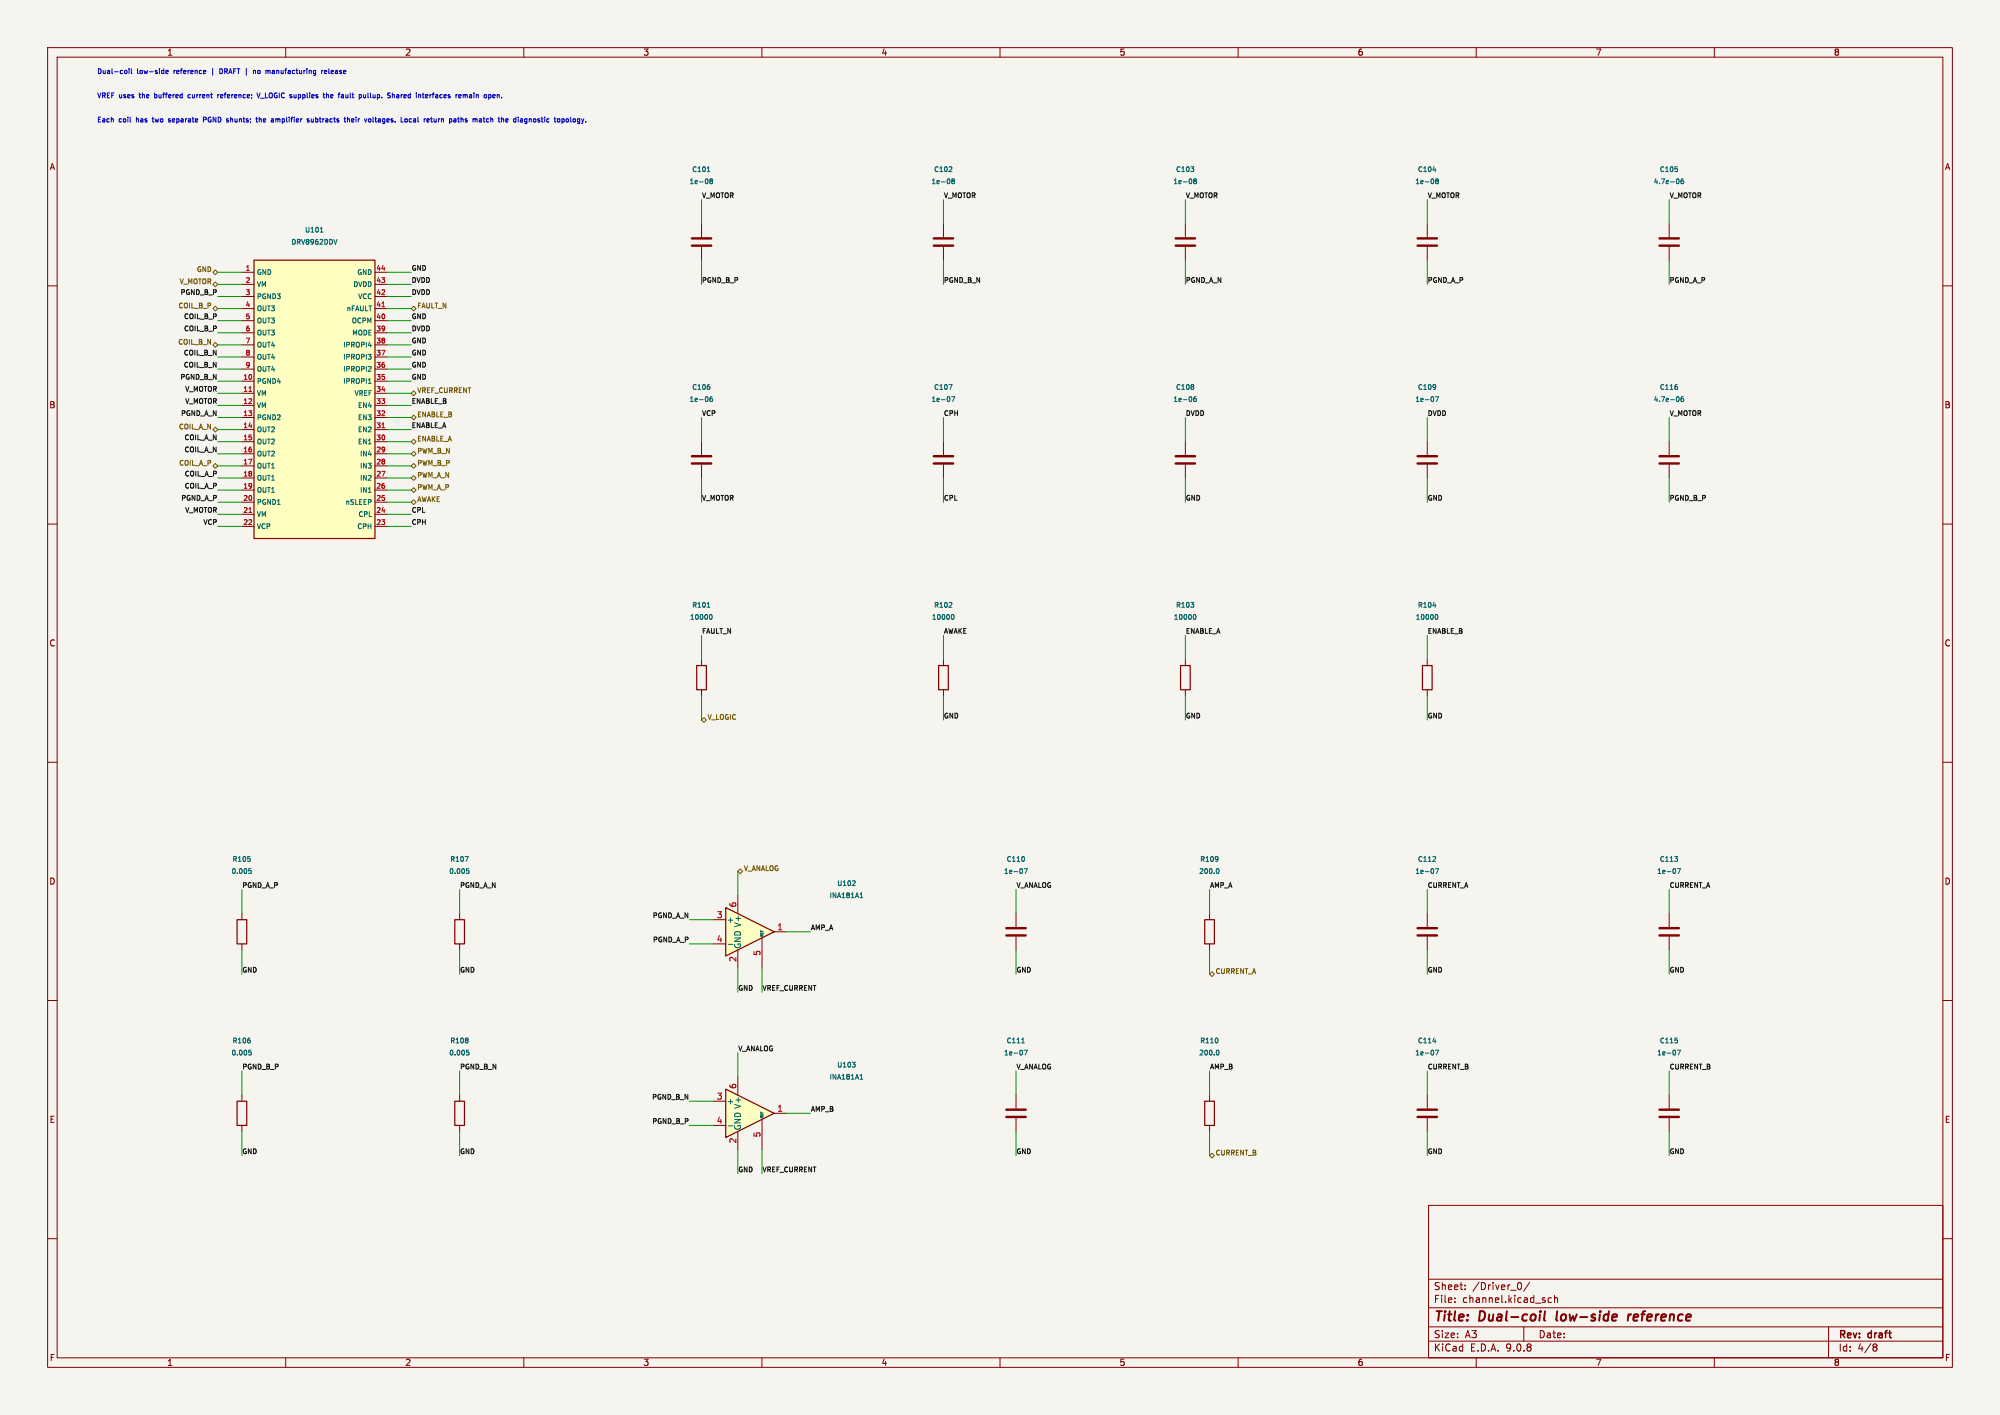
[picture p33: page 4]

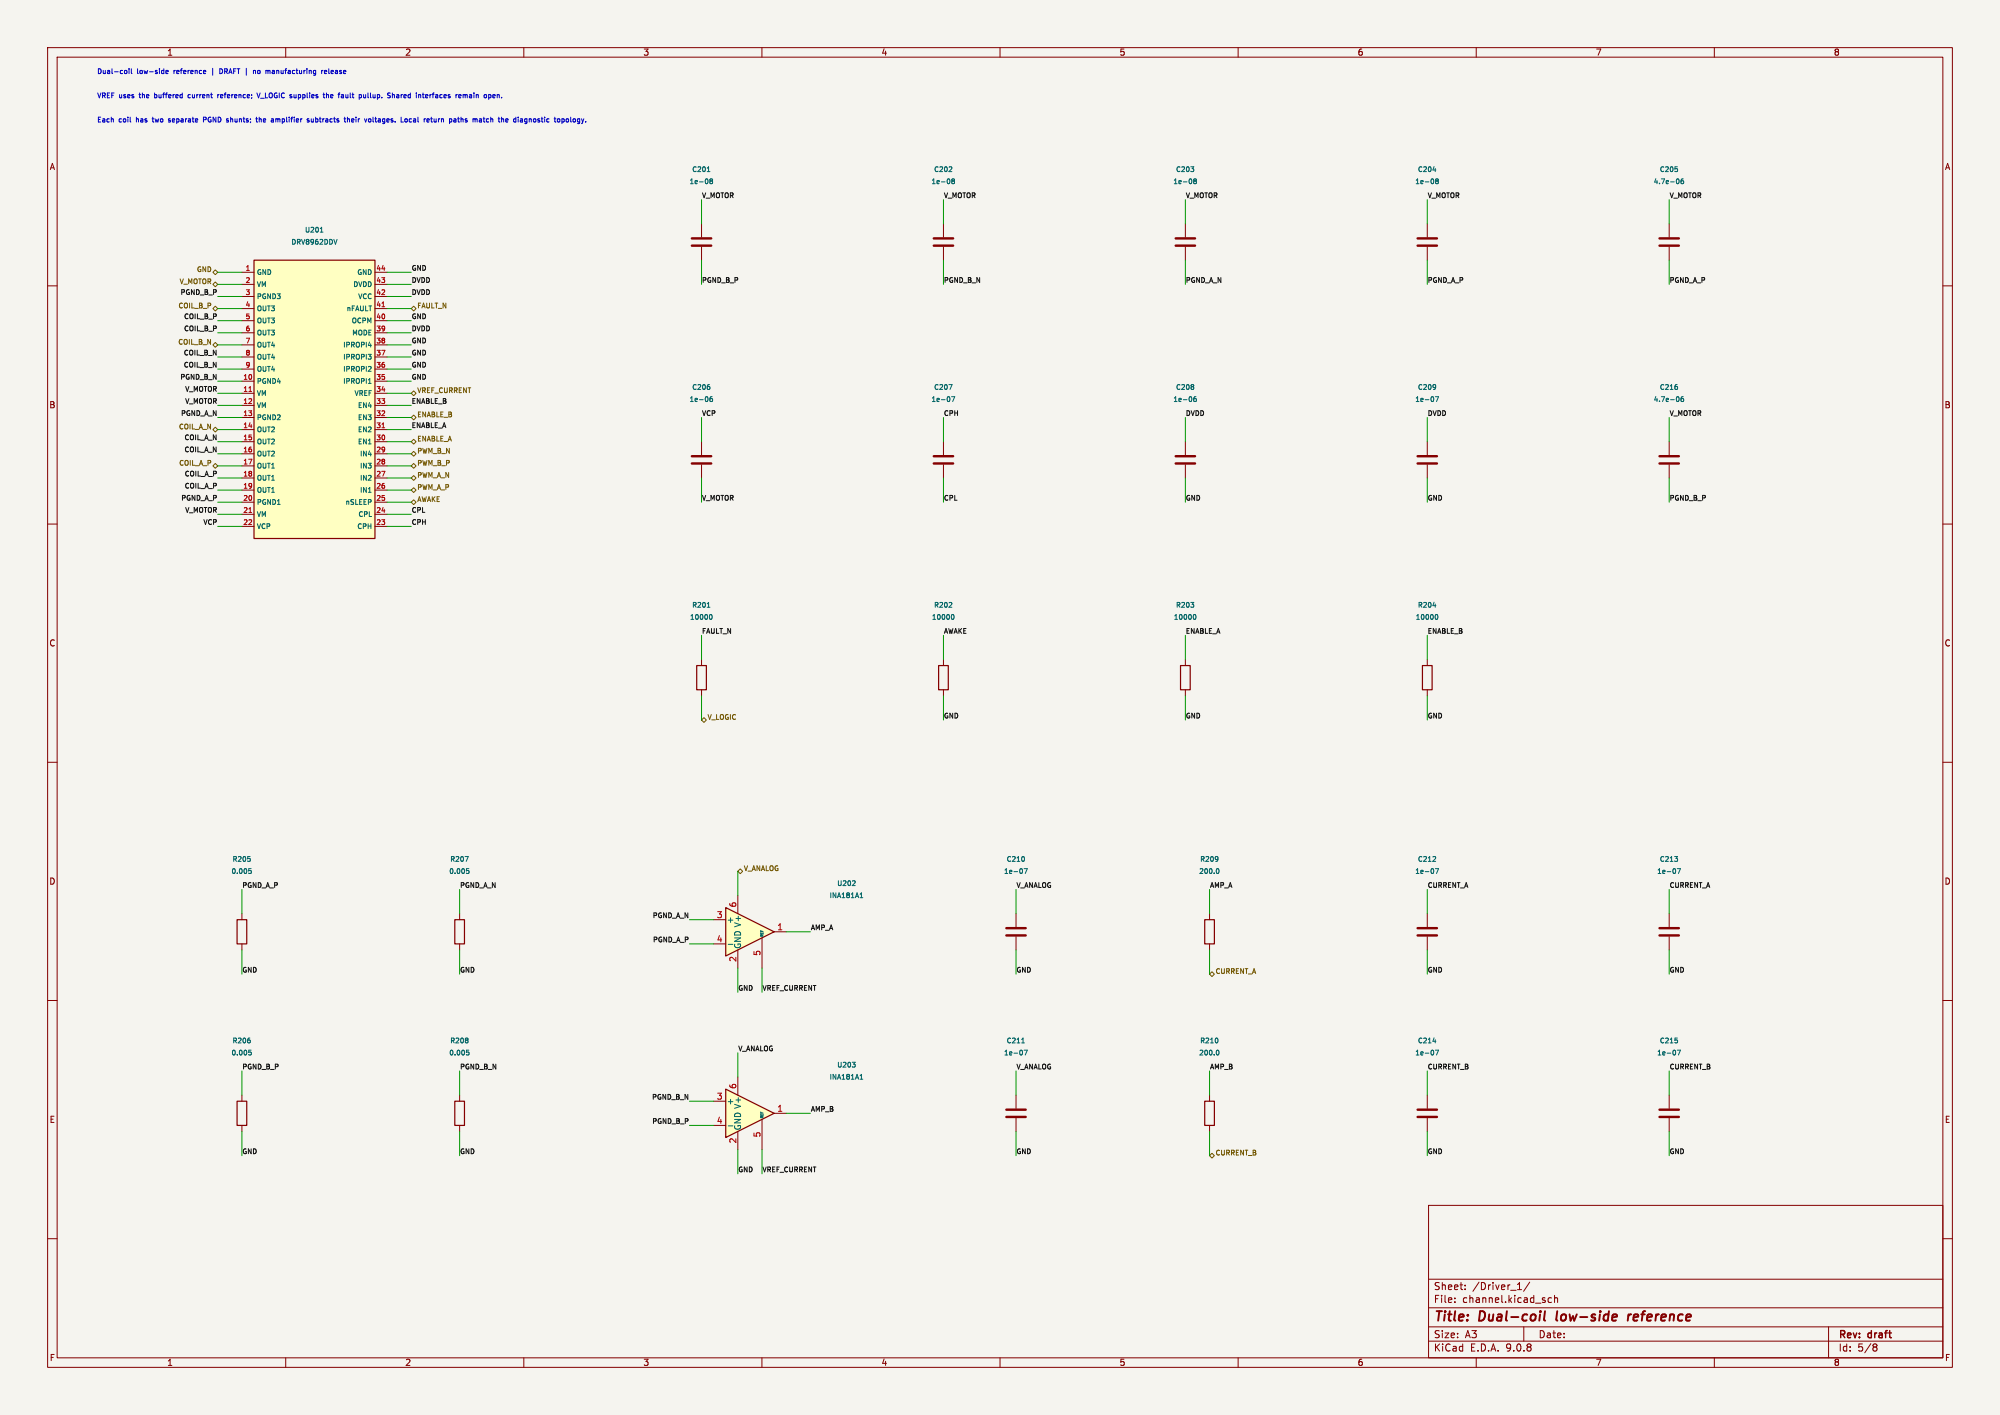
[picture p34: page 5]

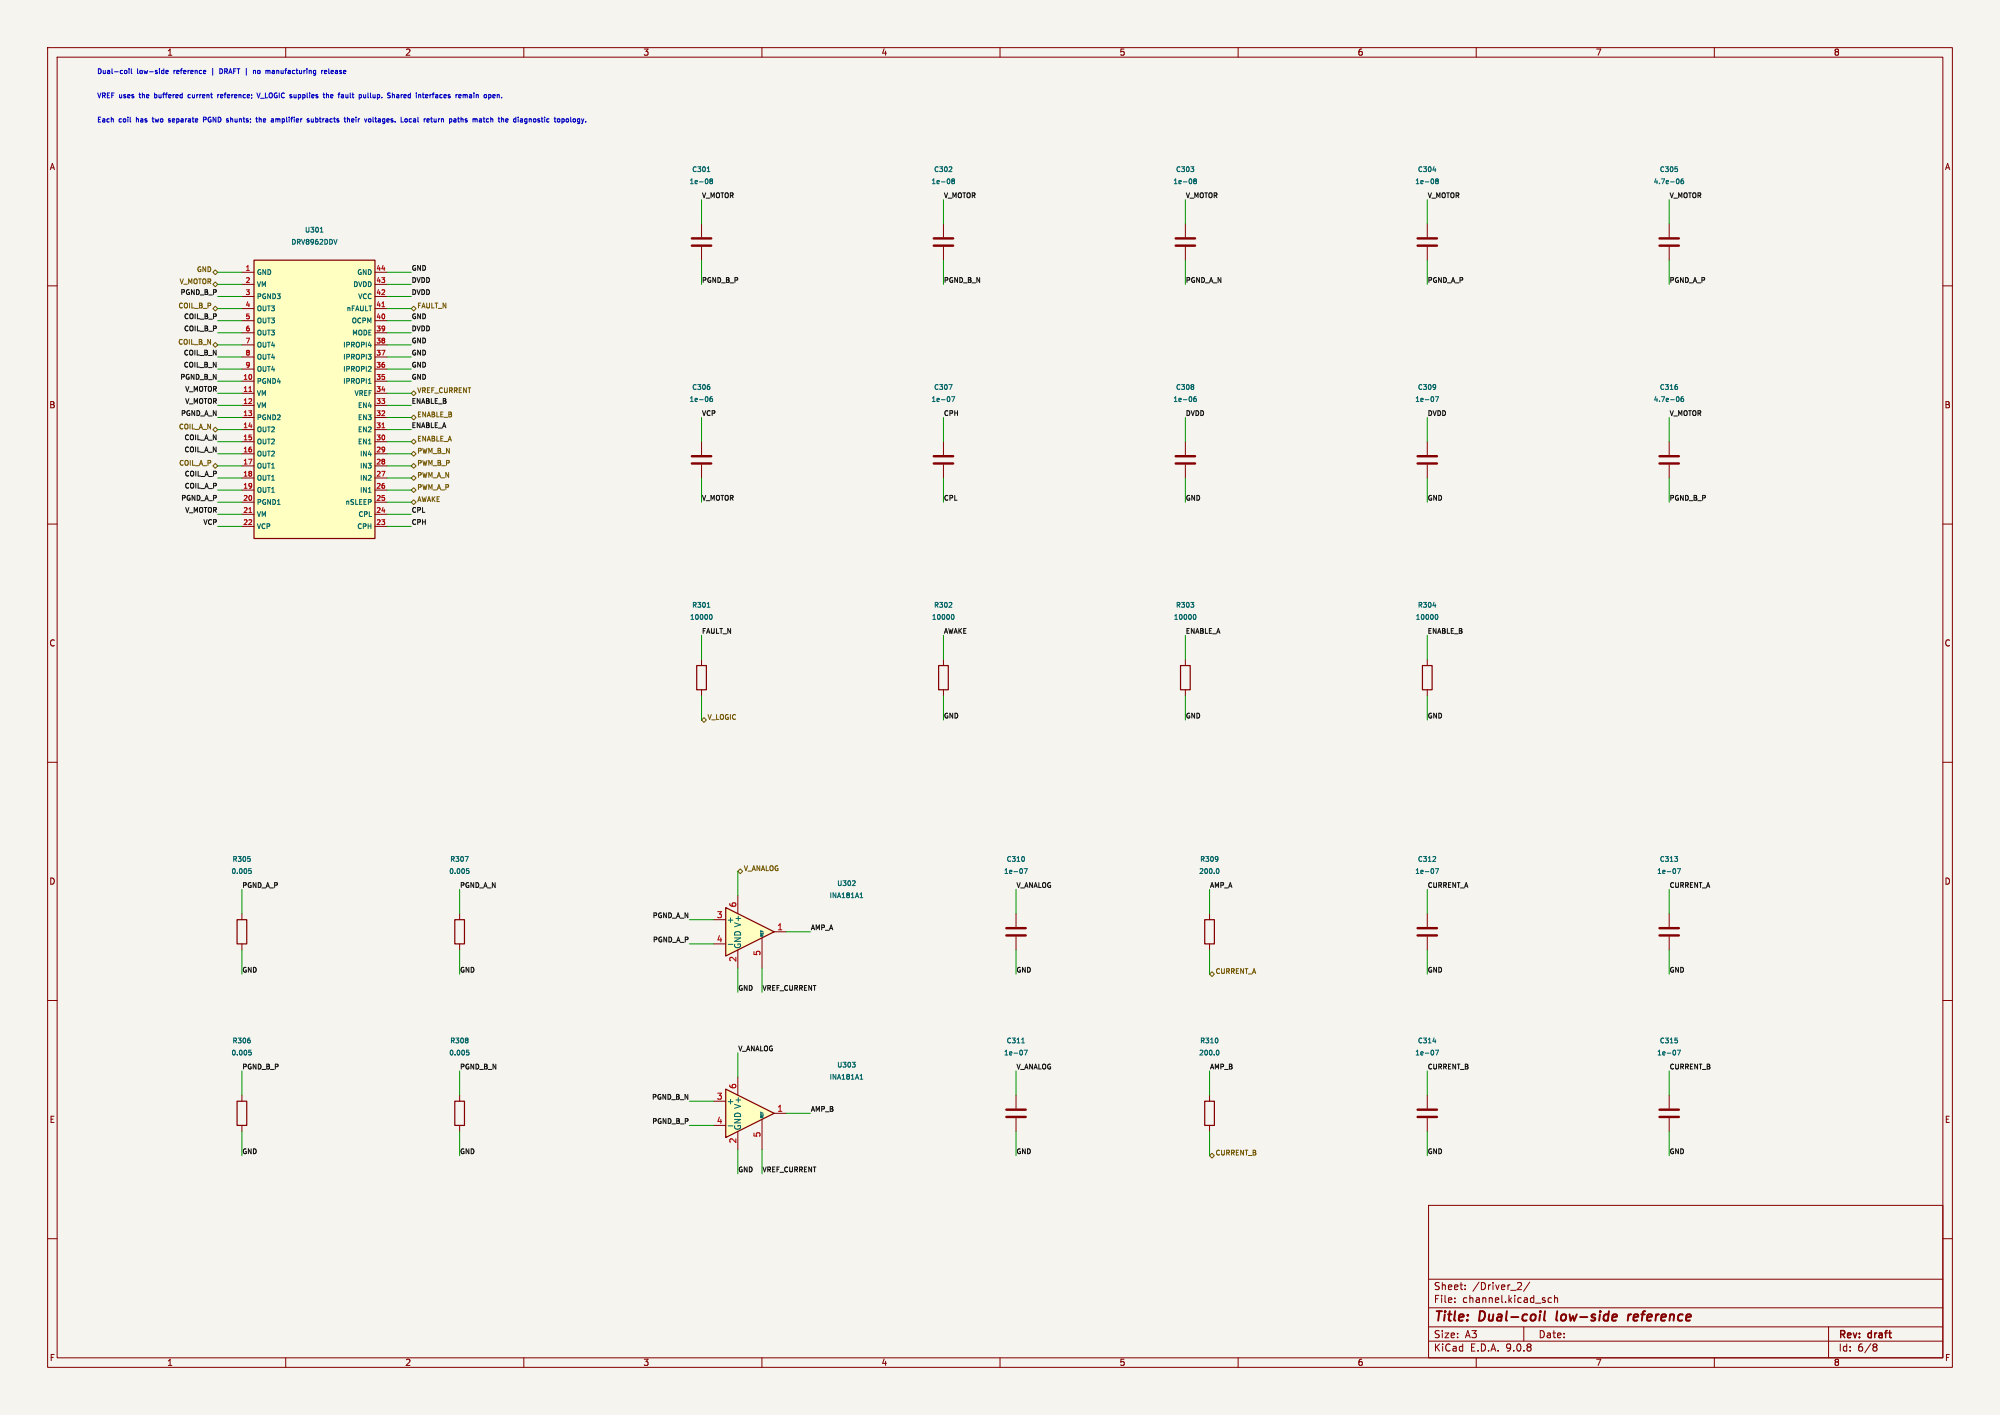
[picture p35: page 6]

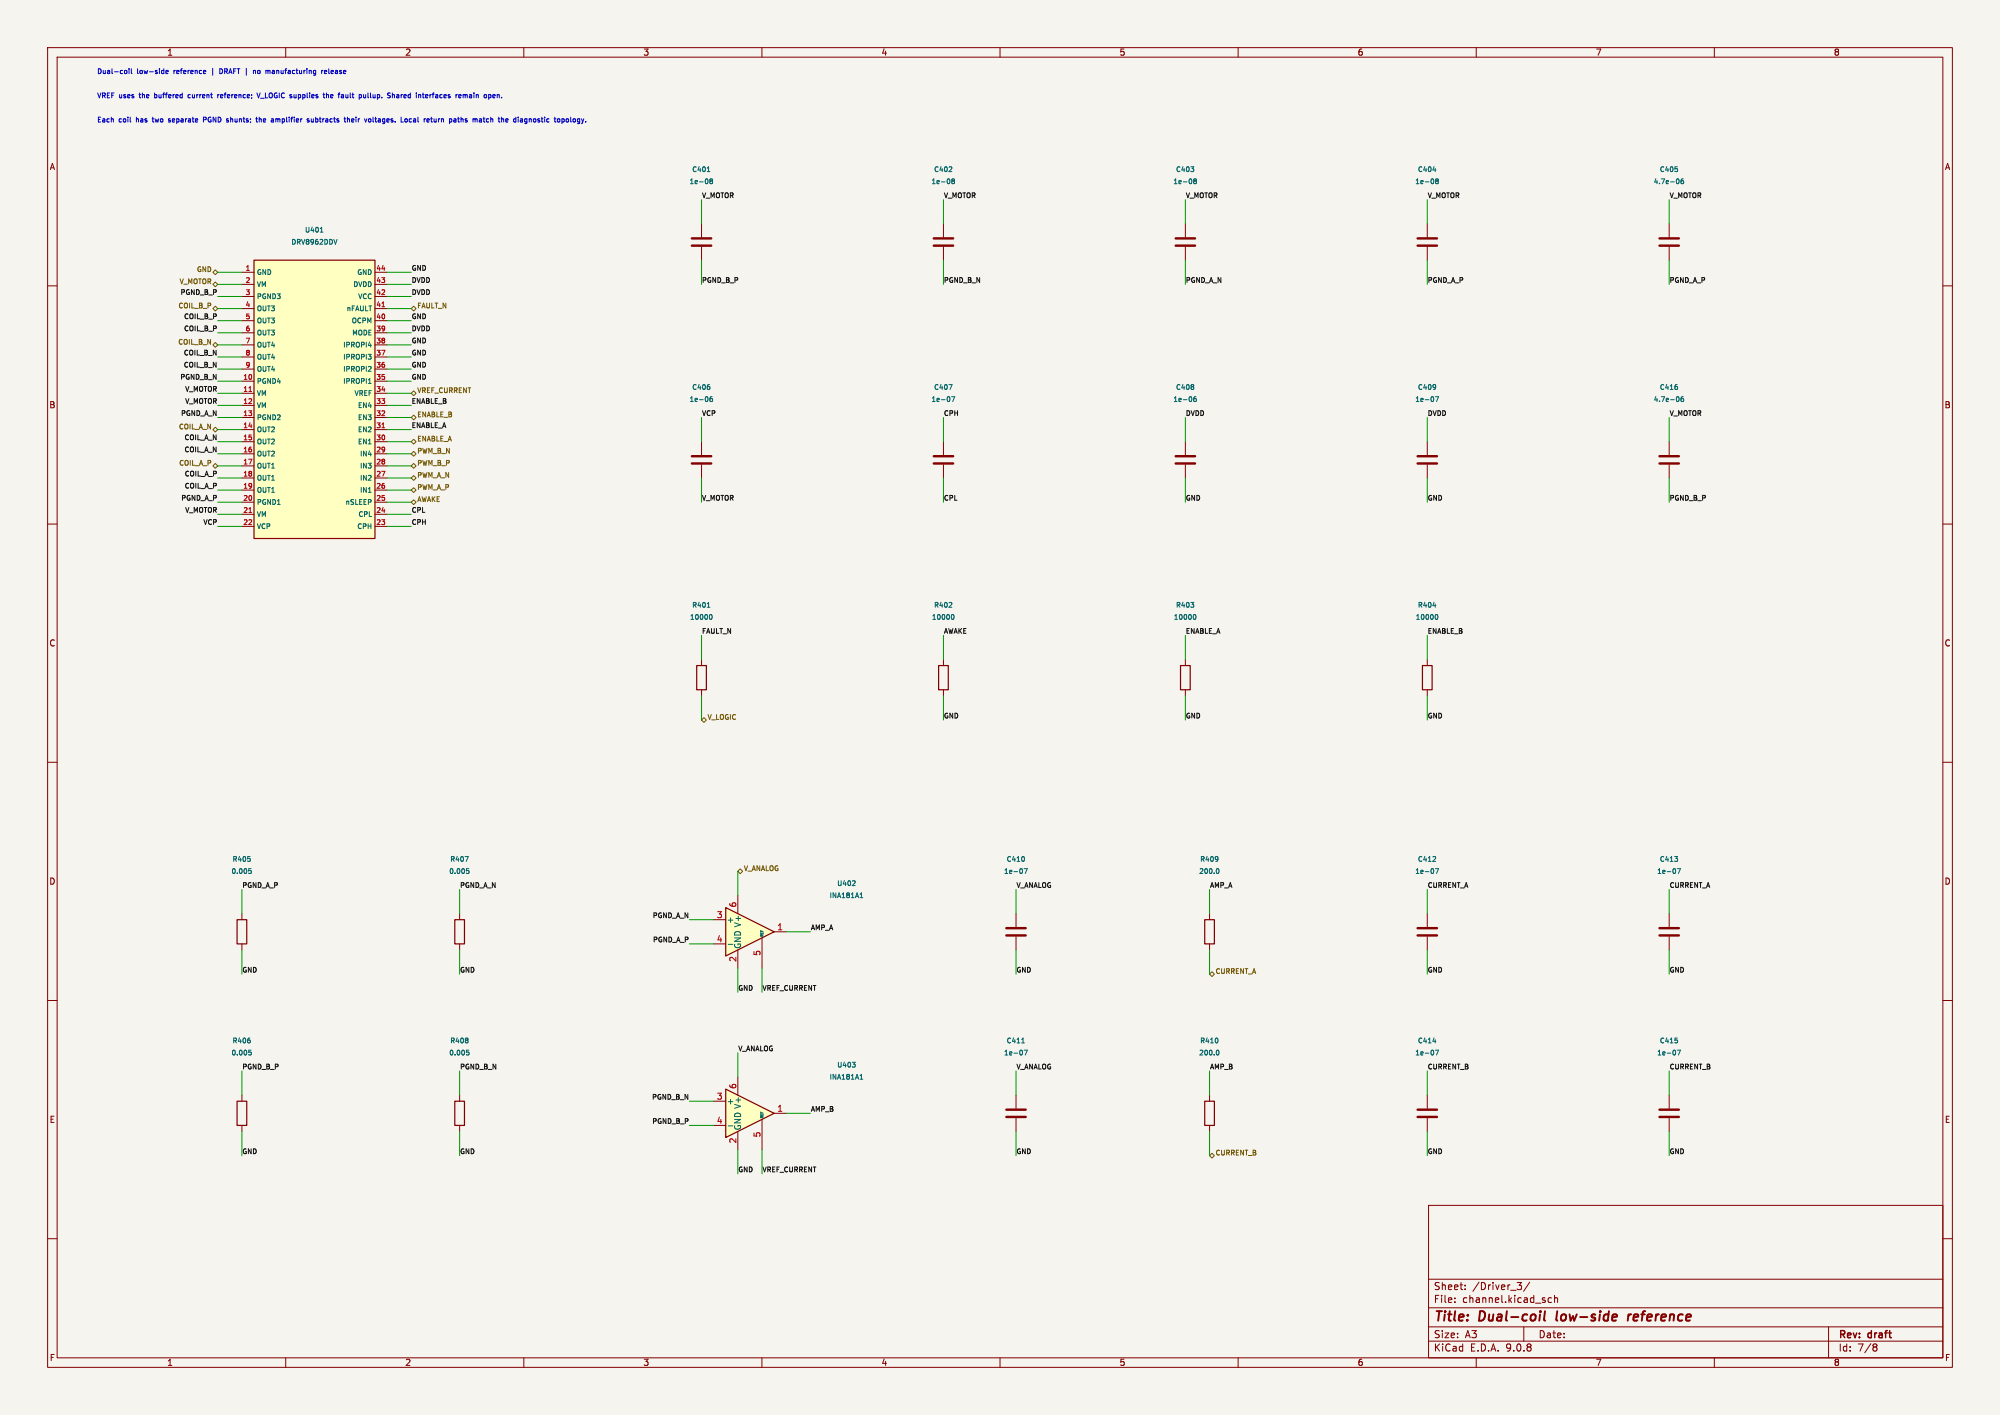
[picture p36: page 7]

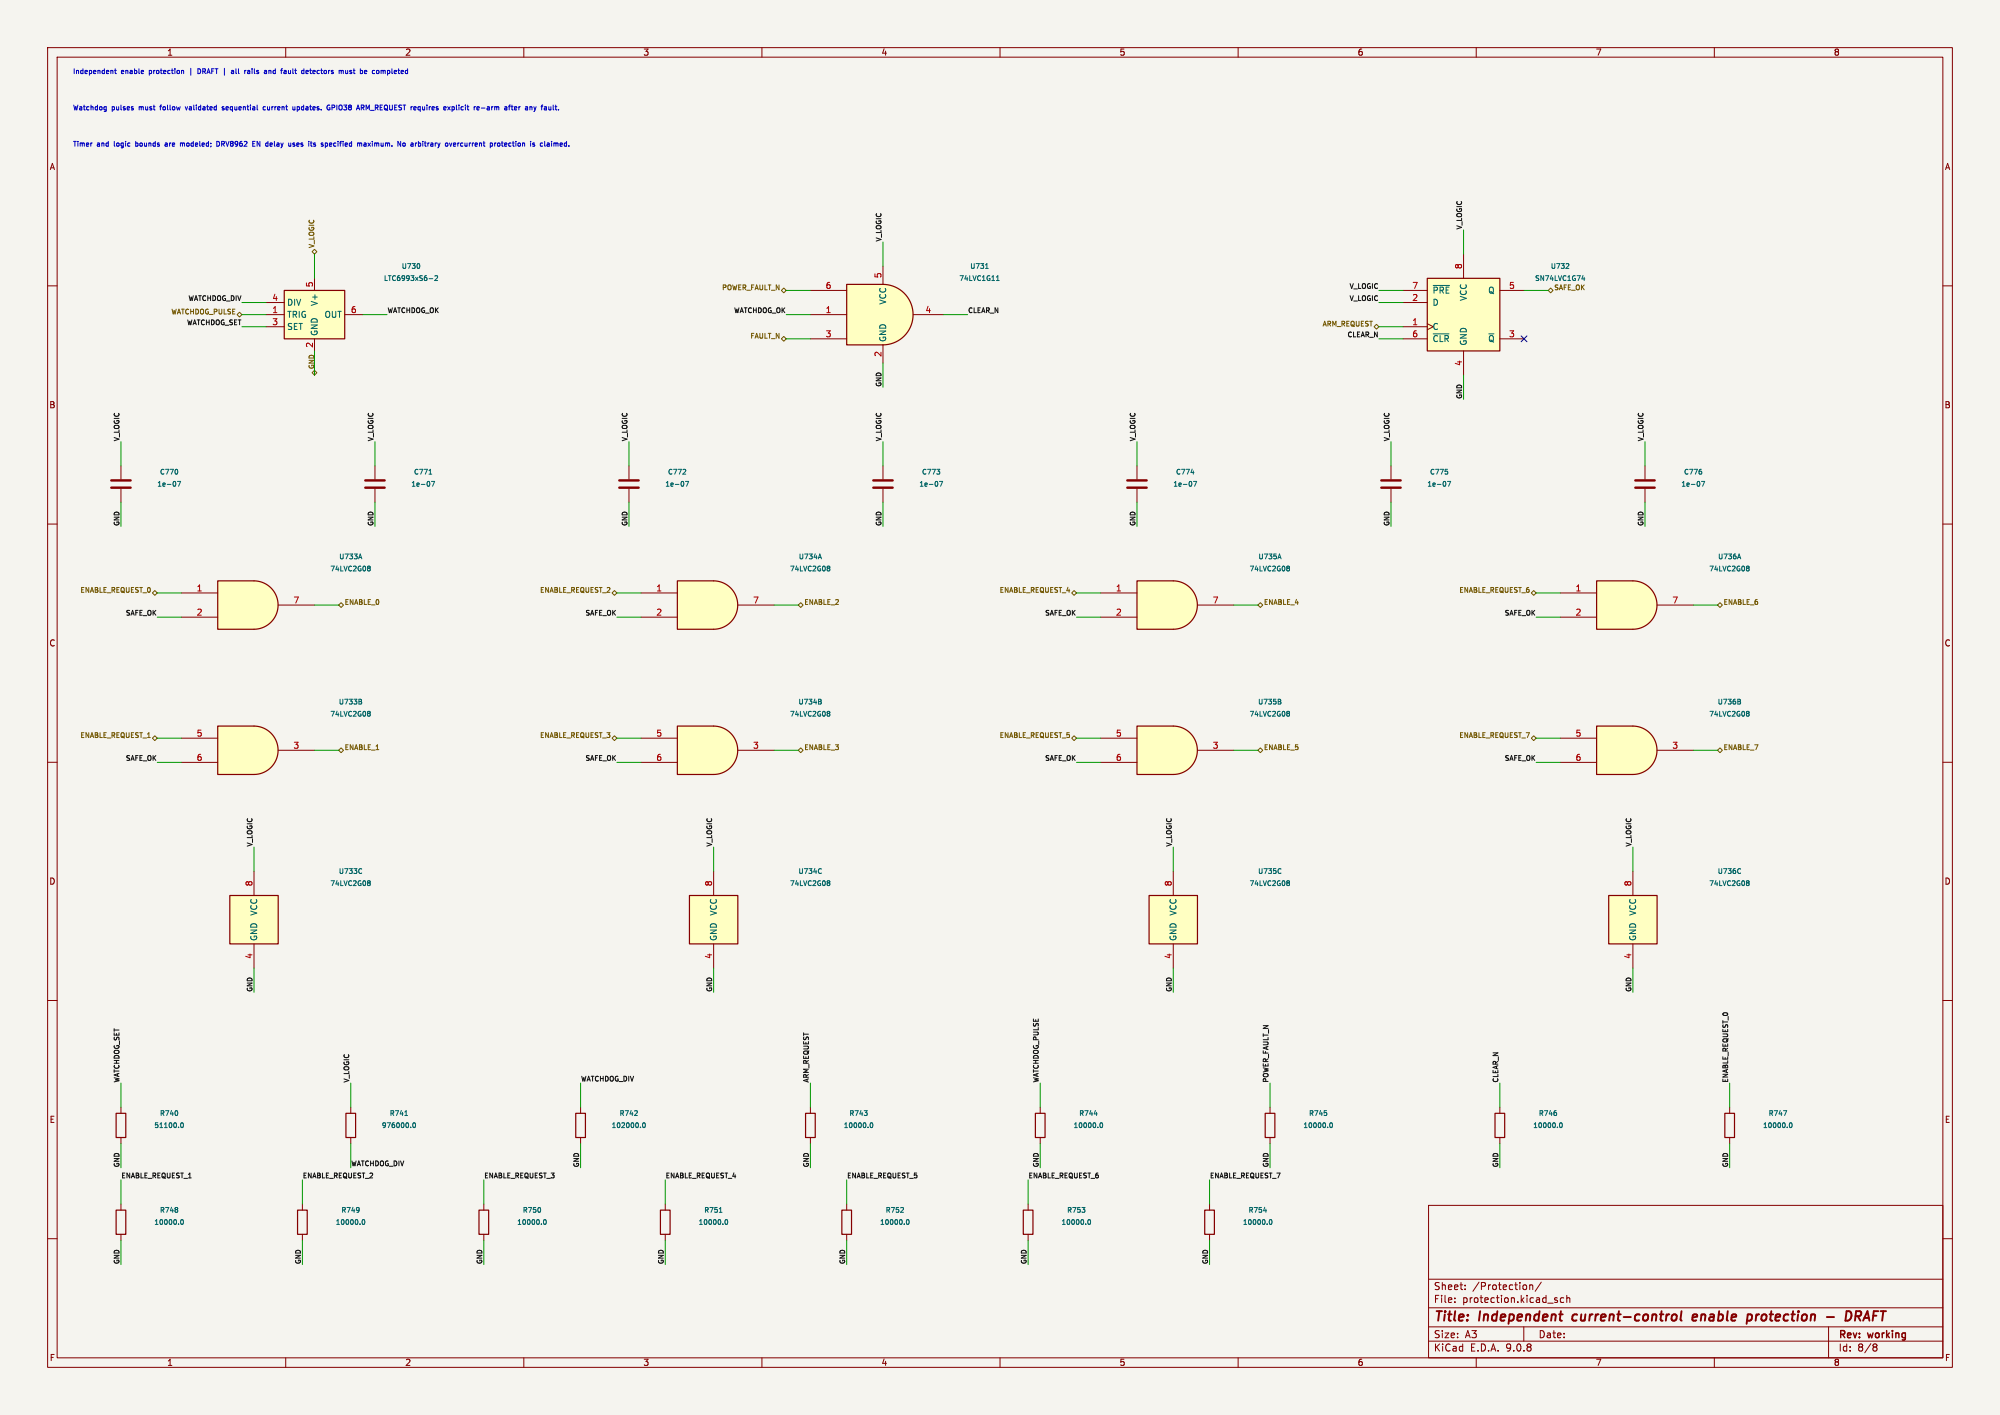
[picture p37: page 8]
