nikarus/levitating_chess/methodology/results/cad/electronics/low_side_channel/channel.pdf

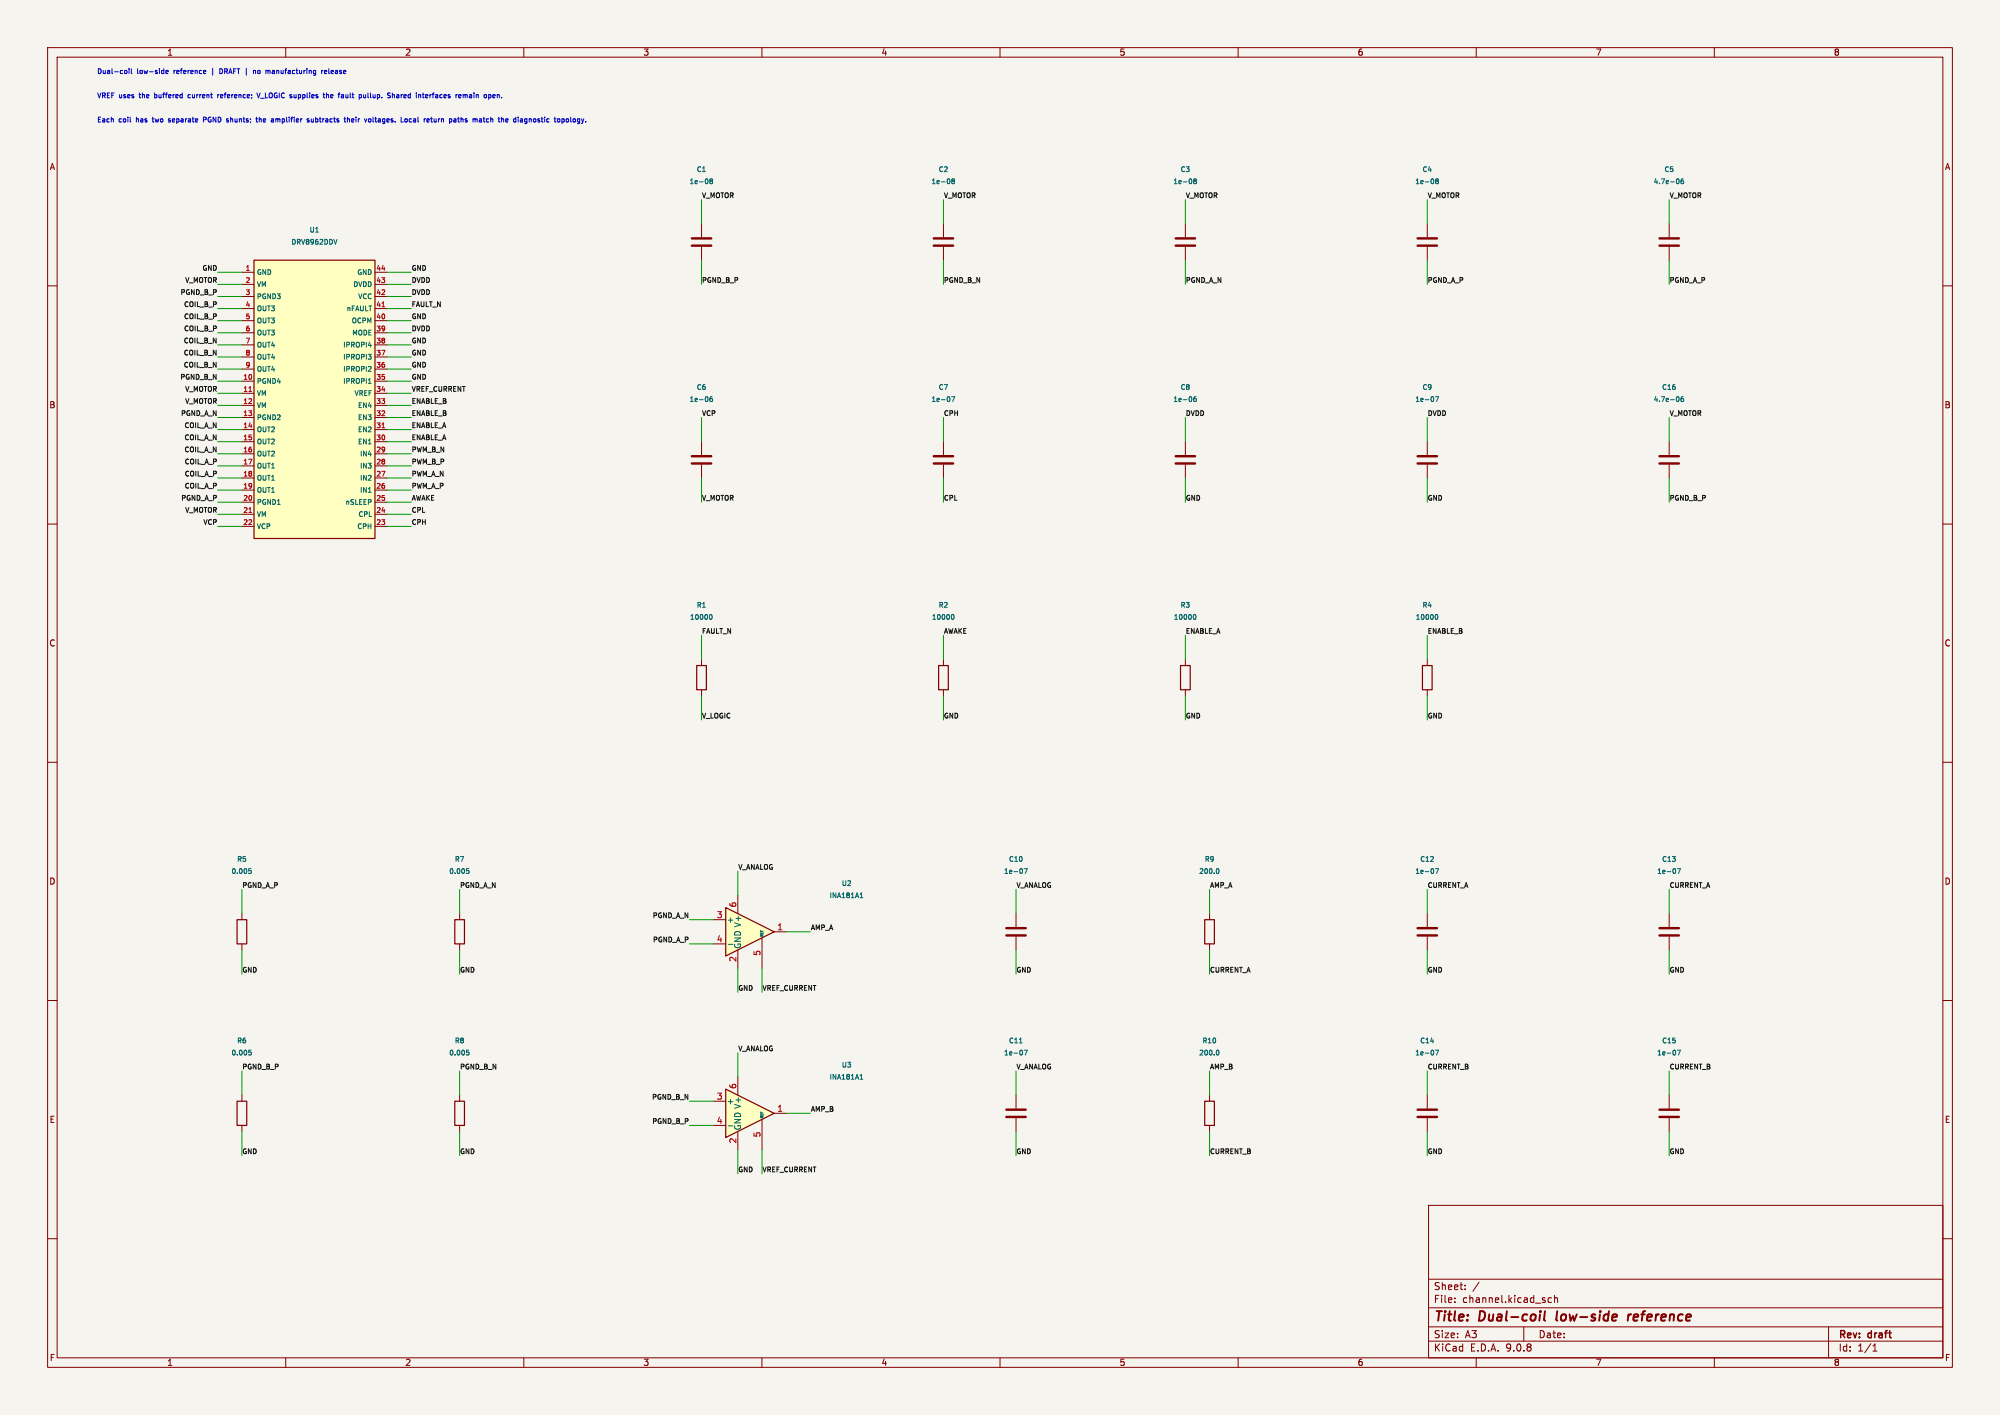
[picture p38: page 1]

CPH GND GND GND
