nikarus/levitating_chess/methodology/results/cad/electronics/shared_acquisition/acquisition.pdf

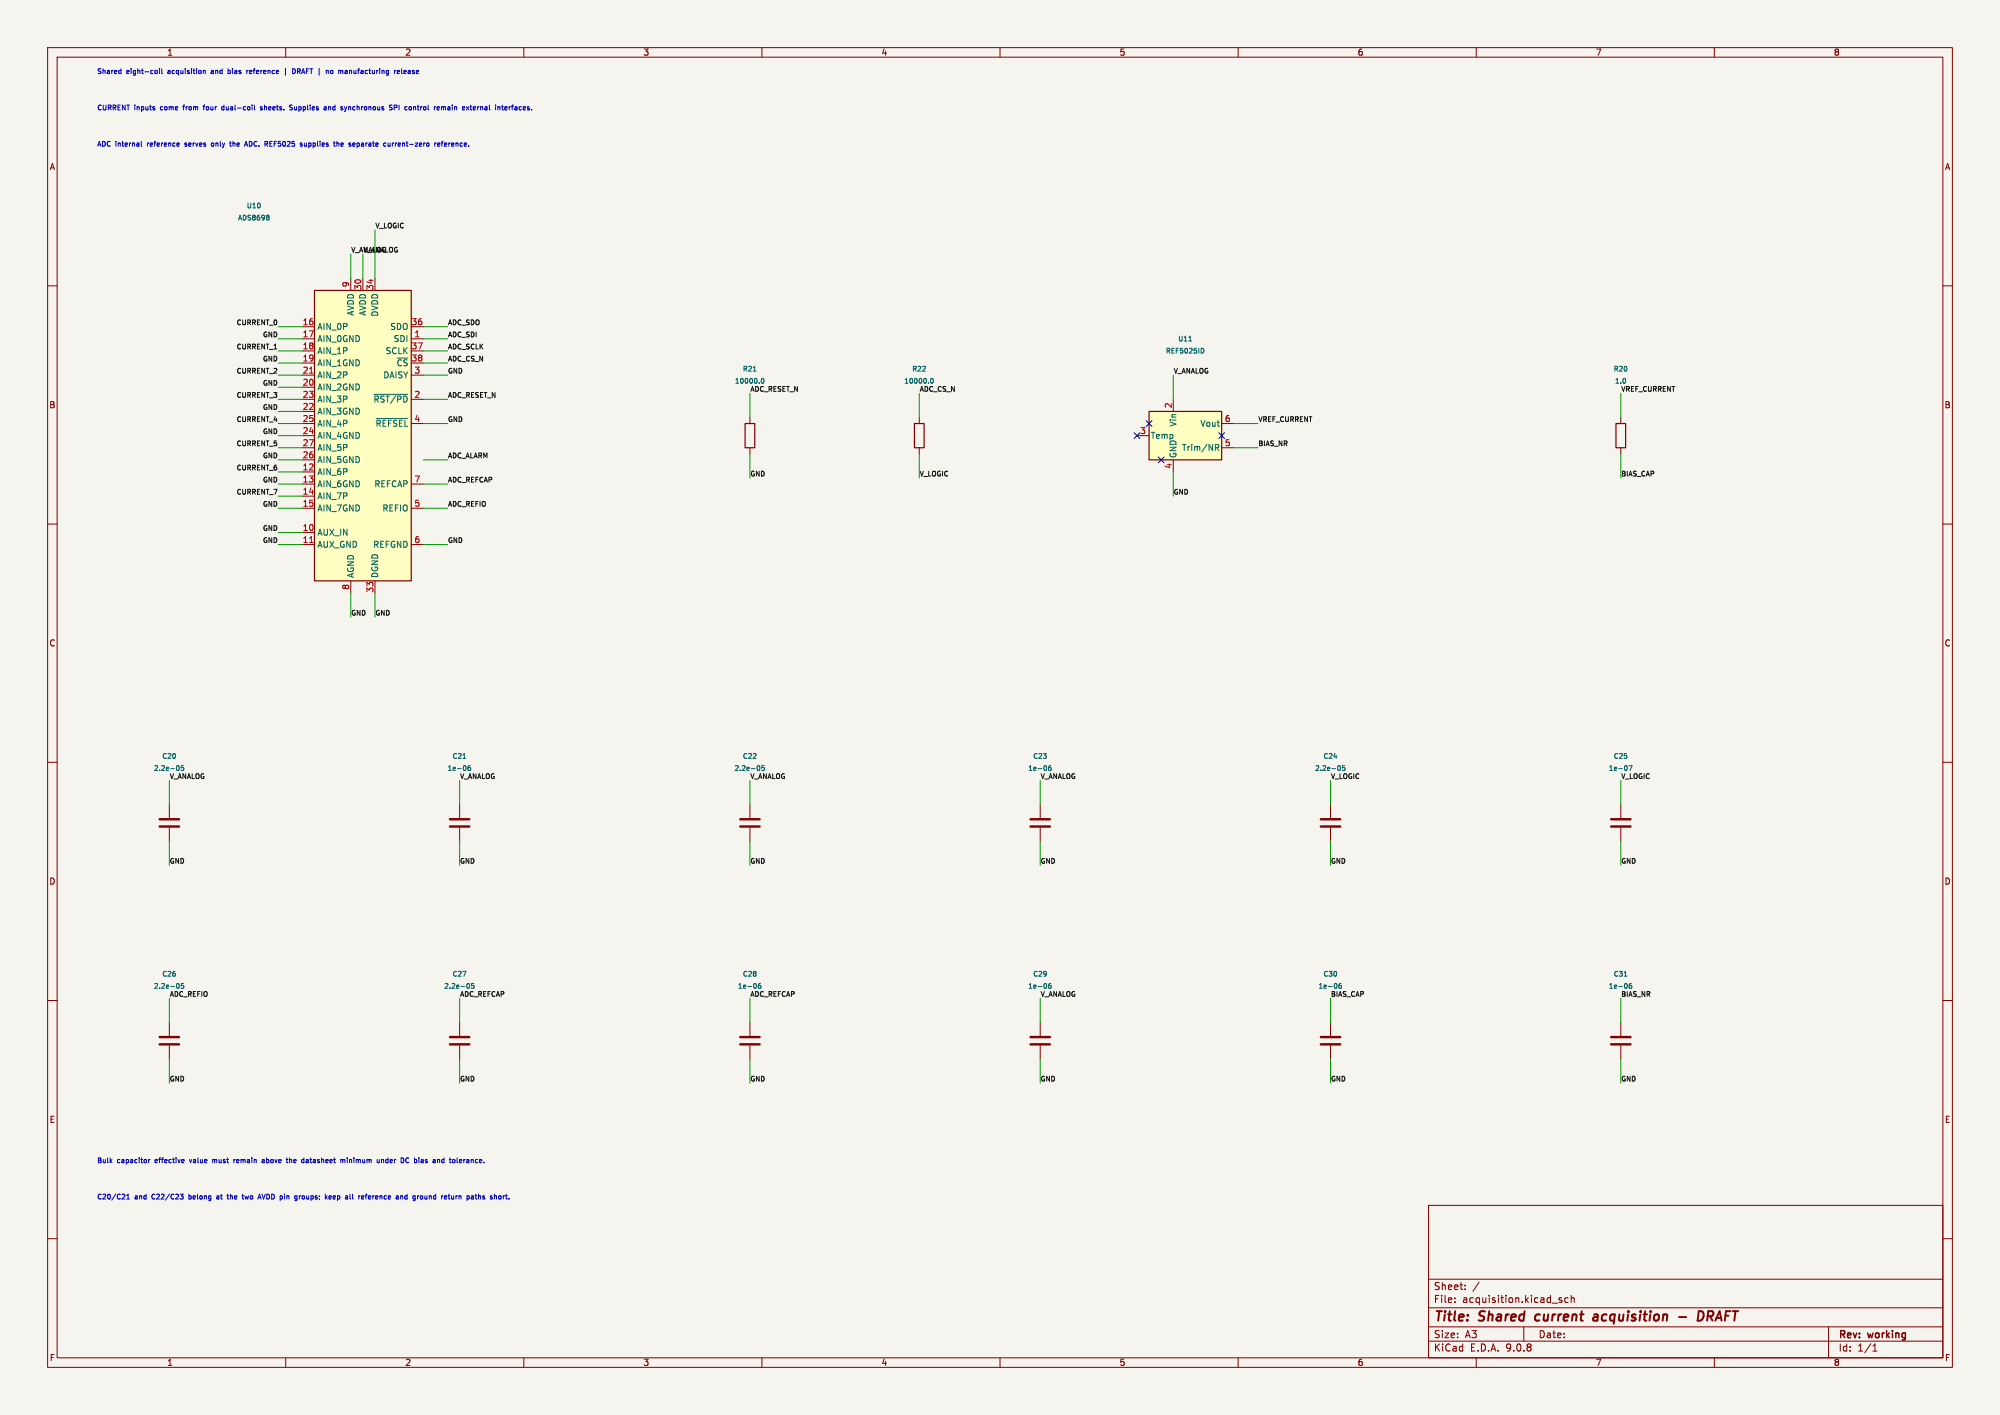
[picture p39: page 1]

8 AVDD 30 DVDD 34 DGND 33 SDO 36 SDI 1 SCLK 37 ~{CS} 38 DAISY 3 ~{RST/PD}2 ~{REFSEL}4 REFCAP 7 REFIO 5 REFGND 6 U10 ADS8698 Temp 3 Vin

GND GND GND

File: acquisition.kicad_sch Sheet: /
Id: 1/1 Title: Shared current acquisition - DRAFT
