nikarus/levitating_chess/methodology/results/electronics/channel_review/channel.pdf

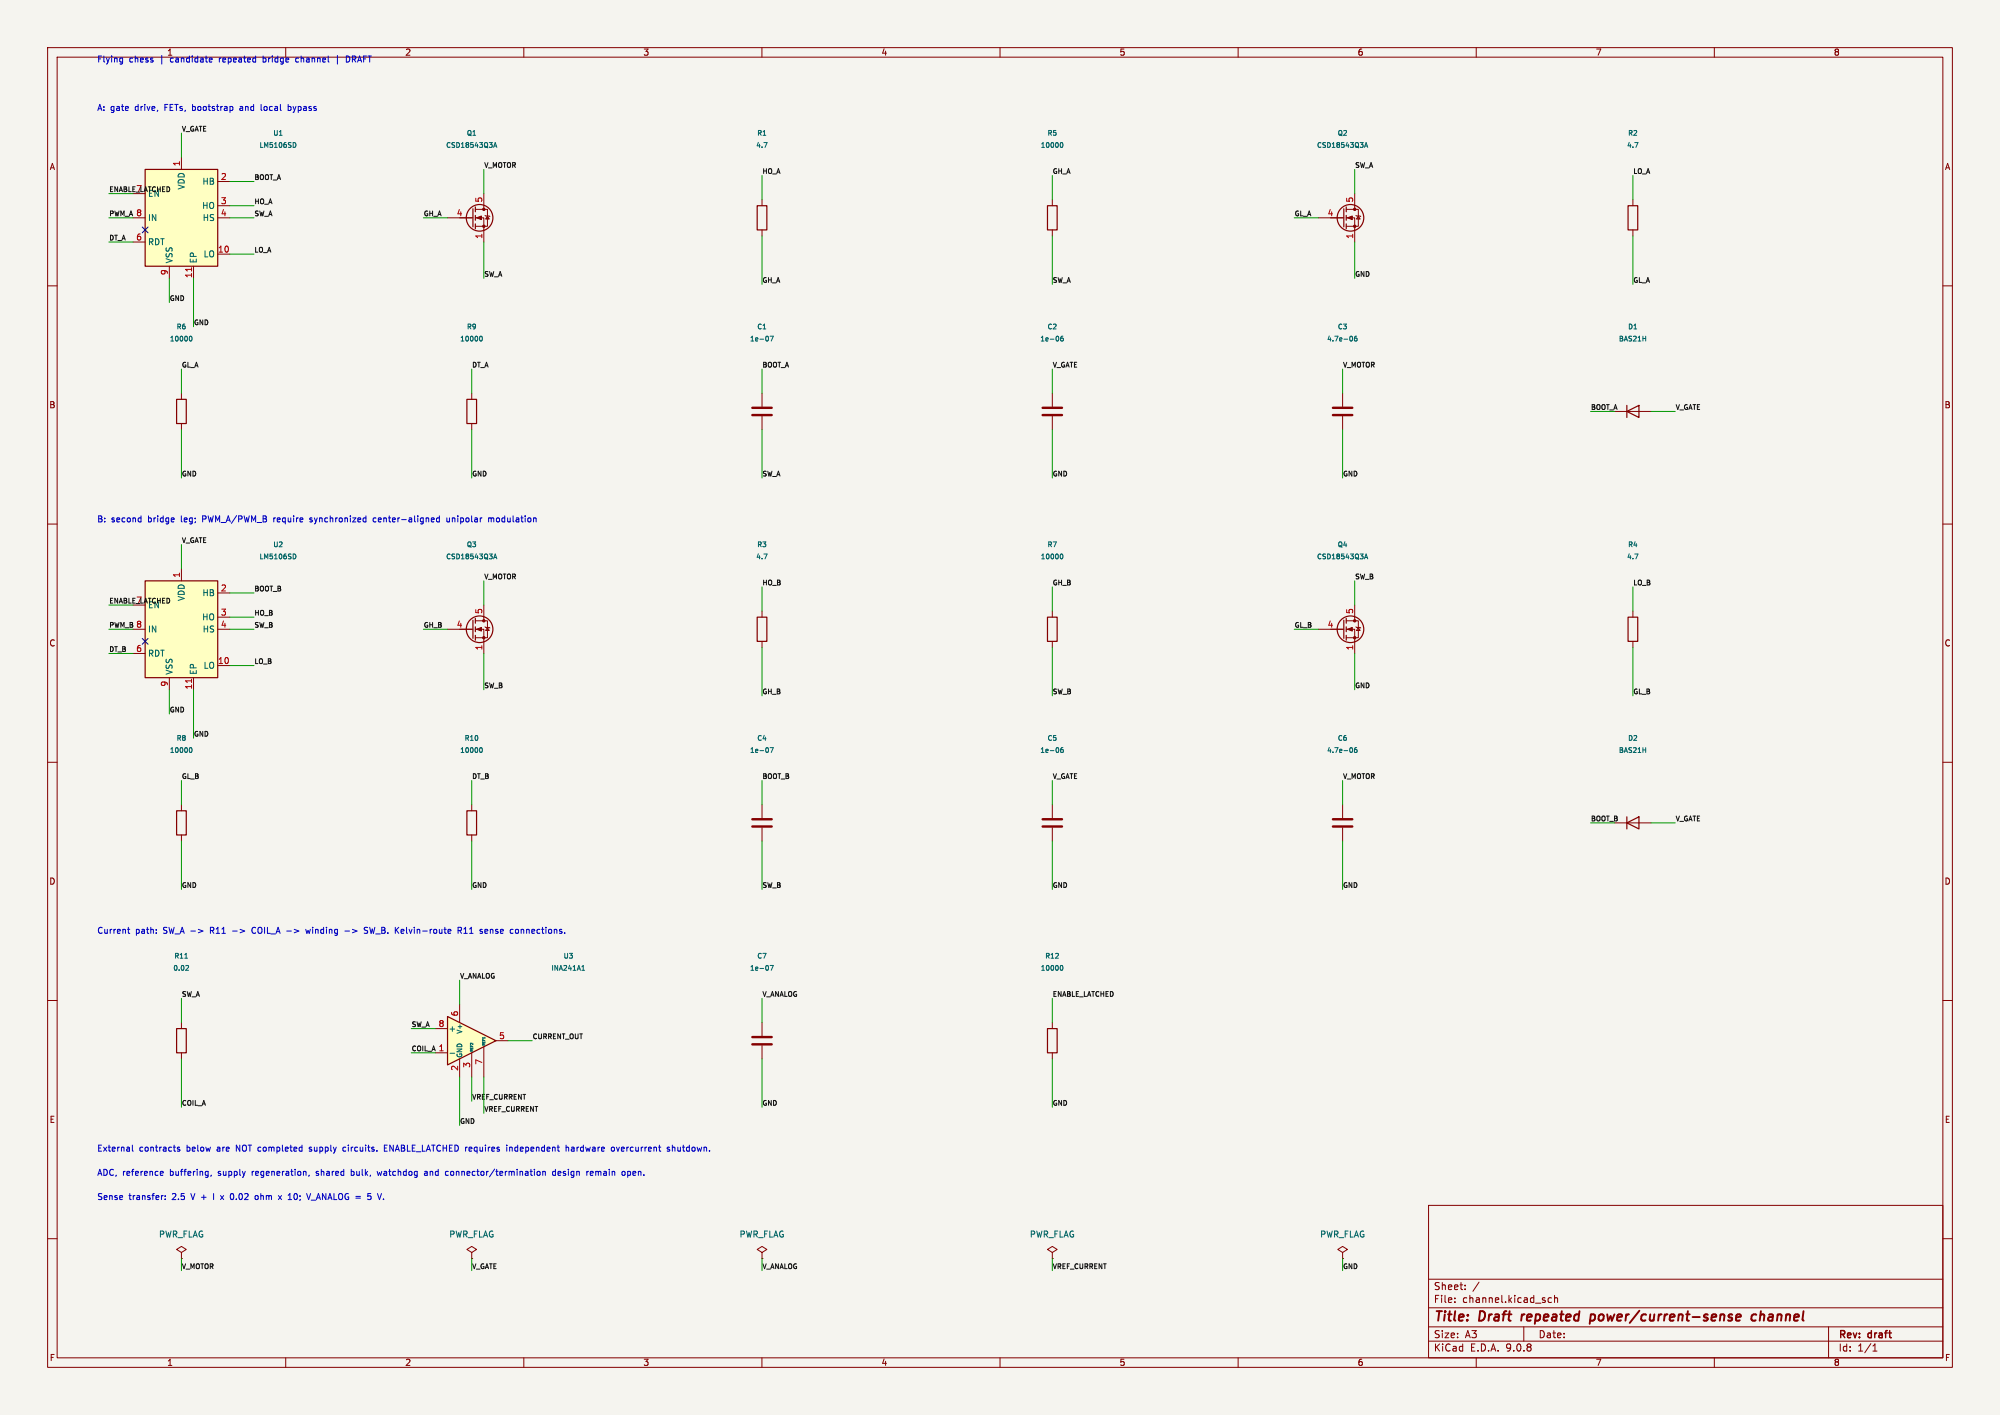
[picture p40: page 1]
