nikarus/levitating_chess/methodology/results/cad/electronics/local_controller/controller.pdf

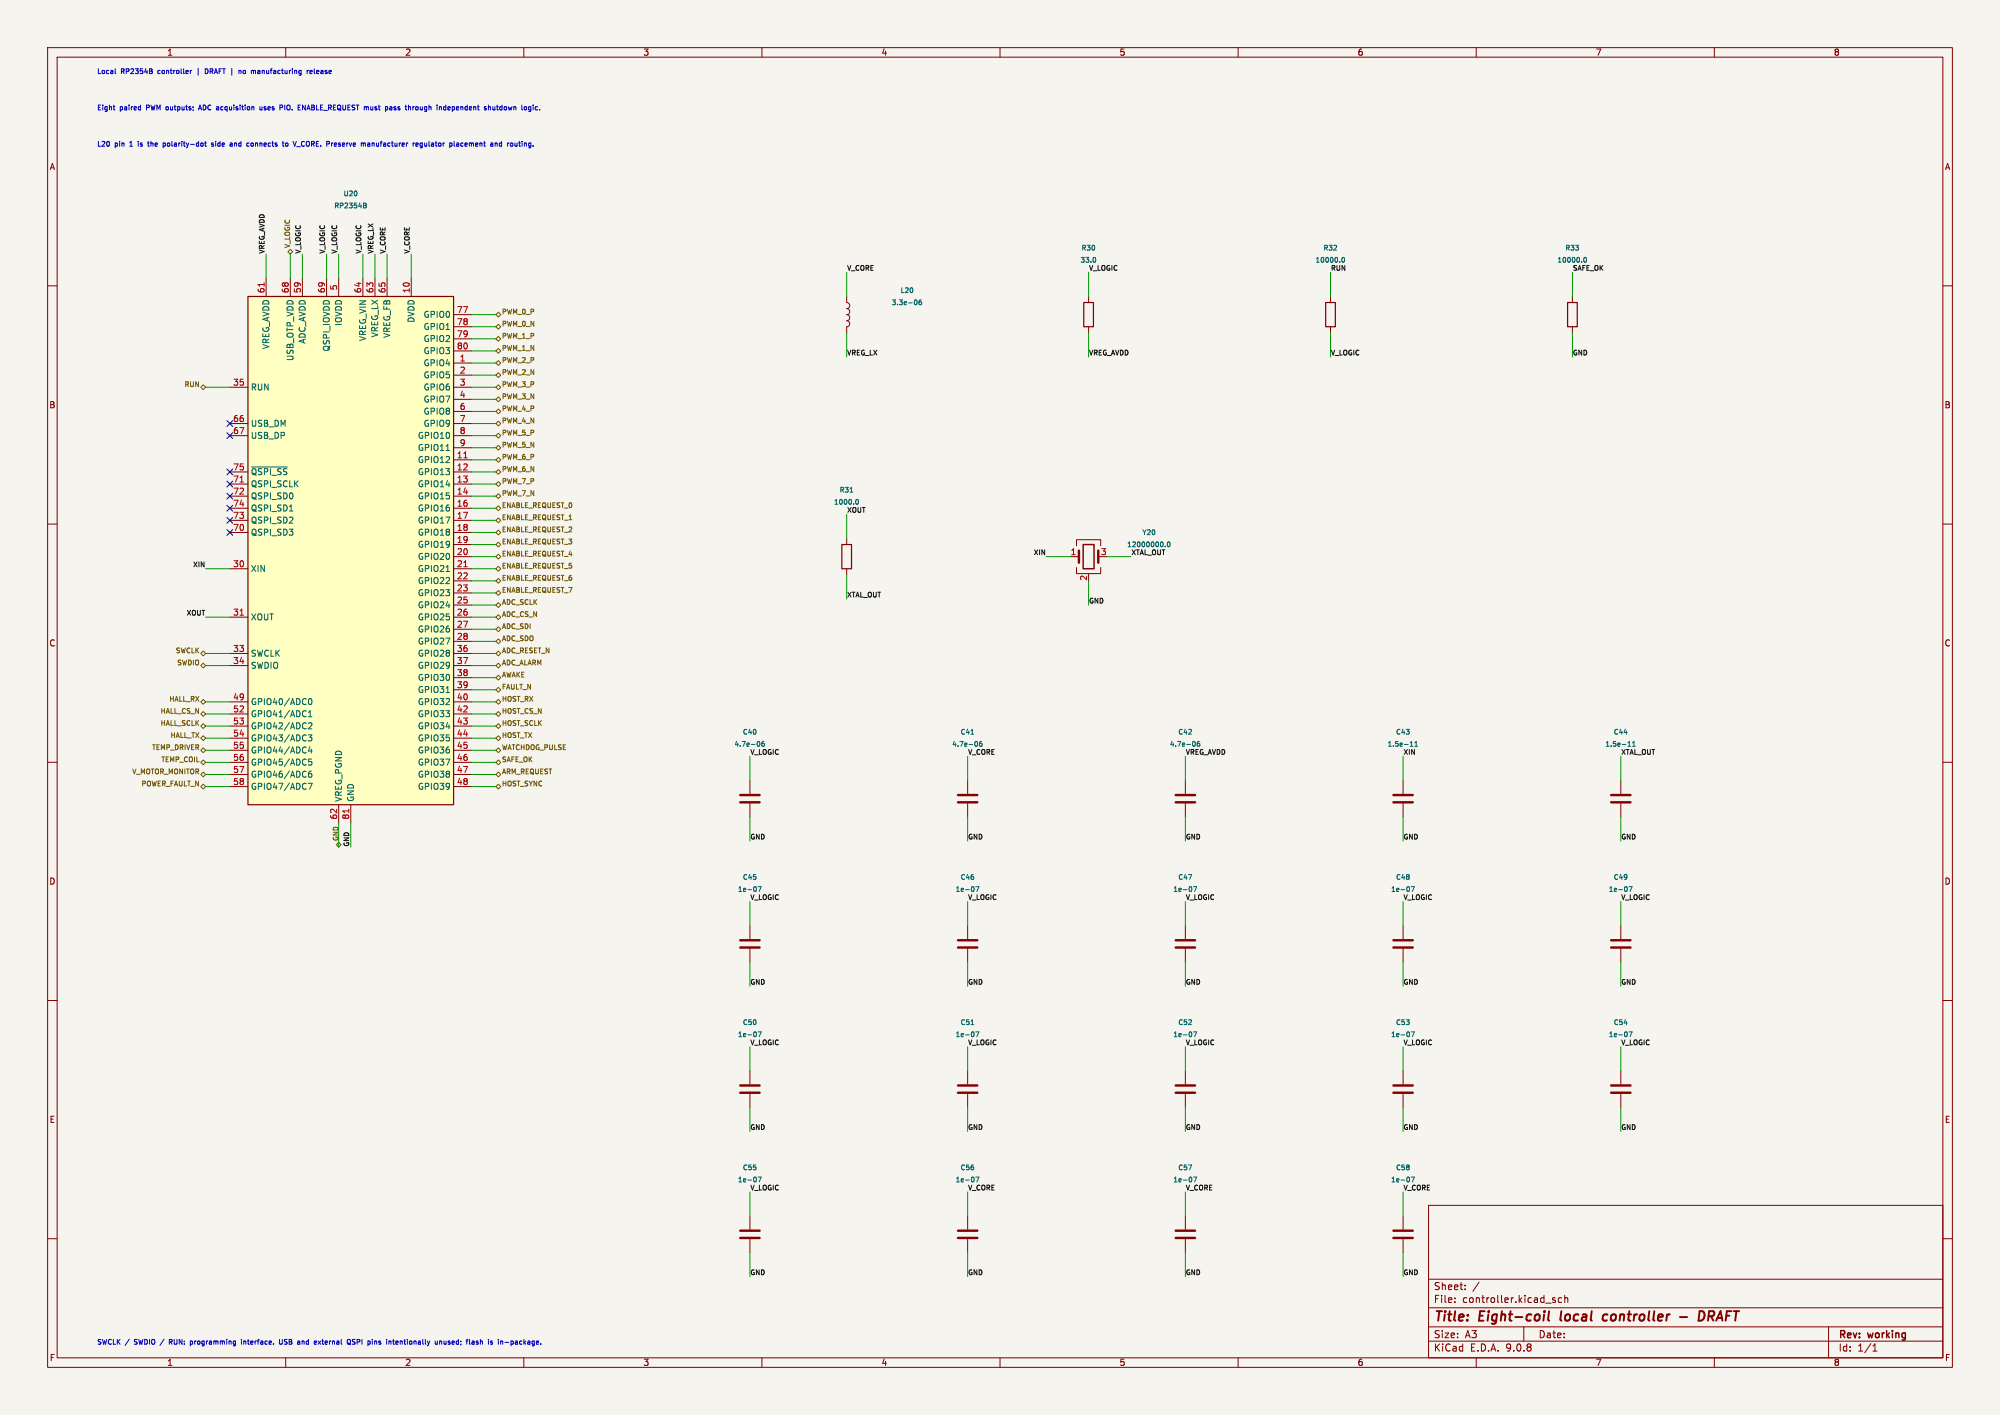
[picture p41: page 1]
