nikarus/levitating_chess/methodology/results/cad/electronics/protection/protection.pdf

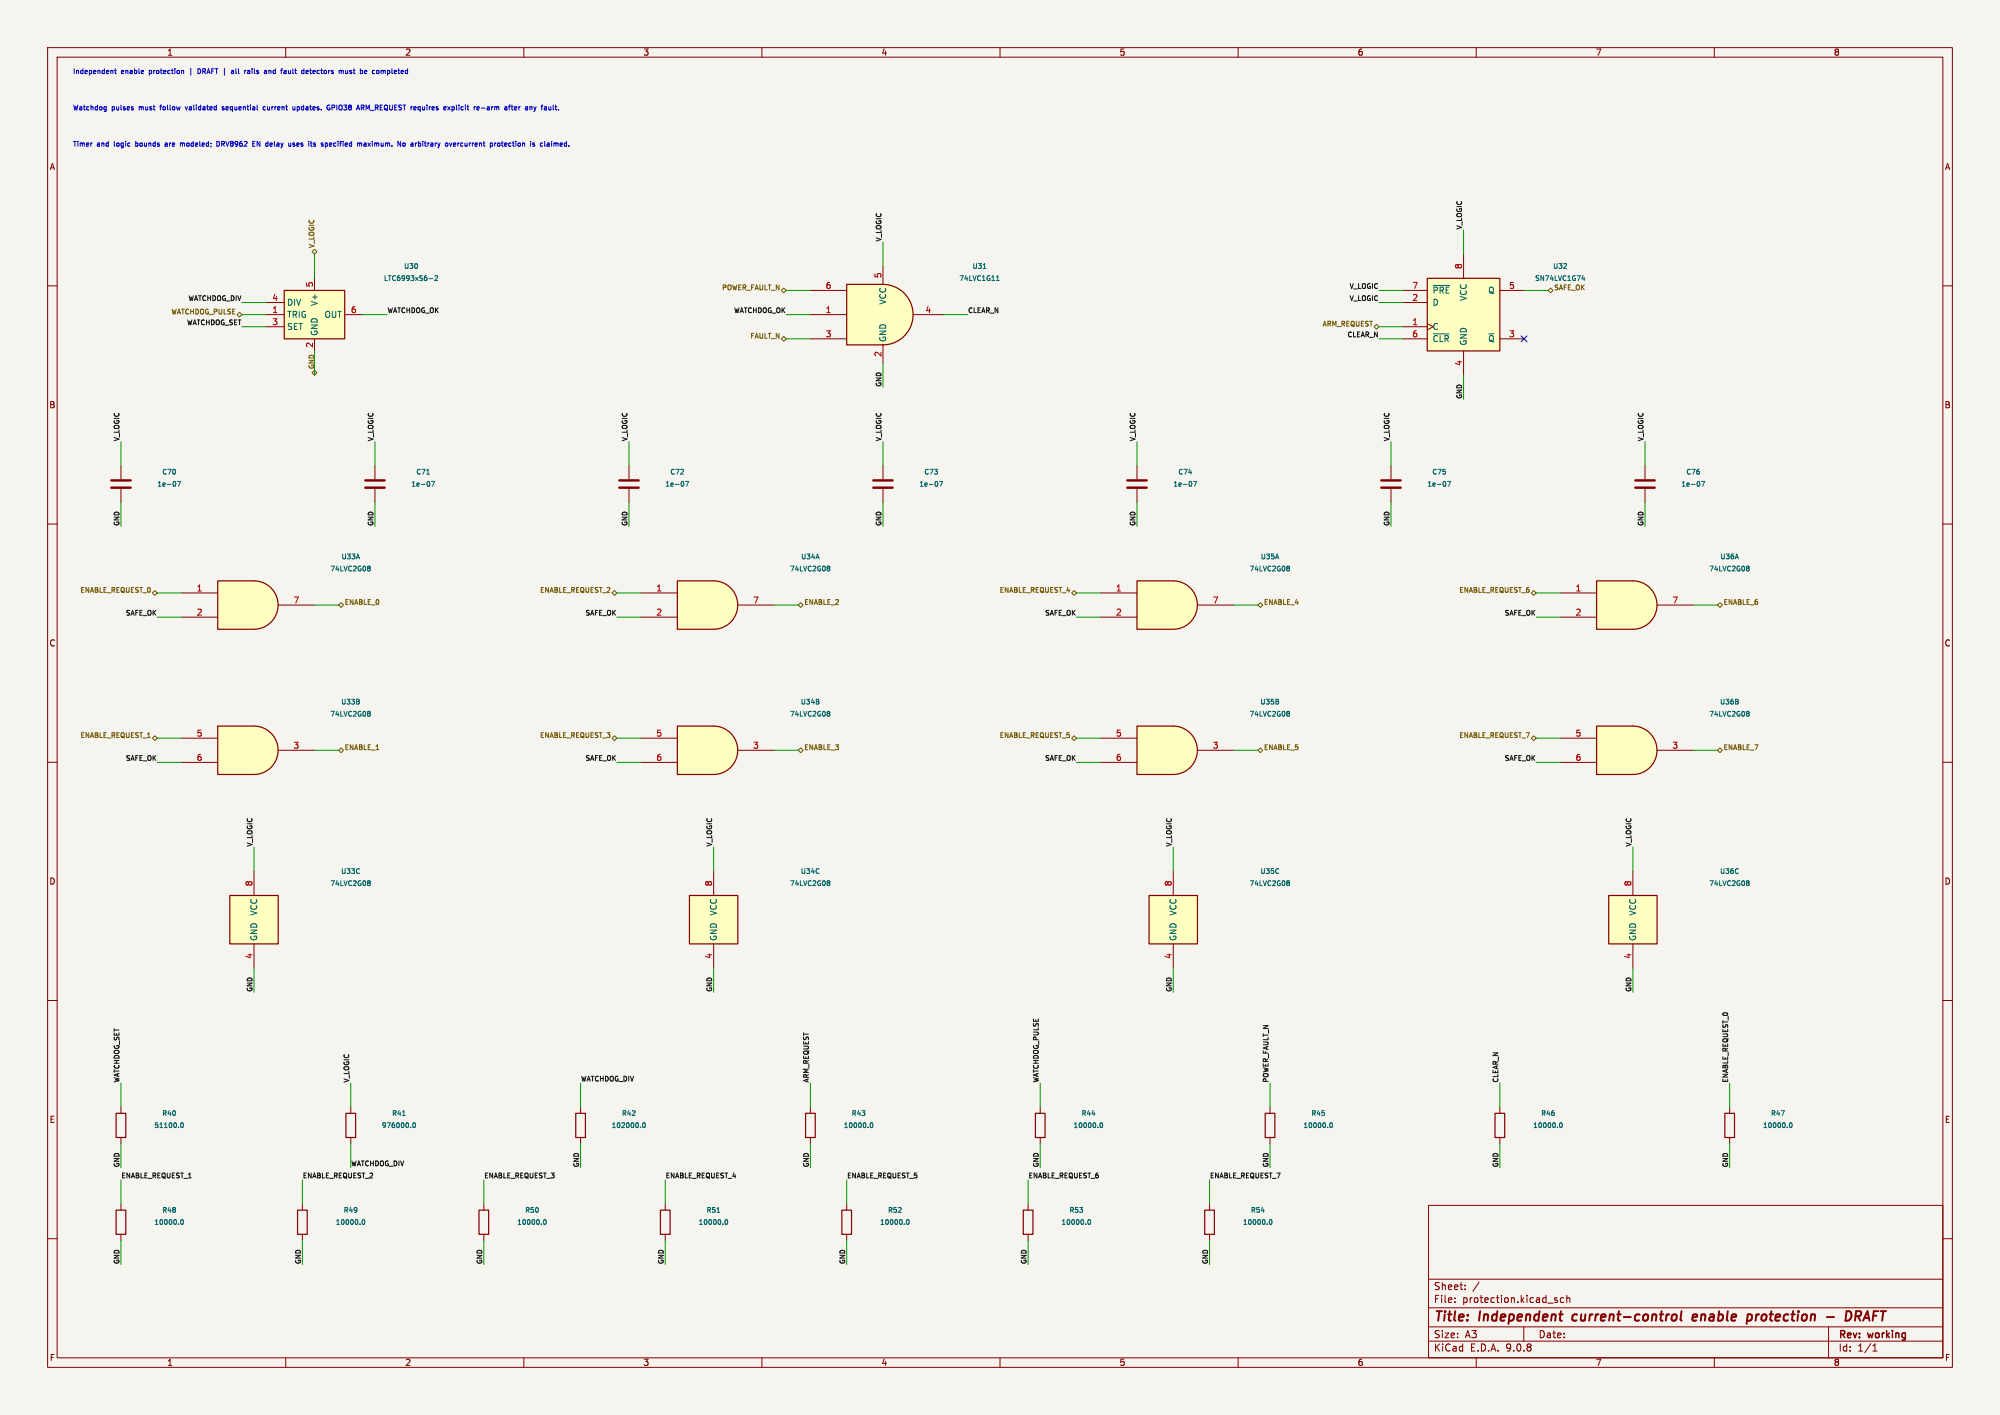
[picture p42: page 1]
