nikarus/levitating_chess/methodology/results/electronics/power_stage/unipolar_full_bridge_40V_1.cir

Independent periodic RL reference; ideal differential drive, not a transistor model
VlegA drive 0 PULSE(0 42 8.9285714285714284e-07 3.1250000000000002e-11 3.1250000000000002e-11 4.464254464285715e-06 6.2500000000000003e-06)
VlegB return 0 PULSE(0 42 2.2321428571428573e-06 3.1250000000000002e-11 3.1250000000000002e-11 1.7856830357142856e-06 6.2500000000000003e-06)
Rcoil drive winding 0.47570299886022366
Lcoil winding return 2.578766605211726e-05 IC=37.83445900792956
.options reltol=1e-08 abstol=1e-10
.control
set wr_singlescale
set wr_vecnames
set numdgt=17
tran 6.1035156250000003e-09 2.5000000000000001e-05 0 6.1035156250000003e-09 uic
let differential_voltage = v(drive)-v(return)
wrdata unipolar_full_bridge_40V_1.dat i(Lcoil) differential_voltage
quit
.endc
.end
