nikarus/levitating_chess/methodology/electronics/acquisition.kicad_sch

## KiCad design methodology/electronics/acquisition.kicad_sch (2026-10-22)

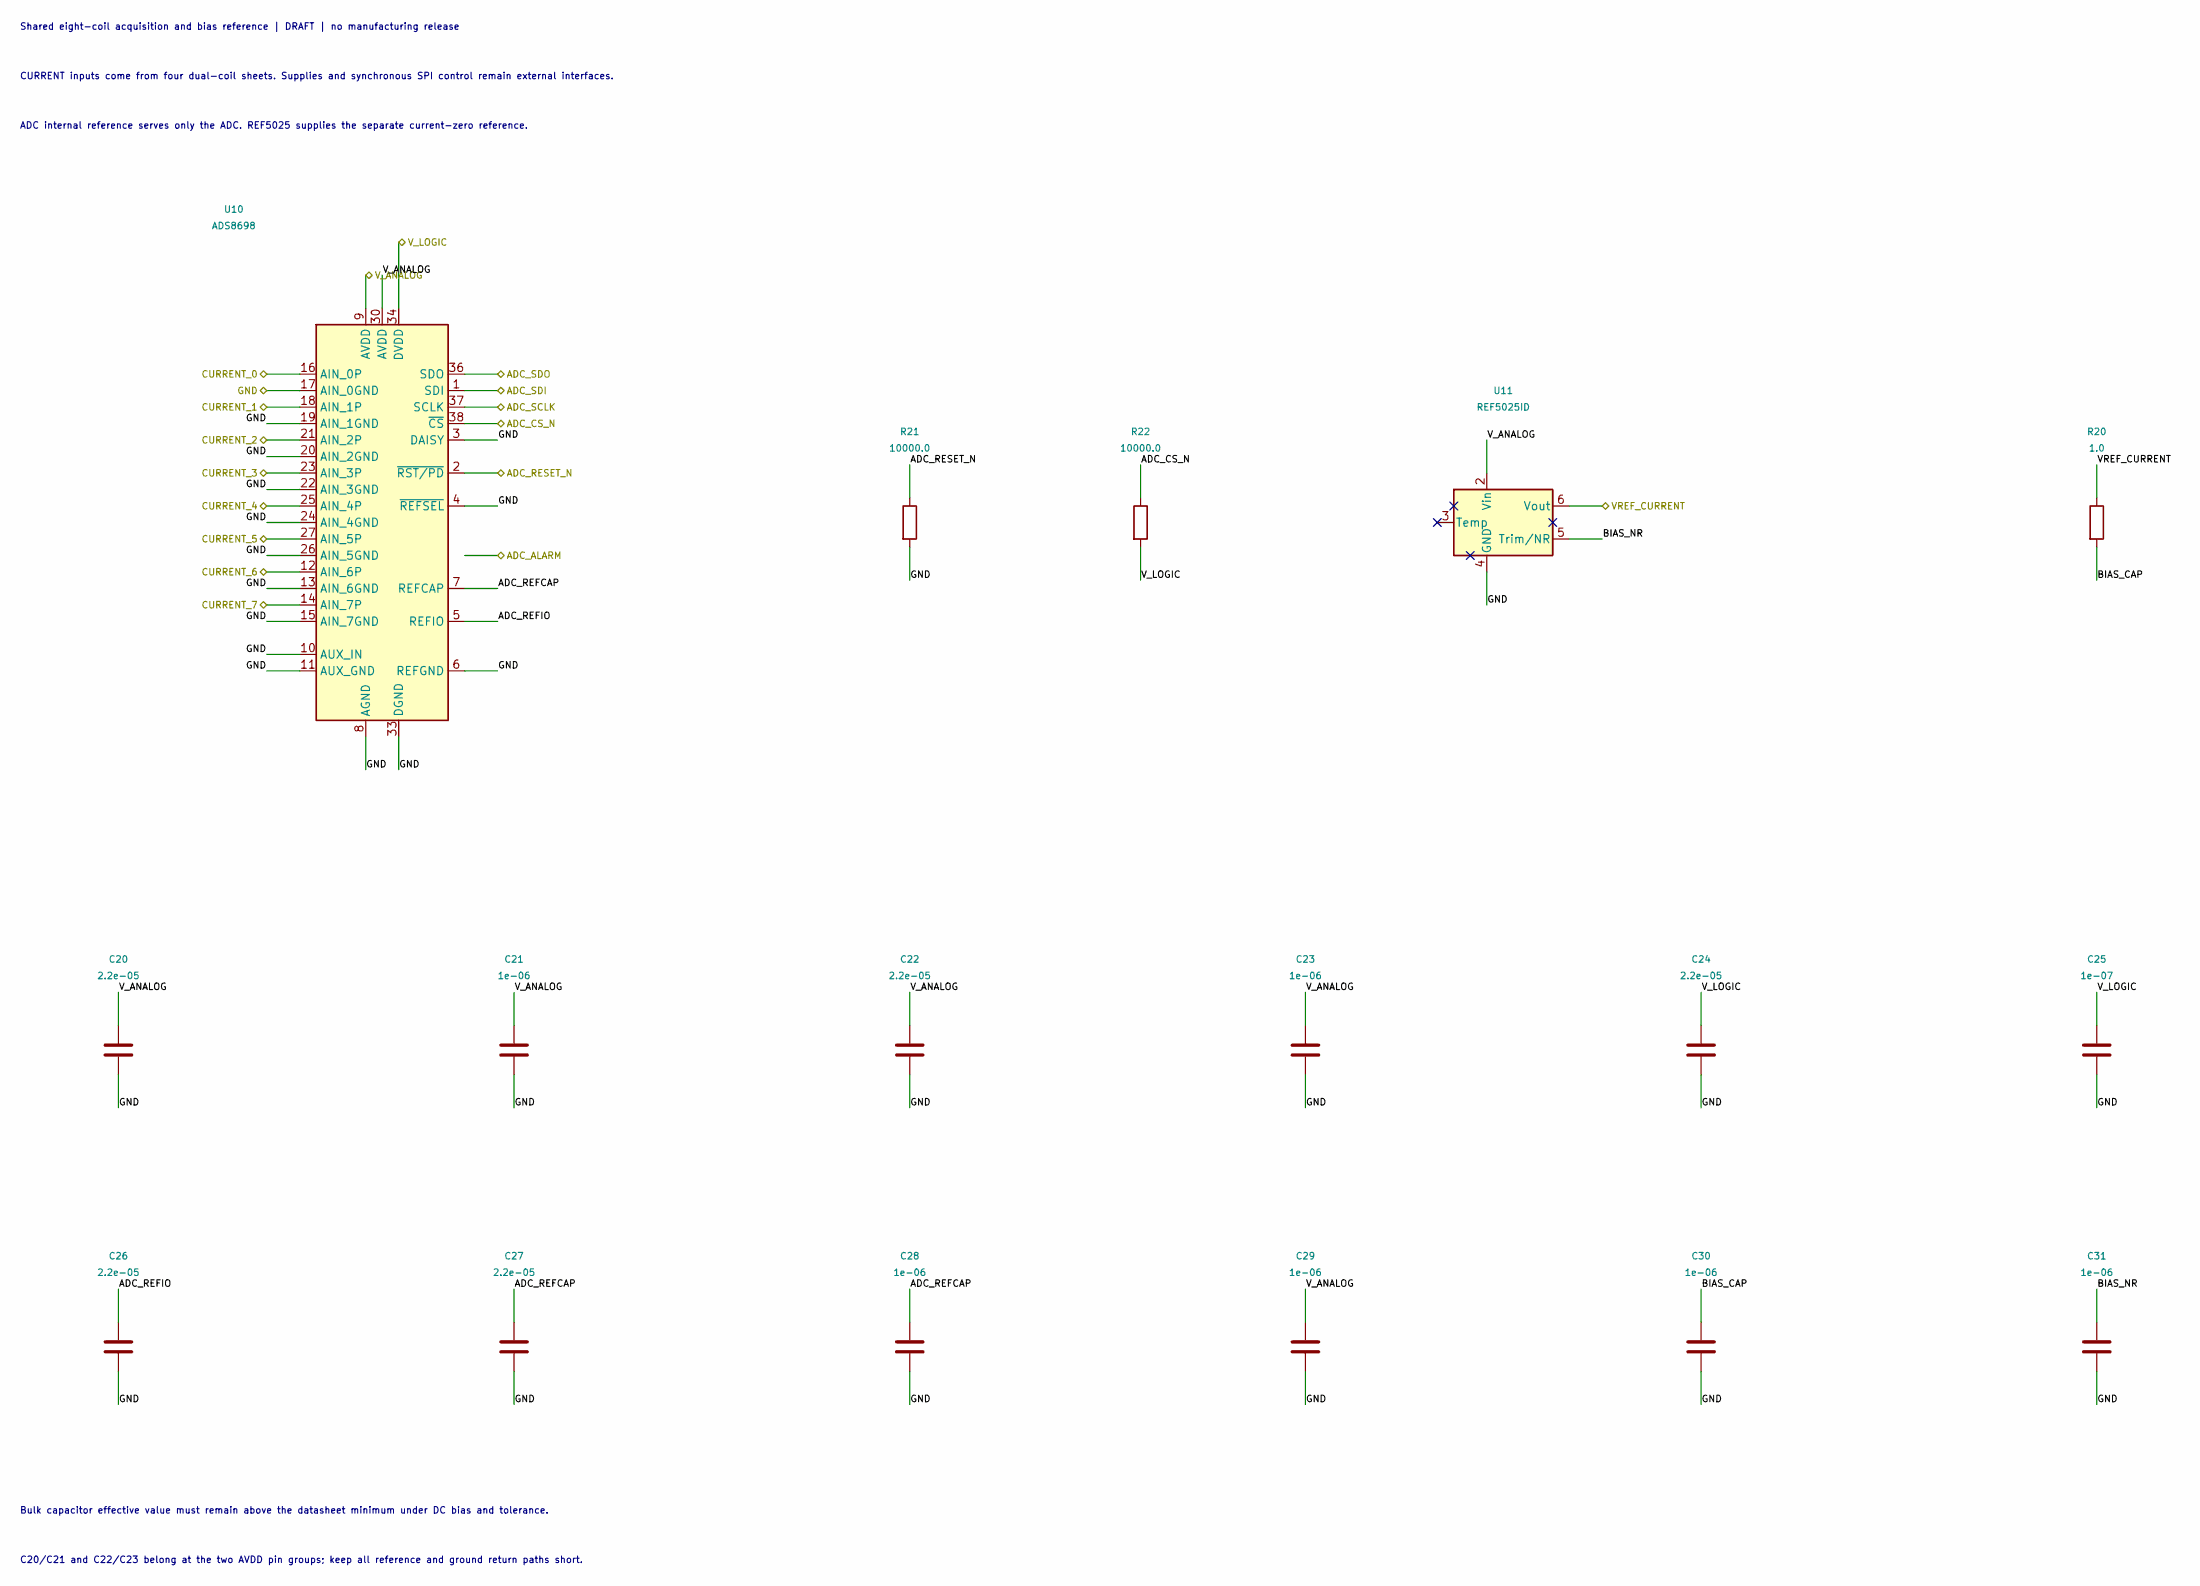
[picture p43: schematic acquisition.kicad_sch]

Parts:
C20, C22, C24, C26, C27: 2.2e-05; C_1210_3225Metric; MPN GRM32ER61C226KE20L
C21, C23, C28, C29, C30, C31: 1e-06; C_0805_2012Metric; MPN GRM21BR71H105KA12L
C25: 1e-07; C_0603_1608Metric; MPN C0603C104K5RACTU
R20: 1.0; R_0603_1608Metric; MPN RC0603FR-071RL
R21, R22: 10000.0; R_0603_1608Metric; MPN RC0603FR-0710KL
U10: ADS8698; TSSOP-38_4.4x9.7mm_P0.5mm; MPN ADS8698IDBTR
U11: REF5025ID; SOIC-8_3.9x4.9mm_P1.27mm; MPN REF5025IDR

Connections:
ADC_ALARM: U10.35 (ALARM)
ADC_CS_N: R22.1, U10.38 (~CS)
ADC_REFCAP: C27.1, C28.1, U10.7 (REFCAP)
ADC_REFIO: C26.1, U10.5 (REFIO)
ADC_RESET_N: R21.1, U10.2 (~RST/PD)
ADC_SCLK: U10.37 (SCLK)
ADC_SDI: U10.1 (SDI)
ADC_SDO: U10.36 (SDO)
BIAS_CAP: C30.1, R20.2
BIAS_NR: C31.1, U11.5 (Trim/NR)
CURRENT_0: U10.16 (AIN_0P)
CURRENT_1: U10.18 (AIN_1P)
CURRENT_2: U10.21 (AIN_2P)
CURRENT_3: U10.23 (AIN_3P)
CURRENT_4: U10.25 (AIN_4P)
CURRENT_5: U10.27 (AIN_5P)
CURRENT_6: U10.12 (AIN_6P)
CURRENT_7: U10.14 (AIN_7P)
GND: C20.2, C21.2, C22.2, C23.2, C24.2, C25.2, C26.2, C27.2, C28.2, C29.2, C30.2, C31.2, R21.2, U10.3 (DAISY), U10.4 (~REFSEL), U10.6 (REFGND), U10.8 (AGND), U10.10 (AUX_IN), U10.11 (AUX_GND), U10.13 (AIN_6GND), U10.15 (AIN_7GND), U10.17 (AIN_0GND), U10.19 (AIN_1GND), U10.20 (AIN_2GND), U10.22 (AIN_3GND), U10.24 (AIN_4GND), U10.26 (AIN_5GND), U10.28 (AGND), U10.29 (AGND), U10.31 (AGND), U10.32 (AGND), U10.33 (DGND), U11.4 (GND)
VREF_CURRENT: R20.1, U11.6 (Vout)
V_ANALOG: C20.1, C21.1, C22.1, C23.1, C29.1, U10.9 (AVDD), U10.30 (AVDD), U11.2 (Vin)
V_LOGIC: C24.1, C25.1, R22.2, U10.34 (DVDD)

Notes on the sheet:
Shared eight-coil acquisition and bias reference | DRAFT | no manufacturing release
CURRENT inputs come from four dual-coil sheets. Supplies and synchronous SPI control remain external interfaces.
ADC internal reference serves only the ADC. REF5025 supplies the separate current-zero reference.
Bulk capacitor effective value must remain above the datasheet minimum under DC bias and tolerance.
C20/C21 and C22/C23 belong at the two AVDD pin groups; keep all reference and ground return paths short.
