nikarus/levitating_chess/methodology/electronics/channel.kicad_sch

## KiCad design methodology/electronics/channel.kicad_sch (2026-10-22)

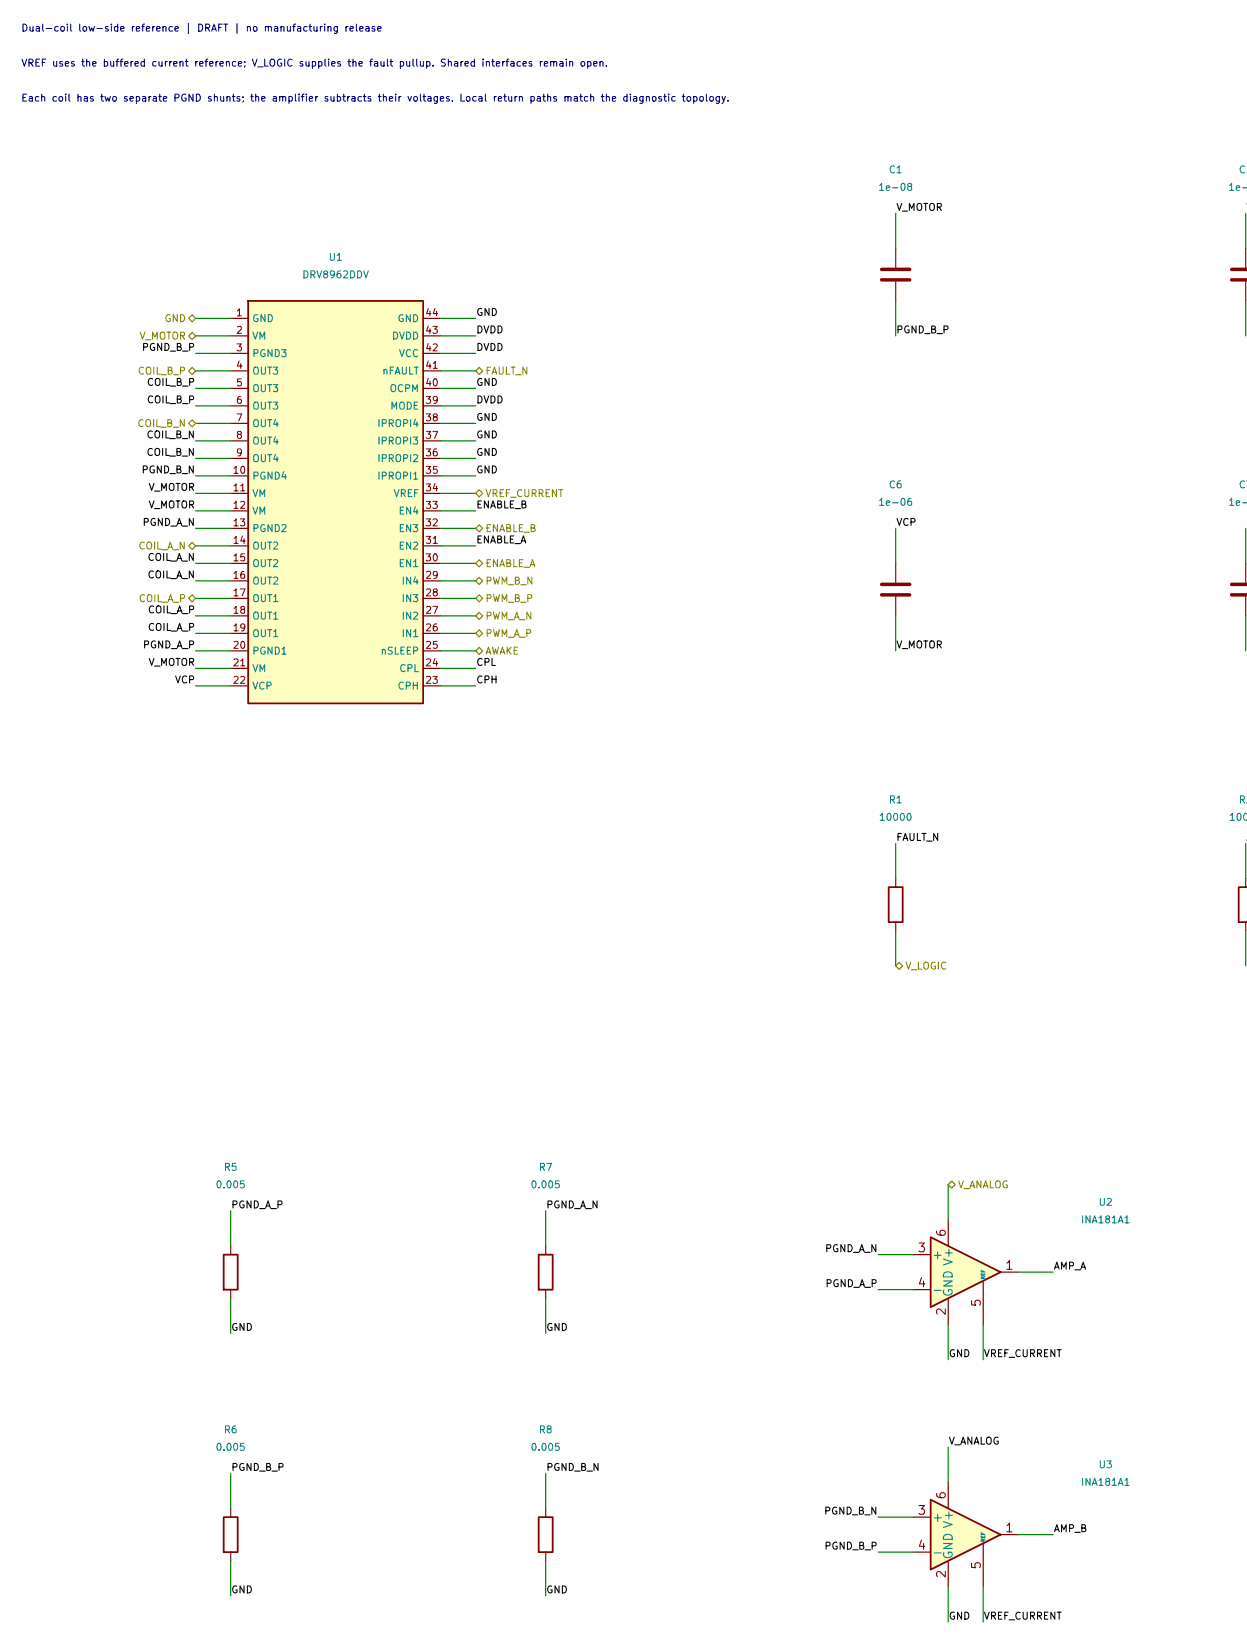
[picture p44: schematic channel.kicad_sch, part in row 1, column 1]

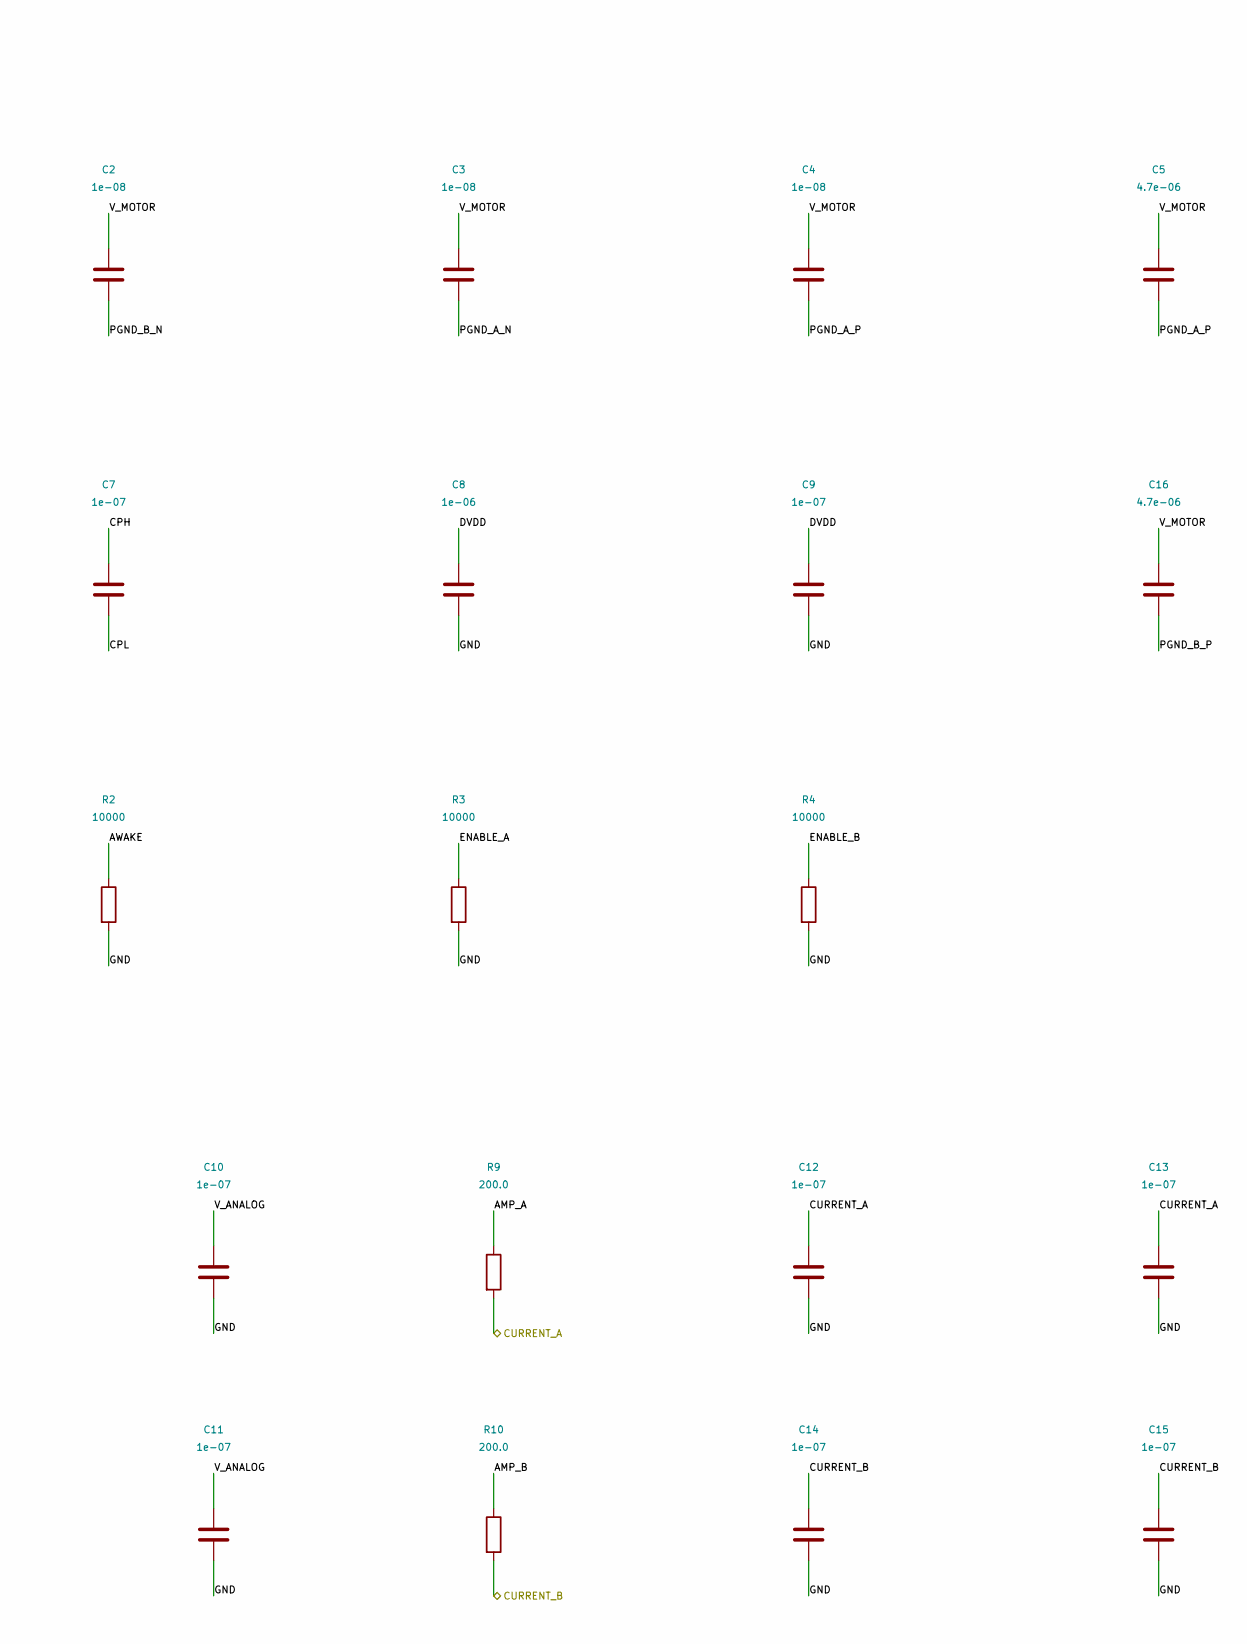
[picture p45: schematic channel.kicad_sch, part in row 1, column 2]

Parts:
C1, C2, C3, C4: 1e-08; C_0603_1608Metric; MPN C0603C103K5RACTU
C5, C16: 4.7e-06; C_1210_3225Metric; MPN GRM32ER71H475KA88L
C6, C8: 1e-06; C_0805_2012Metric; MPN C0805C105K5RACTU
C7, C9, C10, C11, C12, C13, C14, C15: 1e-07; C_0603_1608Metric; MPN C0603C104K5RACTU
R1, R2, R3, R4: 10000; R_0603_1608Metric; MPN RC0603FR-0710KL
R5, R6, R7, R8: 0.005; WSLP1206_2m_5m9; MPN WSLP12065L000FEA
R9, R10: 200.0; R_0603_1608Metric; MPN RC0603FR-07200RL
U1: DRV8962DDV; HTSSOP-44_6.1x14mm_P0.635mm_TopEP4.14x7.01mm; MPN DRV8962DDVR
U2, U3: INA181A1; SOT-23-6; MPN INA181A1IDBVR

Connections:
AMP_A: R9.1, U2.1
AMP_B: R10.1, U3.1
AWAKE: R2.1, U1.25 (nSLEEP)
COIL_A_N: U1.14 (OUT2), U1.15 (OUT2), U1.16 (OUT2)
COIL_A_P: U1.17 (OUT1), U1.18 (OUT1), U1.19 (OUT1)
COIL_B_N: U1.7 (OUT4), U1.8 (OUT4), U1.9 (OUT4)
COIL_B_P: U1.4 (OUT3), U1.5 (OUT3), U1.6 (OUT3)
CPH: C7.1, U1.23 (CPH)
CPL: C7.2, U1.24 (CPL)
CURRENT_A: C12.1, C13.1, R9.2
CURRENT_B: C14.1, C15.1, R10.2
DVDD: C8.1, C9.1, U1.39 (MODE), U1.42 (VCC), U1.43 (DVDD)
ENABLE_A: R3.1, U1.30 (EN1), U1.31 (EN2)
ENABLE_B: R4.1, U1.32 (EN3), U1.33 (EN4)
FAULT_N: R1.1, U1.41 (nFAULT)
GND: C8.2, C9.2, C10.2, C11.2, C12.2, C13.2, C14.2, C15.2, R2.2, R3.2, R4.2, R5.2, R6.2, R7.2, R8.2, U1.1 (GND), U1.35 (IPROPI1), U1.36 (IPROPI2), U1.37 (IPROPI3), U1.38 (IPROPI4), U1.40 (OCPM), U1.44 (GND), U2.2 (GND), U3.2 (GND)
PGND_A_N: C3.2, R7.1, U1.13 (PGND2), U2.3 (+)
PGND_A_P: C4.2, C5.2, R5.1, U1.20 (PGND1), U2.4 (-)
PGND_B_N: C2.2, R8.1, U1.10 (PGND4), U3.3 (+)
PGND_B_P: C1.2, C16.2, R6.1, U1.3 (PGND3), U3.4 (-)
PWM_A_N: U1.27 (IN2)
PWM_A_P: U1.26 (IN1)
PWM_B_N: U1.29 (IN4)
PWM_B_P: U1.28 (IN3)
VCP: C6.1, U1.22 (VCP)
VREF_CURRENT: U1.34 (VREF), U2.5 (REF), U3.5 (REF)
V_ANALOG: C10.1, C11.1, U2.6 (V+), U3.6 (V+)
V_LOGIC: R1.2
V_MOTOR: C1.1, C2.1, C3.1, C4.1, C5.1, C6.2, C16.1, U1.2 (VM), U1.11 (VM), U1.12 (VM), U1.21 (VM)

Notes on the sheet:
Dual-coil low-side reference | DRAFT | no manufacturing release
VREF uses the buffered current reference; V_LOGIC supplies the fault pullup. Shared interfaces remain open.
Each coil has two separate PGND shunts; the amplifier subtracts their voltages. Local return paths match the diagnostic topology.
