nikarus/levitating_chess/methodology/electronics/controller.kicad_sch

## KiCad design methodology/electronics/controller.kicad_sch (2026-10-22)

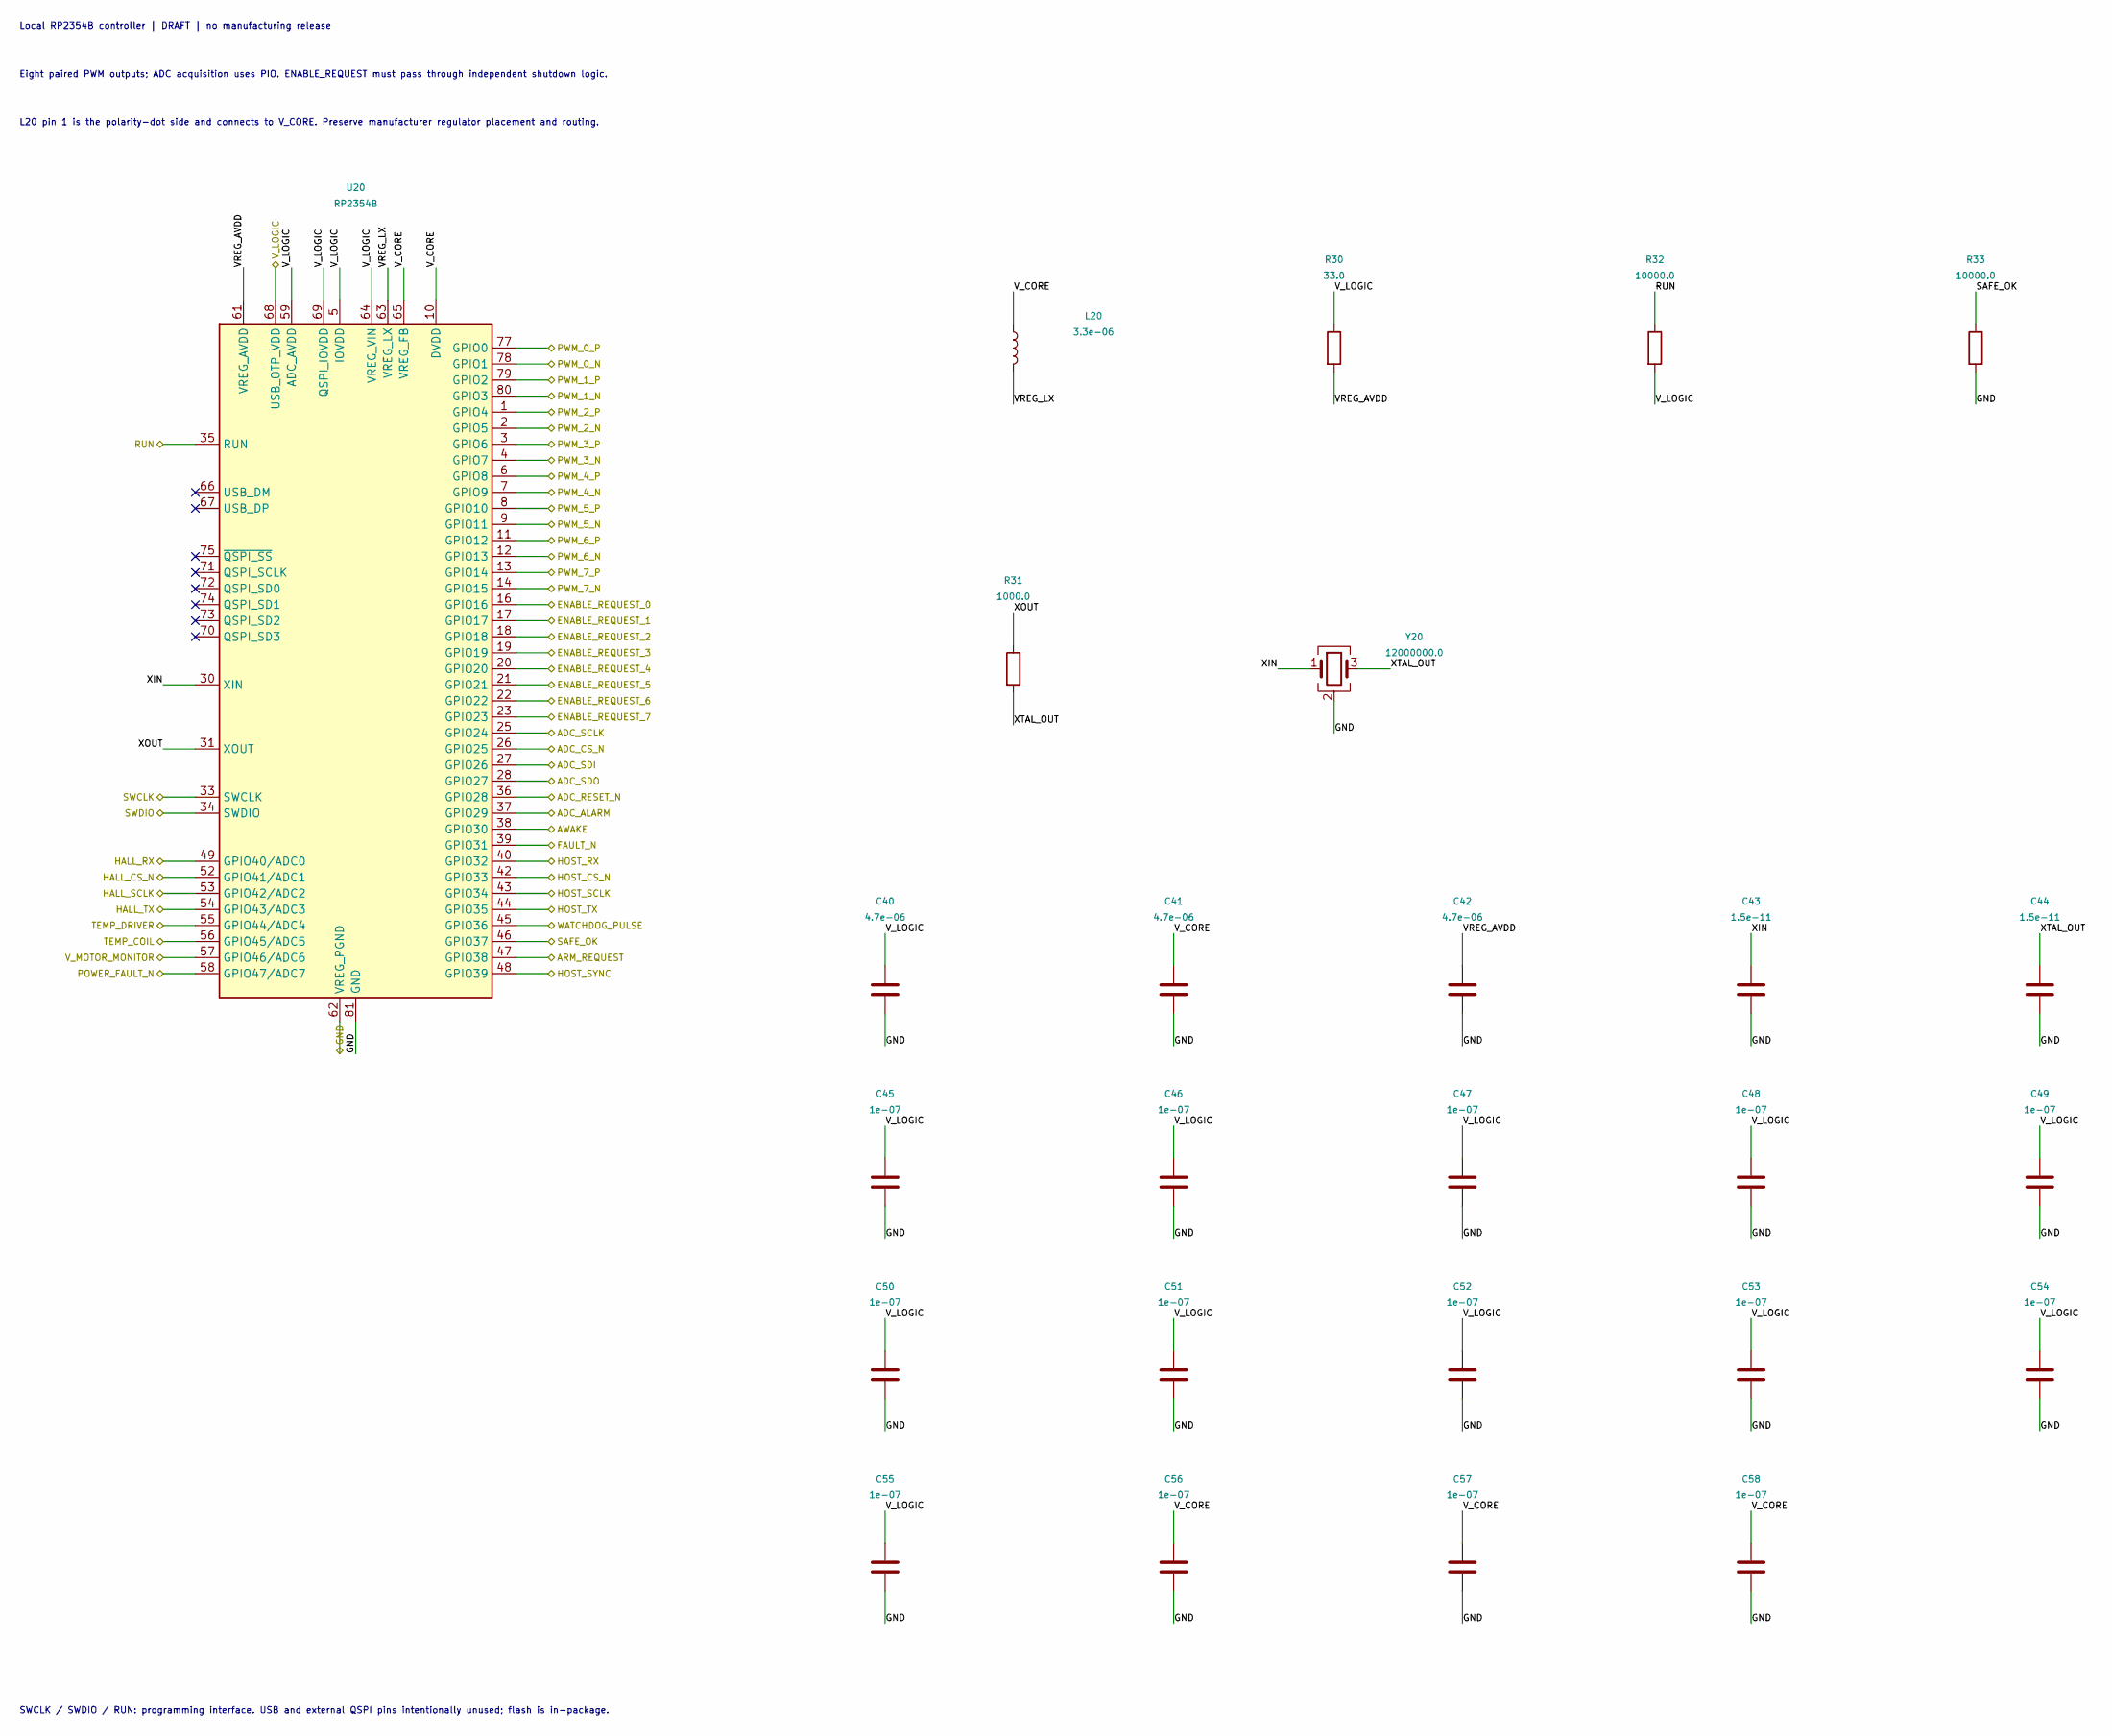
[picture p46: schematic controller.kicad_sch]

Parts:
C40, C41, C42: 4.7e-06; C_0402_1005Metric; MPN GRM155R60J475ME47D
C43, C44: 1.5e-11; C_0402_1005Metric; MPN GRM1555C1H150JA01D
C45, C46, C47, C48, C49, C50, C51, C52, C53, C54, C55, C56, C57, C58: 1e-07; C_0402_1005Metric; MPN GRM155R71E104KE14D
L20: 3.3e-06; AOTA_B201610S3R3_101_T_RPi; MPN AOTA-B201610S3R3-101-T
R30: 33.0; R_0402_1005Metric; MPN RC0402FR-0733RL
R31: 1000.0; R_0402_1005Metric; MPN RC0402FR-071KL
R32, R33: 10000.0; R_0402_1005Metric; MPN RC0402FR-0710KL
U20: RP2354B; QFN-80-1EP_10x10mm_P0.4mm_EP3.4x3.4mm; MPN RP2354B
Y20: 12000000.0; Crystal_SMD_3225-4Pin_3.2x2.5mm; MPN ABM8-272-T3

Connections:
ADC_ALARM: U20.37 (GPIO29)
ADC_CS_N: U20.26 (GPIO25)
ADC_RESET_N: U20.36 (GPIO28)
ADC_SCLK: U20.25 (GPIO24)
ADC_SDI: U20.27 (GPIO26)
ADC_SDO: U20.28 (GPIO27)
ARM_REQUEST: U20.47 (GPIO38)
AWAKE: U20.38 (GPIO30)
ENABLE_REQUEST_0: U20.16 (GPIO16)
ENABLE_REQUEST_1: U20.17 (GPIO17)
ENABLE_REQUEST_2: U20.18 (GPIO18)
ENABLE_REQUEST_3: U20.19 (GPIO19)
ENABLE_REQUEST_4: U20.20 (GPIO20)
ENABLE_REQUEST_5: U20.21 (GPIO21)
ENABLE_REQUEST_6: U20.22 (GPIO22)
ENABLE_REQUEST_7: U20.23 (GPIO23)
FAULT_N: U20.39 (GPIO31)
GND: C40.2, C41.2, C42.2, C43.2, C44.2, C45.2, C46.2, C47.2, C48.2, C49.2, C50.2, C51.2, C52.2, C53.2, C54.2, C55.2, C56.2, C57.2, C58.2, R33.2, U20.62 (VREG_PGND), U20.81 (GND), Y20.2 (G), Y20.4 (G)
HALL_CS_N: U20.52 (GPIO41/ADC1)
HALL_RX: U20.49 (GPIO40/ADC0)
HALL_SCLK: U20.53 (GPIO42/ADC2)
HALL_TX: U20.54 (GPIO43/ADC3)
HOST_CS_N: U20.42 (GPIO33)
HOST_RX: U20.40 (GPIO32)
HOST_SCLK: U20.43 (GPIO34)
HOST_SYNC: U20.48 (GPIO39)
HOST_TX: U20.44 (GPIO35)
POWER_FAULT_N: U20.58 (GPIO47/ADC7)
PWM_0_N: U20.78 (GPIO1)
PWM_0_P: U20.77 (GPIO0)
PWM_1_N: U20.80 (GPIO3)
PWM_1_P: U20.79 (GPIO2)
PWM_2_N: U20.2 (GPIO5)
PWM_2_P: U20.1 (GPIO4)
PWM_3_N: U20.4 (GPIO7)
PWM_3_P: U20.3 (GPIO6)
PWM_4_N: U20.7 (GPIO9)
PWM_4_P: U20.6 (GPIO8)
PWM_5_N: U20.9 (GPIO11)
PWM_5_P: U20.8 (GPIO10)
PWM_6_N: U20.12 (GPIO13)
PWM_6_P: U20.11 (GPIO12)
PWM_7_N: U20.14 (GPIO15)
PWM_7_P: U20.13 (GPIO14)
RUN: R32.1, U20.35 (RUN)
SAFE_OK: R33.1, U20.46 (GPIO37)
SWCLK: U20.33 (SWCLK)
SWDIO: U20.34 (SWDIO)
TEMP_COIL: U20.56 (GPIO45/ADC5)
TEMP_DRIVER: U20.55 (GPIO44/ADC4)
VREG_AVDD: C42.1, R30.2, U20.61 (VREG_AVDD)
VREG_LX: L20.2, U20.63 (VREG_LX)
V_CORE: C41.1, C56.1, C57.1, C58.1, L20.1, U20.10 (DVDD), U20.32 (DVDD), U20.51 (DVDD), U20.65 (VREG_FB)
V_LOGIC: C40.1, C45.1, C46.1, C47.1, C48.1, C49.1, C50.1, C51.1, C52.1, C53.1, C54.1, C55.1, R30.1, R32.2, U20.5 (IOVDD), U20.15 (IOVDD), U20.24 (IOVDD), U20.29 (IOVDD), U20.41 (IOVDD), U20.50 (IOVDD), U20.59 (ADC_AVDD), U20.60 (IOVDD), U20.64 (VREG_VIN), U20.68 (USB_OTP_VDD), U20.69 (QSPI_IOVDD), U20.76 (IOVDD)
V_MOTOR_MONITOR: U20.57 (GPIO46/ADC6)
WATCHDOG_PULSE: U20.45 (GPIO36)
XIN: C43.1, U20.30 (XIN), Y20.1
XOUT: R31.1, U20.31 (XOUT)
XTAL_OUT: C44.1, R31.2, Y20.3

Notes on the sheet:
Local RP2354B controller | DRAFT | no manufacturing release
Eight paired PWM outputs; ADC acquisition uses PIO. ENABLE_REQUEST must pass through independent shutdown logic.
L20 pin 1 is the polarity-dot side and connects to V_CORE. Preserve manufacturer regulator placement and routing.
SWCLK / SWDIO / RUN: programming interface. USB and external QSPI pins intentionally unused; flash is in-package.
