nikarus/levitating_chess/methodology/electronics/protection.kicad_sch

## KiCad design methodology/electronics/protection.kicad_sch (2026-10-22)

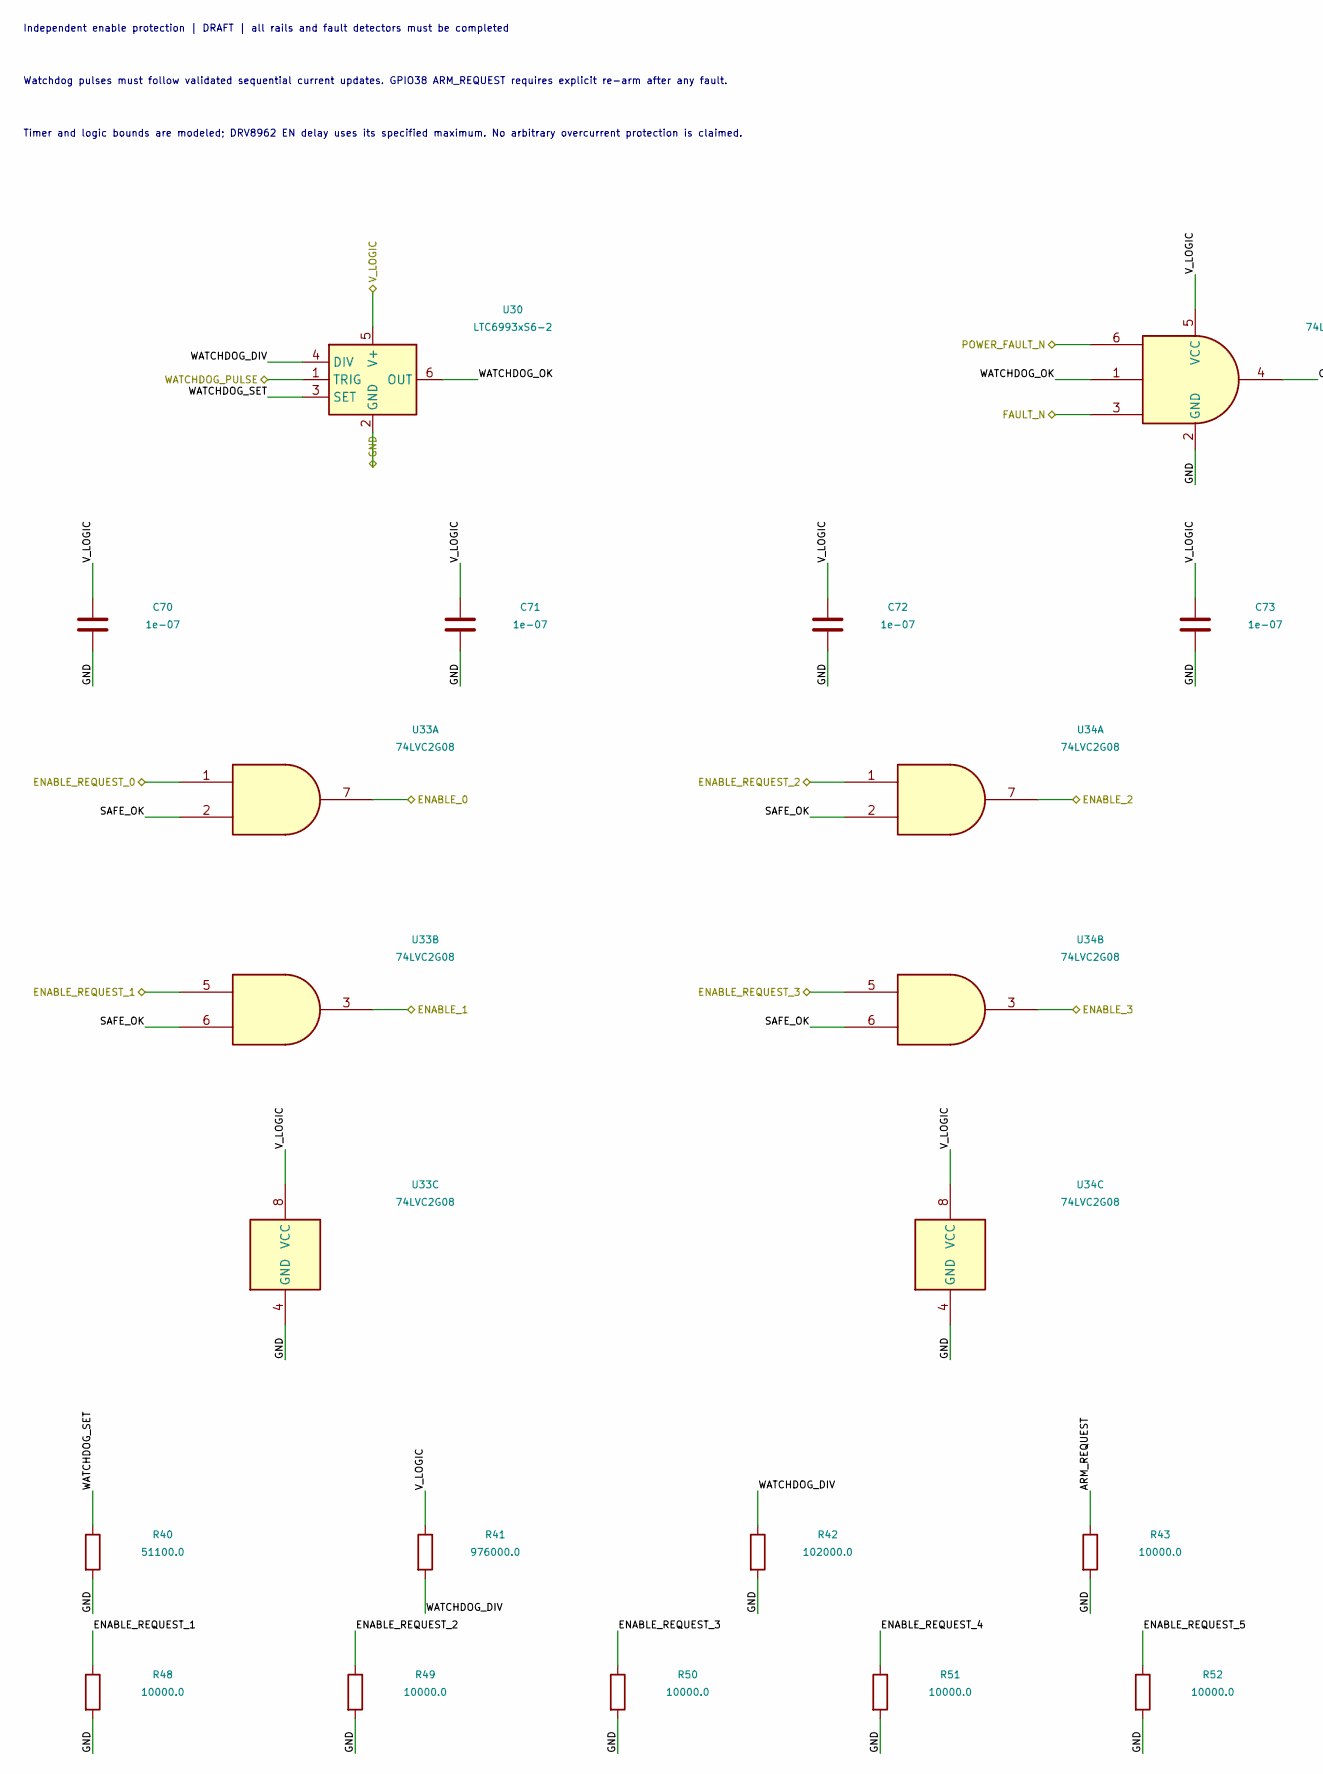
[picture p47: schematic protection.kicad_sch, part in row 1, column 1]

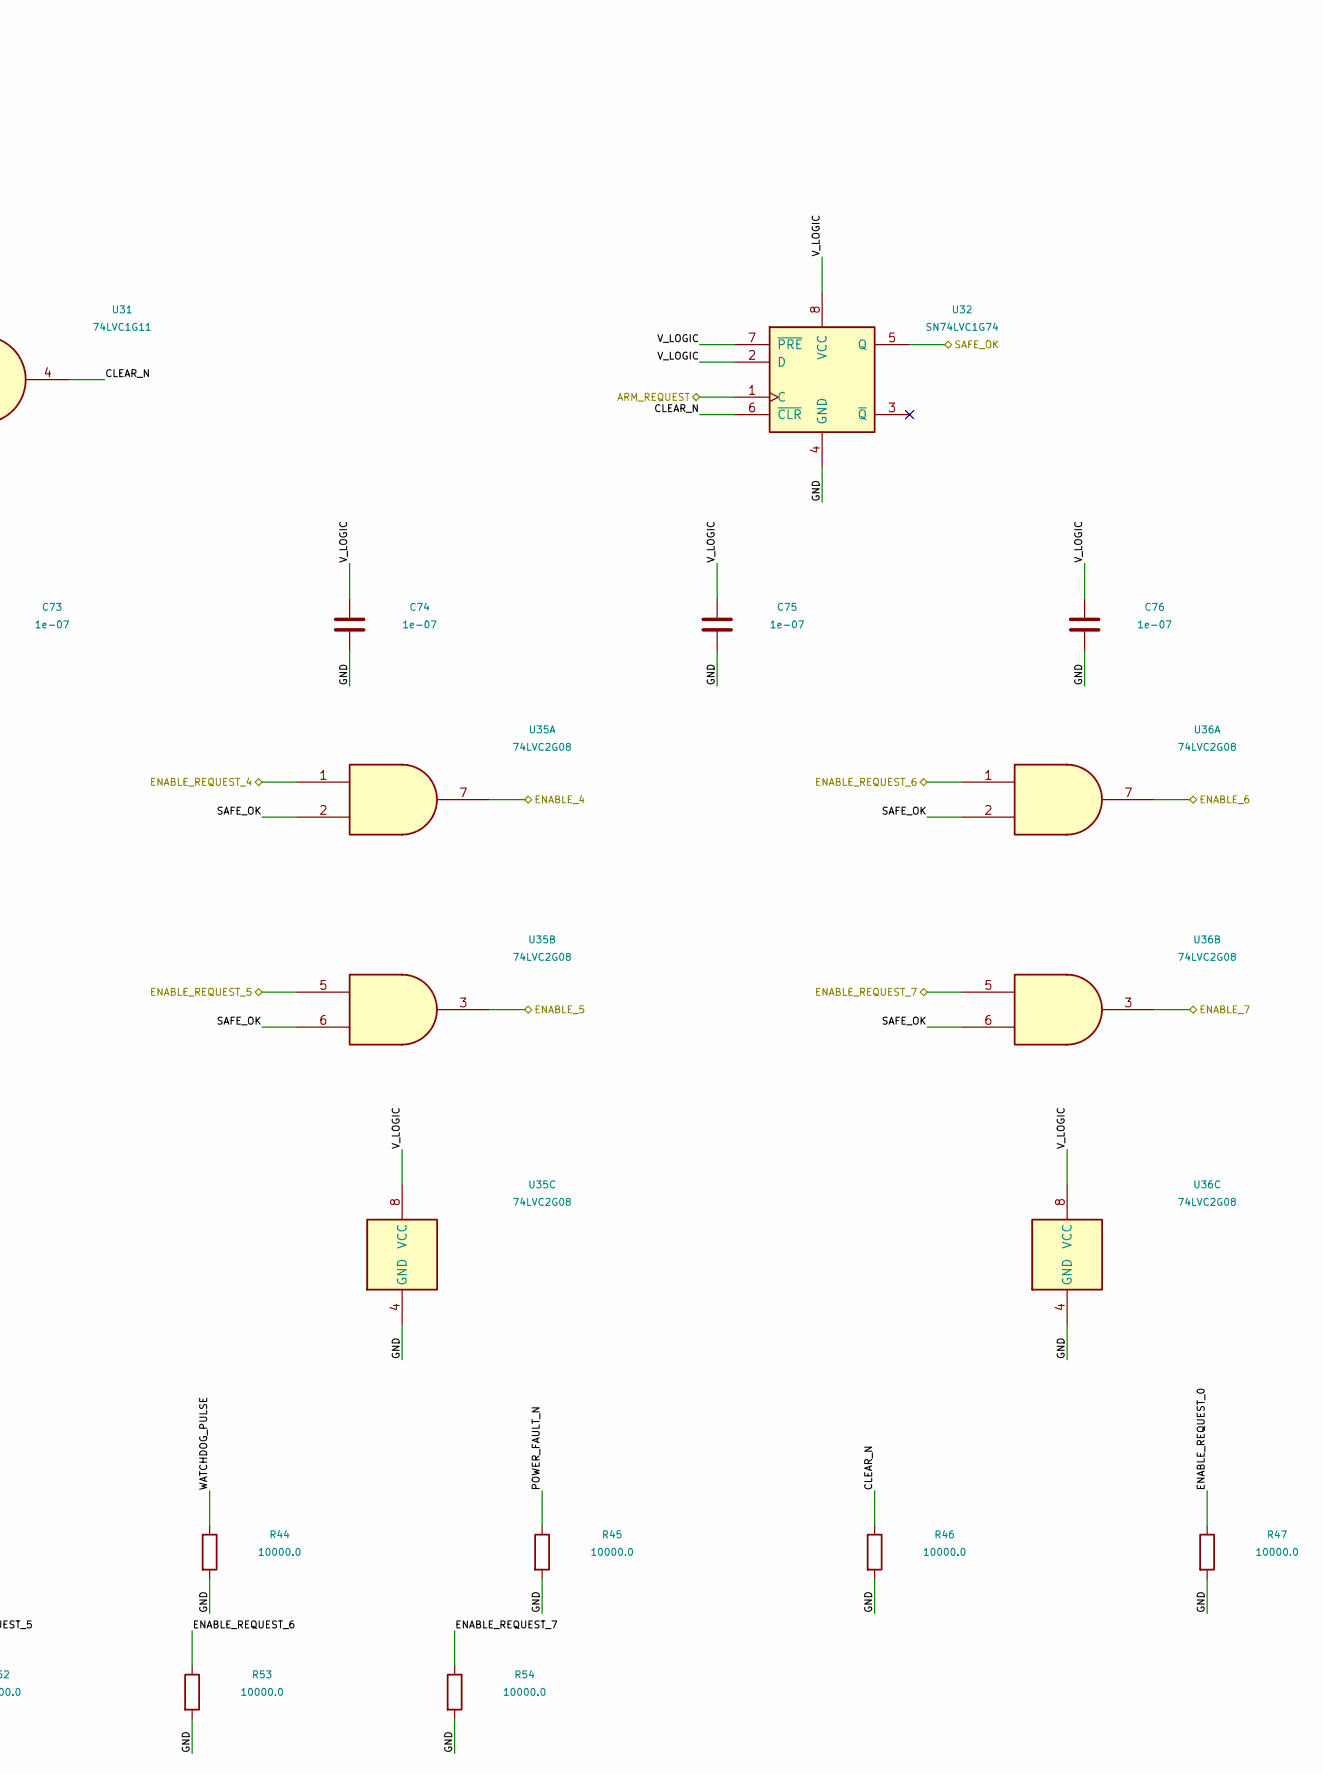
[picture p48: schematic protection.kicad_sch, part in row 1, column 2]

Parts:
C70, C71, C72, C73, C74, C75, C76: 1e-07; C_0402_1005Metric; MPN GRM155R71E104KE14D
R40: 51100.0; R_0402_1005Metric; MPN RC0402FR-0751K1L
R41: 976000.0; R_0402_1005Metric; MPN RC0402FR-07976KL
R42: 102000.0; R_0402_1005Metric; MPN RC0402FR-07102KL
R43, R44, R45, R46, R47, R48, R49, R50, R51, R52, R53, R54: 10000.0; R_0402_1005Metric; MPN RC0402FR-0710KL
U30: LTC6993xS6-2; TSOT-23-6; MPN LTC6993IS6-2#TRMPBF
U31: 74LVC1G11; SOT-23-6; MPN SN74LVC1G11DBVR
U32: SN74LVC1G74; VSSOP-8_2.3x2mm_P0.5mm; MPN SN74LVC1G74DCUR
U33, U34, U35, U36: 74LVC2G08; VSSOP-8_2.3x2mm_P0.5mm; MPN SN74LVC2G08DCUR

Connections:
ARM_REQUEST: R43.1, U32.1 (C)
CLEAR_N: R46.1, U31.4, U32.6 (~CLR)
ENABLE_0: U33.7
ENABLE_1: U33.3
ENABLE_2: U34.7
ENABLE_3: U34.3
ENABLE_4: U35.7
ENABLE_5: U35.3
ENABLE_6: U36.7
ENABLE_7: U36.3
ENABLE_REQUEST_0: R47.1, U33.1
ENABLE_REQUEST_1: R48.1, U33.5
ENABLE_REQUEST_2: R49.1, U34.1
ENABLE_REQUEST_3: R50.1, U34.5
ENABLE_REQUEST_4: R51.1, U35.1
ENABLE_REQUEST_5: R52.1, U35.5
ENABLE_REQUEST_6: R53.1, U36.1
ENABLE_REQUEST_7: R54.1, U36.5
FAULT_N: U31.3
GND: C70.2, C71.2, C72.2, C73.2, C74.2, C75.2, C76.2, R40.2, R42.2, R43.2, R44.2, R45.2, R46.2, R47.2, R48.2, R49.2, R50.2, R51.2, R52.2, R53.2, R54.2, U30.2 (GND), U31.2 (GND), U32.4 (GND), U33.4 (GND), U34.4 (GND), U35.4 (GND), U36.4 (GND)
POWER_FAULT_N: R45.1, U31.6
SAFE_OK: U32.5 (Q), U33.2, U33.6, U34.2, U34.6, U35.2, U35.6, U36.2, U36.6
V_LOGIC: C70.1, C71.1, C72.1, C73.1, C74.1, C75.1, C76.1, R41.1, U30.5 (V+), U31.5 (VCC), U32.2 (D), U32.7 (~PRE), U32.8 (VCC), U33.8 (VCC), U34.8 (VCC), U35.8 (VCC), U36.8 (VCC)
WATCHDOG_DIV: R41.2, R42.1, U30.4 (DIV)
WATCHDOG_OK: U30.6 (OUT), U31.1
WATCHDOG_PULSE: R44.1, U30.1 (TRIG)
WATCHDOG_SET: R40.1, U30.3 (SET)

Notes on the sheet:
Independent enable protection | DRAFT | all rails and fault detectors must be completed
Watchdog pulses must follow validated sequential current updates. GPIO38 ARM_REQUEST requires explicit re-arm after any fault.
Timer and logic bounds are modeled; DRV8962 EN delay uses its specified maximum. No arbitrary overcurrent protection is claimed.
