nikarus/levitating_chess/methodology/results/electronics/current_loop/compiled_runtime/regulator_settings.h

#define COIL_PATH_RESISTANCE 0x1.2c64560000000p-1f
#define COIL_INDUCTANCE 0x1.b0a52e0000000p-15f
#define DEADTIME_VOLTAGE 0x1.3a92a40000000p+1f
#define DEADTIME_CURRENT_SCALE 0x1.99999a0000000p-4f
#define DEADTIME_DOMAIN 0x1.80edfc0000000p+2f
#define DEADTIME_INDEX_SCALE 0x1.766d480000000p+6f
#define LOOP_ANGULAR_FREQUENCY 0x1.88b2f80000000p+13f
#define VOLTAGE_LIMIT 0x1.2000000000000p+4f
#define BUS_VOLTAGE 0x1.8000000000000p+4f
#define INTEGRAL_RATIO 0x1.8000000000000p-2f
#define REGULATION_RATE 0x1.3880000000000p+14f
#define PWM_HALF_COUNTS 0x1.9000000000000p+8f
#define DEADTIME_INTERVALS 563u
static const float deadtime_table[] = {0x0.0p+0f,0x1.5e0c080000000p-7f,0x1.5e01d00000000p-6f,0x1.0674940000000p-5f,0x1.5dd8f00000000p-5f,0x1.b528e40000000p-5f,0x1.062fb00000000p-4f,0x1.31bbac0000000p-4f,0x1.5d35e40000000p-4f,0x1.889bdc0000000p-4f,0x1.b3eb180000000p-4f,0x1.df21260000000p-4f,0x1.051dcc0000000p-3f,0x1.1a9c020000000p-3f,0x1.300a060000000p-3f,0x1.4566ac0000000p-3f,0x1.5ab0c80000000p-3f,0x1.6fe7360000000p-3f,0x1.8508d80000000p-3f,0x1.9a14900000000p-3f,0x1.af094a0000000p-3f,0x1.c3e5f00000000p-3f,0x1.d8a9780000000p-3f,0x1.ed52dc0000000p-3f,0x1.00f08c0000000p-2f,0x1.0b299a0000000p-2f,0x1.15541a0000000p-2f,0x1.1f6f960000000p-2f,0x1.297b9a0000000p-2f,0x1.3377b60000000p-2f,0x1.3d63760000000p-2f,0x1.473e740000000p-2f,0x1.5108480000000p-2f,0x1.5ac08c0000000p-2f,0x1.6466e00000000p-2f,0x1.6dfae80000000p-2f,0x1.777c480000000p-2f,0x1.80eaaa0000000p-2f,0x1.8a45be0000000p-2f,0x1.938d320000000p-2f,0x1.9cc0ba0000000p-2f,0x1.a5e0100000000p-2f,0x1.aeeaee0000000p-2f,0x1.b7e1160000000p-2f,0x1.c0c2460000000p-2f,0x1.c98e480000000p-2f,0x1.d244e40000000p-2f,0x1.dae5e80000000p-2f,0x1.e371240000000p-2f,0x1.ebe66c0000000p-2f,0x1.f445980000000p-2f,0x1.fc8e840000000p-2f,0x1.0260860000000p-1f,0x1.066e8a0000000p-1f,0x1.0a71400000000p-1f,0x1.0e689a0000000p-1f,0x1.1254920000000p-1f,0x1.16351a0000000p-1f,0x1.1a0a300000000p-1f,0x1.1dd3ca0000000p-1f,0x1.2191e40000000p-1f,0x1.25447e0000000p-1f,0x1.28eb920000000p-1f,0x1.2c87240000000p-1f,0x1.3017340000000p-1f,0x1.339bc20000000p-1f,0x1.3714d60000000p-1f,0x1.3a82700000000p-1f,0x1.3de49a0000000p-1f,0x1.413b5a0000000p-1f,0x1.4486b80000000p-1f,0x1.47c6be0000000p-1f,0x1.4afb780000000p-1f,0x1.4e24ee0000000p-1f,0x1.51432e0000000p-1f,0x1.5456480000000p-1f,0x1.575e480000000p-1f,0x1.5a5b3e0000000p-1f,0x1.5d4d3a0000000p-1f,0x1.60344c0000000p-1f,0x1.6310880000000p-1f,0x1.65e1fe0000000p-1f,0x1.68a8c20000000p-1f,0x1.6b64e80000000p-1f,0x1.6e16860000000p-1f,0x1.70bdae0000000p-1f,0x1.735a780000000p-1f,0x1.75ecf80000000p-1f,0x1.7875480000000p-1f,0x1.7af37c0000000p-1f,0x1.7d67ac0000000p-1f,0x1.7fd1f20000000p-1f,0x1.8232640000000p-1f,0x1.84891c0000000p-1f,0x1.86d6340000000p-1f,0x1.8919c40000000p-1f,0x1.8b53e60000000p-1f,0x1.8d84b40000000p-1f,0x1.8fac480000000p-1f,0x1.91cabc0000000p-1f,0x1.93e02a0000000p-1f,0x1.95ecb00000000p-1f,0x1.97f0660000000p-1f,0x1.99eb680000000p-1f,0x1.9bddd00000000p-1f,0x1.9dc7b80000000p-1f,0x1.9fa9400000000p-1f,0x1.a1827e0000000p-1f,0x1.a353920000000p-1f,0x1.a51c920000000p-1f,0x1.a6dd9e0000000p-1f,0x1.a896ce0000000p-1f,0x1.aa48400000000p-1f,0x1.abf20c0000000p-1f,0x1.ad94500000000p-1f,0x1.af2f240000000p-1f,0x1.b0c2a60000000p-1f,0x1.b24eee0000000p-1f,0x1.b3d41a0000000p-1f,0x1.b552400000000p-1f,0x1.b6c97e0000000p-1f,0x1.b839ee0000000p-1f,0x1.b9a3a80000000p-1f,0x1.bb06c80000000p-1f,0x1.bc63660000000p-1f,0x1.bdb99c0000000p-1f,0x1.bf09840000000p-1f,0x1.c053360000000p-1f,0x1.c196cc0000000p-1f,0x1.c2d45e0000000p-1f,0x1.c40c060000000p-1f,0x1.c53dda0000000p-1f,0x1.c669f20000000p-1f,0x1.c7906a0000000p-1f,0x1.c8b1540000000p-1f,0x1.c9ccca0000000p-1f,0x1.cae2e40000000p-1f,0x1.cbf3b60000000p-1f,0x1.ccff5a0000000p-1f,0x1.ce05e40000000p-1f,0x1.cf076a0000000p-1f,0x1.d004020000000p-1f,0x1.d0fbc40000000p-1f,0x1.d1eec20000000p-1f,0x1.d2dd120000000p-1f,0x1.d3c6c80000000p-1f,0x1.d4abfa0000000p-1f,0x1.d58cbc0000000p-1f,0x1.d669220000000p-1f,0x1.d741400000000p-1f,0x1.d815260000000p-1f,0x1.d8e4ec0000000p-1f,0x1.d9b0a20000000p-1f,0x1.da785a0000000p-1f,0x1.db3c2a0000000p-1f,0x1.dbfc200000000p-1f,0x1.dcb8500000000p-1f,0x1.dd70ca0000000p-1f,0x1.de25a20000000p-1f,0x1.ded6e60000000p-1f,0x1.df84aa0000000p-1f,0x1.e02efc0000000p-1f,0x1.e0d5ec0000000p-1f,0x1.e1798c0000000p-1f,0x1.e219ea0000000p-1f,0x1.e2b7180000000p-1f,0x1.e351220000000p-1f,0x1.e3e8180000000p-1f,0x1.e47c0c0000000p-1f,0x1.e50d080000000p-1f,0x1.e59b1c0000000p-1f,0x1.e626580000000p-1f,0x1.e6aec60000000p-1f,0x1.e734780000000p-1f,0x1.e7b7780000000p-1f,0x1.e837d40000000p-1f,0x1.e8b59a0000000p-1f,0x1.e930d60000000p-1f,0x1.e9a9940000000p-1f,0x1.ea1fe20000000p-1f,0x1.ea93ca0000000p-1f,0x1.eb05580000000p-1f,0x1.eb749a0000000p-1f,0x1.ebe1980000000p-1f,0x1.ec4c600000000p-1f,0x1.ecb4fc0000000p-1f,0x1.ed1b780000000p-1f,0x1.ed7fdc0000000p-1f,0x1.ede2360000000p-1f,0x1.ee428c0000000p-1f,0x1.eea0ec0000000p-1f,0x1.eefd600000000p-1f,0x1.ef57ee0000000p-1f,0x1.efb0a20000000p-1f,0x1.f007860000000p-1f,0x1.f05ca00000000p-1f,0x1.f0affe0000000p-1f,0x1.f101a40000000p-1f,0x1.f1519e0000000p-1f,0x1.f19ff40000000p-1f,0x1.f1ecae0000000p-1f,0x1.f237d40000000p-1f,0x1.f2816e0000000p-1f,0x1.f2c9840000000p-1f,0x1.f3101c0000000p-1f,0x1.f355420000000p-1f,0x1.f398fa0000000p-1f,0x1.f3db4c0000000p-1f,0x1.f41c400000000p-1f,0x1.f45bdc0000000p-1f,0x1.f49a280000000p-1f,0x1.f4d72c0000000p-1f,0x1.f512ea0000000p-1f,0x1.f54d6e0000000p-1f,0x1.f586ba0000000p-1f,0x1.f5bed60000000p-1f,0x1.f5f5ca0000000p-1f,0x1.f62b9a0000000p-1f,0x1.f6604c0000000p-1f,0x1.f693e60000000p-1f,0x1.f6c66e0000000p-1f,0x1.f6f7e80000000p-1f,0x1.f7285e0000000p-1f,0x1.f757d00000000p-1f,0x1.f786460000000p-1f,0x1.f7b3c40000000p-1f,0x1.f7e0500000000p-1f,0x1.f80bf00000000p-1f,0x1.f836a60000000p-1f,0x1.f8607a0000000p-1f,0x1.f8896e0000000p-1f,0x1.f8b1880000000p-1f,0x1.f8d8cc0000000p-1f,0x1.f8ff3e0000000p-1f,0x1.f924e20000000p-1f,0x1.f949be0000000p-1f,0x1.f96dd40000000p-1f,0x1.f9912c0000000p-1f,0x1.f9b3c40000000p-1f,0x1.f9d5a40000000p-1f,0x1.f9f6d00000000p-1f,0x1.fa174a0000000p-1f,0x1.fa37160000000p-1f,0x1.fa56380000000p-1f,0x1.fa74b40000000p-1f,0x1.fa928c0000000p-1f,0x1.faafc40000000p-1f,0x1.facc600000000p-1f,0x1.fae8620000000p-1f,0x1.fb03ce0000000p-1f,0x1.fb1ea80000000p-1f,0x1.fb38f20000000p-1f,0x1.fb52ae0000000p-1f,0x1.fb6be00000000p-1f,0x1.fb848c0000000p-1f,0x1.fb9cb20000000p-1f,0x1.fbb4580000000p-1f,0x1.fbcb7e0000000p-1f,0x1.fbe2280000000p-1f,0x1.fbf85a0000000p-1f,0x1.fc0e120000000p-1f,0x1.fc23580000000p-1f,0x1.fc382a0000000p-1f,0x1.fc4c8c0000000p-1f,0x1.fc60820000000p-1f,0x1.fc740c0000000p-1f,0x1.fc872c0000000p-1f,0x1.fc99e60000000p-1f,0x1.fcac3c0000000p-1f,0x1.fcbe300000000p-1f,0x1.fccfc20000000p-1f,0x1.fce0f60000000p-1f,0x1.fcf1cc0000000p-1f,0x1.fd024a0000000p-1f,0x1.fd126c0000000p-1f,0x1.fd223a0000000p-1f,0x1.fd31b20000000p-1f,0x1.fd40d60000000p-1f,0x1.fd4faa0000000p-1f,0x1.fd5e2e0000000p-1f,0x1.fd6c640000000p-1f,0x1.fd7a4c0000000p-1f,0x1.fd87ea0000000p-1f,0x1.fd953e0000000p-1f,0x1.fda24c0000000p-1f,0x1.fdaf120000000p-1f,0x1.fdbb940000000p-1f,0x1.fdc7d20000000p-1f,0x1.fdd3ce0000000p-1f,0x1.fddf8a0000000p-1f,0x1.fdeb060000000p-1f,0x1.fdf6440000000p-1f,0x1.fe01460000000p-1f,0x1.fe0c0e0000000p-1f,0x1.fe169a0000000p-1f,0x1.fe20ee0000000p-1f,0x1.fe2b0a0000000p-1f,0x1.fe34ee0000000p-1f,0x1.fe3e9e0000000p-1f,0x1.fe481a0000000p-1f,0x1.fe51640000000p-1f,0x1.fe5a7a0000000p-1f,0x1.fe63600000000p-1f,0x1.fe6c140000000p-1f,0x1.fe749c0000000p-1f,0x1.fe7cf40000000p-1f,0x1.fe85200000000p-1f,0x1.fe8d200000000p-1f,0x1.fe94f40000000p-1f,0x1.fe9c9e0000000p-1f,0x1.fea41e0000000p-1f,0x1.feab760000000p-1f,0x1.feb2a60000000p-1f,0x1.feb9b00000000p-1f,0x1.fec0940000000p-1f,0x1.fec7520000000p-1f,0x1.fecdec0000000p-1f,0x1.fed4640000000p-1f,0x1.fedab60000000p-1f,0x1.fee0e80000000p-1f,0x1.fee6f80000000p-1f,0x1.feece80000000p-1f,0x1.fef2b60000000p-1f,0x1.fef8660000000p-1f,0x1.fefdf80000000p-1f,0x1.ff036a0000000p-1f,0x1.ff08c00000000p-1f,0x1.ff0dfa0000000p-1f,0x1.ff13160000000p-1f,0x1.ff18160000000p-1f,0x1.ff1cfc0000000p-1f,0x1.ff21c80000000p-1f,0x1.ff267a0000000p-1f,0x1.ff2b120000000p-1f,0x1.ff2f920000000p-1f,0x1.ff33f80000000p-1f,0x1.ff38480000000p-1f,0x1.ff3c800000000p-1f,0x1.ff40a00000000p-1f,0x1.ff44ac0000000p-1f,0x1.ff48a00000000p-1f,0x1.ff4c800000000p-1f,0x1.ff504c0000000p-1f,0x1.ff54020000000p-1f,0x1.ff57a40000000p-1f,0x1.ff5b320000000p-1f,0x1.ff5eae0000000p-1f,0x1.ff62160000000p-1f,0x1.ff656c0000000p-1f,0x1.ff68b00000000p-1f,0x1.ff6be20000000p-1f,0x1.ff6f040000000p-1f,0x1.ff72140000000p-1f,0x1.ff75140000000p-1f,0x1.ff78020000000p-1f,0x1.ff7ae20000000p-1f,0x1.ff7db20000000p-1f,0x1.ff80740000000p-1f,0x1.ff83260000000p-1f,0x1.ff85c80000000p-1f,0x1.ff885e0000000p-1f,0x1.ff8ae40000000p-1f,0x1.ff8d5e0000000p-1f,0x1.ff8fca0000000p-1f,0x1.ff922a0000000p-1f,0x1.ff947c0000000p-1f,0x1.ff96c20000000p-1f,0x1.ff98fa0000000p-1f,0x1.ff9b280000000p-1f,0x1.ff9d4a0000000p-1f,0x1.ff9f600000000p-1f,0x1.ffa16a0000000p-1f,0x1.ffa36a0000000p-1f,0x1.ffa55e0000000p-1f,0x1.ffa7480000000p-1f,0x1.ffa9280000000p-1f,0x1.ffaafe0000000p-1f,0x1.ffacca0000000p-1f,0x1.ffae8c0000000p-1f,0x1.ffb0460000000p-1f,0x1.ffb1f40000000p-1f,0x1.ffb39a0000000p-1f,0x1.ffb5380000000p-1f,0x1.ffb6cc0000000p-1f,0x1.ffb8580000000p-1f,0x1.ffb9dc0000000p-1f,0x1.ffbb580000000p-1f,0x1.ffbccc0000000p-1f,0x1.ffbe360000000p-1f,0x1.ffbf9a0000000p-1f,0x1.ffc0f80000000p-1f,0x1.ffc24c0000000p-1f,0x1.ffc39a0000000p-1f,0x1.ffc4e00000000p-1f,0x1.ffc6200000000p-1f,0x1.ffc75a0000000p-1f,0x1.ffc88c0000000p-1f,0x1.ffc9b80000000p-1f,0x1.ffcade0000000p-1f,0x1.ffcbfe0000000p-1f,0x1.ffcd180000000p-1f,0x1.ffce2a0000000p-1f,0x1.ffcf380000000p-1f,0x1.ffd0400000000p-1f,0x1.ffd1420000000p-1f,0x1.ffd2400000000p-1f,0x1.ffd3360000000p-1f,0x1.ffd42a0000000p-1f,0x1.ffd5160000000p-1f,0x1.ffd5fe0000000p-1f,0x1.ffd6e20000000p-1f,0x1.ffd7c00000000p-1f,0x1.ffd89a0000000p-1f,0x1.ffd9700000000p-1f,0x1.ffda400000000p-1f,0x1.ffdb0c0000000p-1f,0x1.ffdbd40000000p-1f,0x1.ffdc980000000p-1f,0x1.ffdd580000000p-1f,0x1.ffde140000000p-1f,0x1.ffdeca0000000p-1f,0x1.ffdf7e0000000p-1f,0x1.ffe02e0000000p-1f,0x1.ffe0da0000000p-1f,0x1.ffe1820000000p-1f,0x1.ffe2280000000p-1f,0x1.ffe2ca0000000p-1f,0x1.ffe3680000000p-1f,0x1.ffe4020000000p-1f,0x1.ffe49a0000000p-1f,0x1.ffe52e0000000p-1f,0x1.ffe5c00000000p-1f,0x1.ffe64e0000000p-1f,0x1.ffe6d80000000p-1f,0x1.ffe7600000000p-1f,0x1.ffe7e60000000p-1f,0x1.ffe8680000000p-1f,0x1.ffe8e80000000p-1f,0x1.ffe9640000000p-1f,0x1.ffe9de0000000p-1f,0x1.ffea560000000p-1f,0x1.ffeacc0000000p-1f,0x1.ffeb3e0000000p-1f,0x1.ffebae0000000p-1f,0x1.ffec1c0000000p-1f,0x1.ffec880000000p-1f,0x1.ffecf20000000p-1f,0x1.ffed580000000p-1f,0x1.ffedbe0000000p-1f,0x1.ffee200000000p-1f,0x1.ffee820000000p-1f,0x1.ffeee00000000p-1f,0x1.ffef3c0000000p-1f,0x1.ffef980000000p-1f,0x1.ffeff00000000p-1f,0x1.fff0480000000p-1f,0x1.fff09c0000000p-1f,0x1.fff0f00000000p-1f,0x1.fff1420000000p-1f,0x1.fff1900000000p-1f,0x1.fff1de0000000p-1f,0x1.fff22c0000000p-1f,0x1.fff2760000000p-1f,0x1.fff2c00000000p-1f,0x1.fff3080000000p-1f,0x1.fff34e0000000p-1f,0x1.fff3920000000p-1f,0x1.fff3d60000000p-1f,0x1.fff4180000000p-1f,0x1.fff4580000000p-1f,0x1.fff4960000000p-1f,0x1.fff4d40000000p-1f,0x1.fff5100000000p-1f,0x1.fff54c0000000p-1f,0x1.fff5860000000p-1f,0x1.fff5be0000000p-1f,0x1.fff5f60000000p-1f,0x1.fff62c0000000p-1f,0x1.fff6620000000p-1f,0x1.fff6960000000p-1f,0x1.fff6c80000000p-1f,0x1.fff6fa0000000p-1f,0x1.fff72c0000000p-1f,0x1.fff75c0000000p-1f,0x1.fff78a0000000p-1f,0x1.fff7b80000000p-1f,0x1.fff7e40000000p-1f,0x1.fff8100000000p-1f,0x1.fff83c0000000p-1f,0x1.fff8660000000p-1f,0x1.fff88e0000000p-1f,0x1.fff8b60000000p-1f,0x1.fff8de0000000p-1f,0x1.fff9040000000p-1f,0x1.fff92a0000000p-1f,0x1.fff9500000000p-1f,0x1.fff9740000000p-1f,0x1.fff9980000000p-1f,0x1.fff9ba0000000p-1f,0x1.fff9dc0000000p-1f,0x1.fff9fe0000000p-1f,0x1.fffa1e0000000p-1f,0x1.fffa3e0000000p-1f,0x1.fffa5c0000000p-1f,0x1.fffa7c0000000p-1f,0x1.fffa9a0000000p-1f,0x1.fffab60000000p-1f,0x1.fffad20000000p-1f,0x1.fffaee0000000p-1f,0x1.fffb0a0000000p-1f,0x1.fffb260000000p-1f,0x1.fffb400000000p-1f,0x1.fffb5a0000000p-1f,0x1.fffb720000000p-1f,0x1.fffb8a0000000p-1f,0x1.fffba40000000p-1f,0x1.fffbba0000000p-1f,0x1.fffbd20000000p-1f,0x1.fffbe80000000p-1f,0x1.fffbfe0000000p-1f,0x1.fffc140000000p-1f,0x1.fffc2a0000000p-1f,0x1.fffc3e0000000p-1f,0x1.fffc520000000p-1f,0x1.fffc660000000p-1f,0x1.fffc7a0000000p-1f,0x1.fffc8e0000000p-1f,0x1.fffca00000000p-1f,0x1.fffcb20000000p-1f,0x1.fffcc40000000p-1f,0x1.fffcd60000000p-1f,0x1.fffce60000000p-1f,0x1.fffcf80000000p-1f,0x1.fffd080000000p-1f,0x1.fffd180000000p-1f,0x1.fffd280000000p-1f,0x1.fffd360000000p-1f,0x1.fffd460000000p-1f,0x1.fffd540000000p-1f,0x1.fffd640000000p-1f,0x1.fffd720000000p-1f,0x1.fffd800000000p-1f,0x1.fffd8c0000000p-1f,0x1.fffd9a0000000p-1f,0x1.fffda60000000p-1f,0x1.fffdb40000000p-1f,0x1.fffdc00000000p-1f,0x1.fffdcc0000000p-1f,0x1.fffdd80000000p-1f,0x1.fffde40000000p-1f,0x1.fffdf00000000p-1f,0x1.fffdfa0000000p-1f,0x1.fffe060000000p-1f,0x1.fffe100000000p-1f,0x1.fffe1a0000000p-1f,0x1.fffe240000000p-1f,0x1.fffe2e0000000p-1f,0x1.fffe380000000p-1f,0x1.fffe420000000p-1f,0x1.fffe4c0000000p-1f,0x1.fffe540000000p-1f,0x1.fffe5e0000000p-1f,0x1.fffe660000000p-1f,0x1.fffe700000000p-1f};
void reference_step(const float *state, float *targets, float *advanced) {
targets[0] = 0x1.d78b940000000p-1f * state[0] + 0x1.43a3800000000p-4f * state[5];
targets[1] = 0x1.88b2f80000000p+12f * (state[5] - targets[0]);
targets[2] = 0x1.7f68240000000p-11f * state[0] + 0x1.5e14120000000p-12f * state[1] + 0x1.353f4e0000000p-5f * state[2] + 0x1.2887180000000p-3f * state[3] + 0x1.a1fe360000000p-1f * state[4] + 0x1.c7ea340000000p-19f * state[5];
advanced[0] = 0x1.75f7540000000p-1f * state[0] + 0x1.1411500000000p-2f * state[5];
advanced[1] = 0x1.7709a20000000p-1f * state[0] + 0x1.11ecac0000000p-2f * state[5];
advanced[2] = 0x1.2ec74e0000000p-1f * state[0] + 0x1.afcbd80000000p-9f * state[1] + 0x1.254ec00000000p-2f * state[2] + 0x1.e70c2c0000000p-4f * state[5];
advanced[3] = 0x1.1c83f20000000p-1f * state[0] + 0x1.03b7d60000000p-8f * state[1] + 0x1.60e32c0000000p-2f * state[2] + 0x1.5a796c0000000p-11f * state[3] + 0x1.8563340000000p-4f * state[5];
advanced[4] = 0x1.0371860000000p-1f * state[0] + 0x1.3495a20000000p-8f * state[1] + 0x1.a3938e0000000p-2f * state[2] + 0x1.3d1c2e0000000p-8f * state[3] + 0x1.5a796c0000000p-11f * state[4] + 0x1.2c555e0000000p-4f * state[5];
advanced[5] = 0x1.0000000000000p+0f * state[5];
}
#define PWM_COMPARE_BITS 16u
#define CONTROL_CHANNELS 8u
#define REFERENCE_STATES 6u
#define FRAME_BITS 40u
#define ADC_BITS 18u
#define ADC_COMMAND_BITS 16u
#define ADC_TAG_BITS 4u
#define FIFO_WORD_BITS 32u
#define SAMPLES_PER_PAIR 2u
#define CARRIER_TICKS 800u
#define SAMPLE_TICKS 400u
#define FIFO_READY_TICKS 322u
#define COMPUTE_TICKS 640u
#define LATCH_TICKS 1600u
#define ADC_CURRENT_SCALE 0x1.99999a0000000p-13f
#define ADC_CURRENT_BIAS 0x1.9000000000000p+4f
#define COMMAND_CURRENT_LIMIT 0x1.6000000000000p+2f
