nikarus/levitating_chess/(commit log)

2026-05-30 Safety checkpoint: working snapshot before re-applying changes
    [levitating_chess_density_driven_bifilar_model.xlsx]
2026-05-30 Re-apply cleanly: 4mm cubes, lift-required operating point, passive surface-thermal model
    - magnet_cube_edge 3->4mm (B@coils 0.091->0.159T)
    - Operating point inverted to lift-required current (heat set by needed current, not max)
    - Add SurfaceThermal class (lumped RC, heat-spreader plane)
    - Selector picks coolest feasible config meeting safety margin
    - Two new surface-temp status checks; aluminum heat-spreader BOM line
    - Repair corrupted print_report tail
    [model.py]
2026-05-31 Add Propulsion model: lateral thrust, acceleration, hop/traverse times, yaw
    - Halbach Bx~By: same coils steer thrust; lateral capacity = sqrt(F_avail^2 - weight^2)
    - Reports max lateral accel (~1.17g), one-square hop ~0.14s, full-rank traverse ~0.38s
    - Yaw torque/inertia/angular accel (rotation is trivial: ~1073 rad/s2)
    - In-flight coil power at current limit
    - New maneuvering status check (>= 0.3g)
2026-05-31 Add Stability/vibration model: bounce + rock resonances, tilt sensing
    - Vertical bounce ~11.7 Hz, king rock mode ~3.3 Hz (tall inverted pendulum)
    - Control bandwidth 18x over rock mode -> dampable
    - Tilt sensing from differential eddy-current position: 5um/32mm baseline
    -> 0.16 mrad tilt, ~16um tip-position resolution
    - Two new checks: rock-mode-controllable, tilt-observable
    [model.py]
2026-05-31 Model position-addressed direct active-select drive (512 active coils, 43 drivers); add drive-matrix + checks; source TLC5947DAP
2026-05-31 Source TLC6C5912 (40V/50mA CC); constrain sweep by driver ratings -> 24V/0.04mm config, all 21 checks pass
2026-05-31 Driver: revert to TLC5947 (per-channel 12b PWM); at constrained 24V bus it fits 30V/30mA -> resolves per-channel control + voltage; 43 chips, all checks pass
    [model.py]
2026-05-31 Thermal: drop heat-spreader (factor=1); model 2s-hover/60s-cooldown periodic-cycling peak = 49.3C; remove aluminum baseplate from BOM
2026-05-31 BOM: verify lines on DigiKey; pick BSS138-7-F for coil-select FET; add DigiKey links (diode, MCU, LDC1614, mux, LC tag)
2026-05-31 BOM: source N52 magnet (Alibaba EUR0.0347@10k) and QA-1-155 0.04mm wire (AliExpress EUR34.39); one-line BOM rows with links; total ~1855
2026-05-31 BOM: add production_volume=100; show program total + per-board cost; magnet MOQ now satisfied
2026-05-31 BOM: apply real DigiKey volume price breaks (TLC5947 2.799, BSS138 0.028, 1N4148 0.0213, mux 0.3405, LDC1614 2.249, MCU 8.66)
2026-05-31 BOM: switch magnet wire to bulk Alibaba UEW solid copper ($18.74/kg vs $37.14)
2026-05-31 Add mass budget: whole set ~16.9 kg (board 15.0 kg, pieces 2.0 kg)
2026-05-31 Coil geometry: add outer height, group width/length/height/footprint together
2026-05-31 Make winding-power explicit via simultaneous_active_winding_factor (default 1=quadrature hover); factor=2 worst case breaks thermal (63.6C)
2026-05-31 Remove simultaneous_active_winding_factor: always 1 under bifilar bidirectional drive (one filament conducts at a time)
2026-05-31 Size driver pool for lift+thrust look-ahead; replace single MCU with tiled distributed control (per-tile MCU + host), add compute-budget check; show BOM per-board
    [model.py]
2026-05-31 Real DigiKey price for tile MCU (STM32G431KBT6 $3.13@2.5k); clarify 10x10cm square tile label; host computer doubles as UI/chess.com brain
2026-05-31 Source PSU (Mean Well LRS-450-24 $45.40) + brain (RPi5 4GB $60); add power-budget/PSU class+check; restructure BOM into per-tile/per-piece/board-shared with per-tile driver provisioning
2026-05-31 Swap Pi 5 SBC for RPi CM5 2GB Lite on custom mainboard/backplane; add tile interconnect connectors
    [model.py]
2026-05-31 Use verified CM5 2GB Lite SC1556 (57.37 EUR / $61.96), wire onboard GbE for chess.com
2026-05-31 Re-spec drive: replace TLC5947 LED sink with DRV8912 H-bridge motor driver; single-winding bidirectional coils; relax optimizer to 40V/1A envelope; drop external flyback diodes; 2 select switches/coi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
    [model.py]
2026-05-31 Model phase-grouped commutation: size drivers by phase drives, not per-coil
2026-05-31 Size drivers for full 6-DOF: independent per-coil drive (tilt+rotate)
2026-05-31 Add attitude authority (tilt/yaw torque) check
2026-05-31 Set achievable 10deg tilt target; fix safety-check label
    [model.py]
2026-06-01 Mass budget: replace arbitrary 1.3x copper multiplier with explicit additive PSU/frame/electronics estimate
    [model.py]
2026-06-01 Make coil winding height force-driven (sized to binding tilt/lift/thermal requirement, not fixed 3.5mm); thin piece wall to 1.0mm
    [model.py]
2026-06-01 Remove max_coil_height input (bound coil height by its own width); trim PSU/frame/electronics mass estimate to 2.0kg
2026-06-02 Cap bus at DRV8912 32V limit; make PSU follow selected bus voltage
2026-06-02 Replace unproven coil-multiplexing matrix with dedicated per-coil drivers (wye half-bridge topology); remove pooling orphans
    [model.py]
2026-06-02 Switch PSU to fanless Mean Well UHP-350 series (silent operation); trim PSU mass
2026-06-02 Remove explanatory code comments; add unit annotations to Inputs and Fixed
    [model.py]
2026-06-02 Fix mux/drive voltage conflict: 12V-rated ADG1206 mux + sense-mux-voltage check; source real price
    [model.py]
2026-06-02 Switch sense mux to cheap 18V-rated CD4067B (Ron 125 ohm at 15V rail); drop unused DriveMatrix config param
2026-06-02 Source real CD4067BM96 price from DigiKey ($0.368 qty-20k); keep typical 125 ohm Ron
2026-06-02 Fix drive topology (center-tap Vbus/2, halve usable swing) and decouple sensing onto low-voltage PCB sense spirals with proper tank-Q check; revert to cheap HC4067 mux
    [model.py]
2026-06-02 Reorganize: move reference PDFs into articles/, remove xlsx model and backups, update PRODUCT_VISION
    [levitating_chess_density_driven_bifilar_model.xlsx]
2026-06-03 Add Halbach spatial winding form factor (2/pi) to force_per_amp; honest commutated worst-case lift/thrust
2026-06-03 Octagonal magnet footprint: corner standoff vs lift trade; fix total_force form-factor consistency; add PSU adequacy to sweep feasibility
    [model.py]
2026-06-04 Switch position sensing from inductive LDC to Hall-sensor grid (density from magnet-array size, per tile); drop piece ID tag (identity via continuous tracking)
2026-06-08 switching to the flat wire
2026-06-15 Add low-noise active cooling model
    [model.py]
2026-06-16 Add discrete driver model and saved run output
2026-06-16 Model sparse Hall sensor grid
2026-06-16 Model feasible 24V coil drive
2026-06-17 Model current-regulated coil drivers
2026-06-18 Use lower-cost BOM sourcing
2026-06-21 Model rectangular magnets and streamline simulation
2026-10-05 BOM removed because it contained history
2026-10-09 Refine levitation model and add shared CAD geometry
    [coil_assembly.FCStd, coil_assembly.step, coil_assembly_exploded.FCStd, coil_assembly_exploded.step, single_coil.FCStd, single_coil.step]
2026-10-15 Verify coupled airborne simulation and organize methodology
2026-10-16 Verify joint airborne integration and exact checkpoint replay
2026-10-17 Validate accelerated magnetic backend and sensing accuracy
2026-10-18 Accelerate magnetic evaluation and verify native hover
2026-10-22 Add electronics simulation study and coil-channel comparison
    Electronics stream: KiCad channel/acquisition/controller/protection/group
    schematics, DRV8962 + separate return shunts + INA181A1 + ADS8698 candidate
    chain, ngspice vendor-model replays, physical bridge/filter plant with
    compiled C eight-coil regulation, watchdog/fault screens, shared-bus and
    regeneration sizing, placement/CAD exports and dated sourcing scenarios.
    Coil-channel density study: static authority screens, pose comparison and
    parameter sweep of square/parquet/paired arrangements (no geometry adopted).
    Raw ngspice transient.dat traces, electronics .npz solver traces and the
    833 MB diagnostics.zip are excluded via .gitign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
